galopago/misistemhil/README.md

# MISISTEMHIL

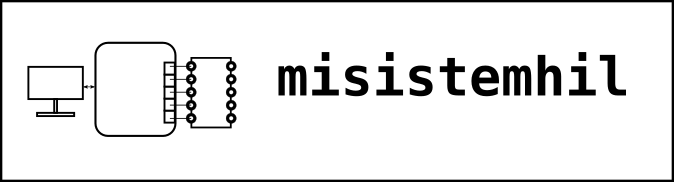
[picture p1: assets/img/misistemhil-logo.png]


## INTERFACE FOR AUTOMATED TESTS (HARDWARE-IN-THE-LOOP). SOLDERLESS, MODULAR AND OPEN SOURCE

Electronic hardware prototyping system. Solderless, robust and open source. Solves the typical problem of the circuit that works on a breadboard but stops working on a real-world setup. Easy to replicate and compatible with virtually every electronic module.

Misistemhil is an open source project by [Galopago](https://galopago.github.io/)
