galopago/misistemhil/b-hil-boards/b06_hil/firmware/docs/i2c_bus_architecture.md

# Generic Shared I2C Bus Architecture

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

Source handoff: `agent-workspaces/architect/handoff.md`, `I2C_BUS_ARCHITECTURE`.

Board electrical details for the current target remain in
`docs/esp32_c3_supermini_connections.md`.

## Normative Language

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

## Design Goals

1. **One bus owner.** Exactly one module initializes and owns the shared master
   bus.
2. **Device-agnostic bus.** The bus layer knows 7-bit addresses and opaque device
   handles, not OLED, INA219, or any other peripheral type.
3. **Deterministic implementer output.** File layout, API names, init order, and
   caching rules are fixed in this document.
4. **MCU portability.** Portable semantics are defined first; ESP-IDF is the current
   platform binding, not the architectural center.
5. **Optional peripherals.** Projects without INA219 omit that driver and its
   startup calls. The bus component stays unchanged.

## Three-Layer Model

```mermaid
flowchart TD
    subgraph portable [PortableLogicalLayer]
        I2cBusApi[i2c_bus public API]
        DeviceDrivers[device drivers]
    end
    subgraph boardLayer [BoardLayer per target]
        BoardPins[board pins and addresses]
        BoardHelper[board_i2c_bus_config]
    end
    subgraph platform [PlatformPort per MCU SDK]
        PlatformI2c[SDK I2C master driver]
    end
    AppCore[app_core startup] --> BoardHelper
    AppCore --> I2cBusApi
    AppCore --> DeviceDrivers
    BoardHelper --> I2cBusApi
    DeviceDrivers --> I2cBusApi
    I2cBusApi --> PlatformI2c
    BoardPins --> BoardHelper
```

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

## Fixed Component Layout

Implementations MUST use this layout:

```text
components/i2c_bus/
  CMakeLists.txt
  include/
    i2c_bus.h          # portable public contract
  i2c_bus.c            # portable logic + platform calls
```

Optional future split if a second MCU is added:

```text
components/i2c_bus/
  port/
    esp_idf/i2c_bus_port.c
    stub/i2c_bus_port.c
```

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

## Portable Public Contract

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

### Constants

```text
I2C_BUS_DEFAULT_FREQUENCY_HZ = 400000
I2C_BUS_MAX_DEVICES = 8
I2C_BUS_PROBE_TIMEOUT_MS = 50
I2C_BUS_ADDRESS_MIN = 0x08
I2C_BUS_ADDRESS_MAX = 0x77
```

7-bit addressing is mandatory. 10-bit addressing is out of scope.

### Types

```c
typedef struct {
    int scl_pin;              /* board-defined pin identifier */
    int sda_pin;              /* board-defined pin identifier */
    uint32_t bus_frequency_hz;
} i2c_bus_config_t;

typedef struct i2c_bus_device *i2c_bus_device_t;
```

Notes for implementers:

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

### Functions

```c
status_t i2c_bus_init(const i2c_bus_config_t *config);
status_t i2c_bus_add_device(uint8_t address, i2c_bus_device_t *out_device);
status_t i2c_bus_probe(uint8_t address, bool *present);
void i2c_bus_deinit(void);
```

`status_t` represents success or a platform-mapped error. In this tree the
implementer uses `esp_err_t`.

## Canonical Behavior

### State machine

```text
UNINITIALIZED
  -- i2c_bus_init(success) --> BUS_READY
BUS_READY
  -- i2c_bus_add_device(success) --> BUS_READY with cached device
  -- i2c_bus_probe(...) --> BUS_READY
  -- i2c_bus_deinit() --> UNINITIALIZED
```

Rules:

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

### `i2c_bus_init(config)`

Input validation:

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

Postconditions on success:

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

### `i2c_bus_add_device(address, out_device)`

Input validation:

- `out_device` MUST NOT be null.
- `address` MUST be within `0x08` to `0x77`.

Caching algorithm:

```text
add_device(address):
  if address already cached:
    return existing handle
  if device table full:
    return NO_MEM
  create platform device handle at address and effective bus frequency
  store in cache
  return handle
```

Rules:

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

### `i2c_bus_probe(address, present)`

Input validation:

- `present` MUST NOT be null.
- `address` MUST be within `0x08` to `0x77`.

Algorithm:

```text
probe(address):
  perform short master presence check with timeout I2C_BUS_PROBE_TIMEOUT_MS
  if device ACKs:
    present = true
    return success
  if no ACK / not found:
    present = false
    return success
  otherwise return transport error
```

Rules:

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

### Concurrency (baseline)

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

## Incremental Concurrency Architecture

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

Source handoff: `agent-workspaces/architect/handoff.md`, `I2C_BUS_CONCURRENCY`.

### Immutable rules (all phases)

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

### Problem classes

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

### Growth model

```mermaid
flowchart TD
    subgraph phase1 [Phase1_DirectSync]
        AppInit[app_core init] --> I2cBusDirect[i2c_bus init probe add_device]
    end
    subgraph phase2 [Phase2_TransactionExecutor]
        DisplayTask[display_task] --> Transceive[i2c_bus_transceive]
        SensorTask[sensor tasks] --> Transceive
        Transceive --> PortLayer[platform I2C + optional bus mutex]
    end
    subgraph phase3 [Phase3_Broker]
        DisplayTask2[display_task] --> Broker[i2c_broker]
        Ina219Task[ina219_task] --> Broker
        DiagHooks[diag hooks] --> Broker
        Broker --> Transceive2[i2c_bus_transceive executor]
        Transceive2 --> PortLayer2[platform I2C]
    end
```

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

`b06_hil` MUST be designed for phase 3, but implementers MUST deliver one phase
per authorized handoff.

### Phase 1 — Direct sync

Scope:

- `i2c_bus_init`, `i2c_bus_add_device`, `i2c_bus_probe`, `i2c_bus_deinit`
- Sequential startup in `app_core`

Rules:

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

Handoff ID: `I2C_BUS_PHASE1` (same scope as initial `I2C_BUS_ARCHITECTURE`
implementation).

### Phase 2 — Transaction executor

Add to the public contract:

```c
typedef struct {
    i2c_bus_device_t device;
    const uint8_t *tx;
    size_t tx_len;
    uint8_t *rx;
    size_t rx_len;
    uint32_t timeout_ms;
} i2c_transaction_t;

status_t i2c_bus_transceive(const i2c_transaction_t *txn);
```

Behavior:

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

Handoff ID: `I2C_BUS_PHASE2`.

### Phase 3 — Priority broker

Add component API:

```c
typedef enum {
    I2C_CLIENT_DISPLAY = 0,
    I2C_CLIENT_INA219,
    I2C_CLIENT_DIAG,
} i2c_client_id_t;

typedef struct {
    i2c_client_id_t client;
    uint8_t priority;
    i2c_transaction_t txn;
} i2c_broker_request_t;

status_t i2c_broker_start(void);
void i2c_broker_stop(void);
status_t i2c_broker_submit(const i2c_broker_request_t *req, uint32_t wait_ms);
```

Rules:

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

Recommended `b06_hil` priority table:

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

Policy rules:

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

Handoff ID: `I2C_BUS_PHASE3`.

### Phase 4 — Observability (optional)

Optional debug-only counters:

- requests submitted
- requests completed
- timeouts
- queue drops

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

Handoff ID: `I2C_BUS_PHASE4`.

### Growing component layout

Base layout:

```text
components/i2c_bus/
  include/i2c_bus.h
  i2c_bus.c
  CMakeLists.txt
```

Phase 2 adds transaction execution to `i2c_bus.c`.

Phase 3 adds:

```text
components/i2c_bus/
  include/i2c_broker.h
  i2c_broker.c
```

Optional future platform split:

```text
components/i2c_bus/
  port/esp_idf/i2c_bus_port.c
```

### Driver migration contract

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

The shape of `i2c_transaction_t` MUST remain stable across phases 2 and 3.

### Anti-patterns (forbidden)

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

## Board Integration Contract

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

Required helper:

```c
void board_i2c_bus_config(i2c_bus_config_t *out_config);
```

Behavior:

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

Example address macros for `b06_hil`:

```text
BOARD_OLED_ALLOWED = [0x3C, 0x3D]
BOARD_INA219_ADDRESSES = [0x40, 0x41, 0x42]
```

Other boards MAY omit INA219 macros entirely.

## Application Startup Contract

Startup MUST follow this order:

```text
1. board_i2c_bus_config()
2. i2c_bus_init()
3. for each enabled peripheral in this firmware:
     resolve address policy
     i2c_bus_add_device(address)
     pass handle to the device driver boundary
4. start higher-level services (display task, sensor tasks, etc.)
```

### Address resolution policy

Address discovery belongs to **application startup** or the **device driver
init path**, not to `i2c_bus` internals.

Canonical OLED policy for this repository:

```text
if display_config.has_address:
  use display_config.address
else:
  probe 0x3C
  if not present, probe 0x3D
  if found, set has_address = true
  if not found, continue without I2C device handle
```

Rules:

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

### `b06_hil` profile

| Step | Action |
| --- | --- |
| 1 | `board_i2c_bus_config()` using GPIO0/GPIO1 |
| 2 | `i2c_bus_init()` |
| 3 | Resolve OLED address with policy above |
| 4 | `i2c_bus_add_device(oled_address)` when found |
| 5 | Pass handle through `display_config_t` to `display_start()` |
| 6 | Future optional: register `0x40`, `0x41`, `0x42` for INA219 when component exists |

### Display-only profile

Steps 1 through 5 only. No INA219 component, no INA219 startup calls.

## Device Driver Boundary

Device drivers MUST receive an opaque `i2c_bus_device_t`. They MUST NOT call
`i2c_bus_init()` themselves.

### Display driver

Only `display_driver` in the display stack may consume the handle.

`display_config_t` MUST include:

```c
uint8_t address;
bool has_address;
i2c_bus_device_t i2c_device;
bool has_i2c_device;
```

Rules:

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

### Future INA219 driver (optional component)

Expected shape:

```c
status_t ina219_init(i2c_bus_device_t device, ...);
status_t ina219_read(i2c_bus_device_t device, ...);
```

After phase 2, read/write paths MUST use `i2c_bus_transceive`. After phase 3,
they MUST use `i2c_broker_submit`.

`b06_hil` expects three instances at `0x40`, `0x41`, and `0x42`. Other projects
omit the component.

## ESP-IDF 5.x Platform Profile (Current Target)

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

- Header: `driver/i2c_master.h`
- Bus create: `i2c_new_master_bus`
- Device add: `i2c_master_bus_add_device`
- Presence check: `i2c_master_probe`
- Bus delete: `i2c_del_master_bus`

Binding rules:

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

## Porting To Another Microcontroller

To port, keep these unchanged:

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

Replace only the platform port internals:

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

Porting checklist:

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

## Forbidden Dependencies

`i2c_bus` MUST NOT depend on:

- `display`, `display_driver`, renderer, canvas, controller
- future `ina219`
- application modules

`i2c_broker` MUST depend only on `i2c_bus` and RTOS primitives.

`display` renderer/controller/task MUST NOT depend on `i2c_bus` or `i2c_broker`.

`board` MAY depend on `i2c_bus` only for the config helper type, not for init.

## Non-Goals

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

## Acceptance Criteria

An implementation satisfies this architecture if:

- `components/i2c_bus/` matches the fixed layout and public contract for the
  active phase.
- Behavior matches the canonical algorithms, startup order, and active concurrency
  phase.
- `board` remains the source of pin and address constants for the PCB.
- `app_core` initializes the bus before display or sensor drivers.
- Display renderer/controller code contains no I2C or GPIO references.
- A display-only firmware reuses `i2c_bus` without source changes.
- `b06_hil` can attach OLED and INA219 clients to the same shared bus.
- Another LLM implementer can read only this document and produce substantially
  similar module boundaries, file paths, and runtime behavior.

### Phase acceptance criteria

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

## Suggested Validation

Implementer/build validation:

- Project builds on the current ESP-IDF target for the active phase only.

Tester/hardware validation:

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

Additional validation when peripherals exist:

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
