galopago/misistemhil/b-hil-boards/b03_hil/firmware/agent-workspaces/implementer/backlog.md

# Implementer backlog — `b03_hil`

- [x] Scaffold / pins / relay_ctrl / host v1+v2 / OE fix
- [x] Main relay OLED + view-mode `P`/`T`/`E` binding
- [x] **OLED column order** `1|4` / `2|5` / `3|6` (`B03_RELAY_OLED_COLUMN_ORDER`)
- [ ] Hand off to tester (visual column match vs hardware)
