galopago/misistemhil/b-hil-boards/b03_hil/firmware/agent-workspaces/architect/backlog.md

# Architect backlog — `b03_hil`

- [x] Import base docs + particular stubs
- [x] Fill hardware/functional from PCB
- [x] Freeze product / relay / host API architecture
- [x] OE level-before-direction RCA
- [x] Main relay OLED `N:[X]` layout
- [x] OLED view-mode binding for pulse/hold/train/encoder
- [ ] (After implementer+tester) close dynamic OLED token acceptance
- [ ] Absorb future `BASE-CHANGE-*` from `b00_basehil` when they appear
