galopago/misistemhil/b-hil-boards/b06_hil/firmware/agent-workspaces/architect/backlog.md

# Architect Backlog — `b06_hil`

- [x] Record `b06_hil` functional particularities
- [x] Record `b06_hil` hardware / pin map from `../pcb/`
- [x] Authorize `B06_MAIN_METERING_OLED` (INA219 + main OLED)
- [x] Freeze host API metering commands (`B06_HOST_API_METERING`)
- [x] Absorb `BASE-CHANGE-20261103-6` (4 MB flash docs; implementer owns csv/sdkconfig)
- [ ] Confirm BOM values (shunts, polyfuses, LED resistors) and OLED address
- [ ] Review implementer completion of `B06_MAIN_METERING_OLED` (tester evidence)
- [ ] Review implementer completion of `B06_HOST_API_METERING` when firmware lands
- [ ] Review implementer application of 4 MB `partitions.csv` / sdkconfig
