galopago/misistemhil/b-hil-boards/b00_basehil/firmware/agent-workspaces/architect/handoff.md

# Architect Handoff

All agentic development methodology documentation in this firmware tree is
maintained in English.

Before starting any task in this file, run the **Role Boundary Check**:

- Read `ROLE.md` in this folder, `../../AGENTS.md`, and `../../docs/methodology.md`.
- Confirm the request is **architecture and documentation**, not firmware
  implementation, builds, or formal validation.
- If the task includes code, tests, or flash steps, stop and tell the human that
  the implementer or tester must execute those parts unless explicitly
  redirected.

## Current Status

Active handoffs:

- `HOST_API_CAPABILITIES_ECHO_LOOPBACK` (**implementer package closed** 2026-11-03 — firmware pending)
- `EXTERNAL_HOST_API_V1_CONCEPT` (**docs complete** 2026-11-03 — firmware pending; extended by capabilities/demos)
- `OLED_CONNECTED_MDNS_HOSTNAME_LINE` (**implemented** 2026-11-03)
- `OLED_CONNECTED_IP_WIDTH_FIT` (**superseded by** `OLED_CONNECTED_MDNS_HOSTNAME_LINE`)
- `WIFI_FACTORY_RESET_MDNS_SAFE` (**implemented** 2026-11-03 — Run 025 fix)
- `OLED_TEXT_DISPLAY_INTERFACE`
- `I2C_BUS_ARCHITECTURE`
- `I2C_BUS_CONCURRENCY`
- `QR_ENCODER_INTERFACE`
- `DISPLAY_DELIVERY_CONTRACT`
- `WIFI_PROVISIONING_ARCHITECTURE`
- `WIFI_PROVISIONING_PORTAL_REACHABILITY`
- `WIFI_PROVISIONING_HTTP_STACK_SAFETY`
- `WIFI_PROVISIONING_HTTP_HEADER_BUDGET`
- `WIFI_PROVISIONING_POST_SUCCESS_COMMIT`
- `WIFI_PROVISIONING_SAVED_BOOT_RELIABILITY`
- `PRODUCT_BOOT_DISPLAY_AND_DYNAMIC_AP_SSID`
- `OLED_PROVISIONING_SETUP_UX`
- `OLED_WIFI_CONNECTED_STATUS`
- `ERROR_LED_WIFI_LINK_STATUS`
- `ERROR_LED_RUNTIME_LINK_STATUS`
- `WIFI_RUNTIME_RECONNECT`
- `WIFI_CONNECT_CYCLE_AND_ERROR_LED_V2`
- `WIFI_FACTORY_RESET_RUNTIME`
- `WIFI_PROVISIONING_FIRST_CONNECT_FAILURE_FLOW`
- `WIFI_PROVISIONING_FIRST_CONNECT_FAILURE_UX_V2` (**approved** 2026-06-28 — implementer authorized)
- `DEVICE_DISCOVERY_MDNS_V1`
- `HIL_BASE_REUSE_CONTRACT` (**docs complete** 2026-11-02; **pillars extension** 2026-11-02 — no implementer firmware work)

- `FLASH_4MB_LARGE_FACTORY` (**docs complete** 2026-11-03 — config already in tree;
  build/flash by implementer/tester)
- `HOST_API_AFTER_PORTAL_TEARDOWN` (**docs complete** 2026-11-03 — firmware pending;
  closes `TESTER_RETURN_HOST_API_AFTER_PROVISION` / Run 029)

Family reuse of this base (contracts-first, no submodule) is recorded in
`docs/hil_base_reuse_contract.md`. Base pillars (WiFi onboarding, network
detection, external host API) vs board particulars are delimited in
`docs/hil_base_platform_scope.md`; LLM propagation uses
`docs/hil_base_spec_changelog.md`. Summarized in `docs/architecture.md`.
I2C pins, OLED address candidates, `INA219` addresses, error LED polarity, and
factory reset switch polarity are recorded in
`docs/esp32_c3_supermini_connections.md`. Generic shared I2C bus structure and
incremental concurrency phases are recorded in
`docs/i2c_bus_architecture.md`. QR encoder rules and `http://IPv4` payload
profile are recorded in `docs/qr_encoder_interface.md`. Display delivery from
producers to the OLED stack is recorded in
`docs/display_delivery_contract.md`. WiFi provisioning AP, HTTP portal, NVS
credential storage, and factory-reset behavior are recorded in
`docs/wifi_provisioning_architecture.md`. The implementer must keep WiFi
provisioning display requests routed through `app_core` and must not couple
display internals to WiFi/network headers.

## HIL_BASE_REUSE_CONTRACT

```text
Role boundary check:
  Architect-owned documentation only. No components/, main/, sdkconfig, or
  idf.py. No implementer firmware tasks for this handoff.
ID: HIL_BASE_REUSE_CONTRACT
Date: 2026-11-02
Source:
  - Human request: document b00_basehil as shared family base for LLM reuse
    without git submodule or sub-repo packaging.
Objective:
  Record that this firmware tree is the shared HIL platform base: normative
  docs/contracts are the shared surface; local code is a reference
  implementation that sibling bNN_hil trees may read or adapt into their own
  firmware trees without build-time coupling.
Reason:
  The product line is a board family. Agents working on derivative boards must
  know what is shared, what is board-owned, how to consume base contracts, and
  that packaging via submodule/sub-repo/EXTRA_COMPONENT_DIRS is forbidden.
Authorized files:
  - docs/hil_base_reuse_contract.md (new)
  - docs/architecture.md
  - AGENTS.md
  - README.md
  - agent-workspaces/architect/handoff.md
  - agent-workspaces/architect/decisions.md
Expected changes:
  - Publish docs/hil_base_reuse_contract.md with mission, reuse model,
    shared vs board-owned surfaces, derivative agent brief, change ownership,
    and non-goals.
  - Add Shared Base Role section to docs/architecture.md with summary diagram
    and link to the contract.
  - Add short pointers in AGENTS.md and README.md.
  - Record this handoff and the architecture decision.
Module boundaries and contracts:
  - Shared platform behavior remains governed by existing normative docs under
    docs/ (provisioning, display, I2C, identity/mDNS, error LED, factory reset,
    methodology).
  - Board number, pins, PCB, and product-only features remain board-owned.
  - Derivative trees must not rewrite base contracts in place; family-wide
    contract changes are decided in b00_basehil.
Non-goals:
  - Creating firmware for b06_hil or other sibling boards.
  - Extracting a shared CMake/component package.
  - Changing role methodology or architect hard stop.
  - Marking any implementer code task as implemented.
Acceptance criteria:
  - docs/hil_base_reuse_contract.md exists and states contracts-first reuse
    with explicit rejection of submodule/sub-repo/build-path coupling.
  - docs/architecture.md summarizes the shared-base role and links the contract.
  - AGENTS.md and README.md point agents to the contract.
  - decisions.md records HIL_BASE_REUSE_CONTRACT.
  - No firmware source or build config files are modified by this handoff.
Open questions:
  - None.
```

## HIL_BASE_REUSE_CONTRACT — pillars and particular file separation

```text
Role boundary check:
  Architect-owned documentation only. No components/, main/, sdkconfig, or
  idf.py. Host API behavioral schemas remain pending in a reserved base doc.
ID: HIL_BASE_REUSE_CONTRACT (extension)
Date: 2026-11-02
Source:
  - Human request: document that this base repo keeps WiFi onboarding, network
    board detection, and external host communication methodology; particulars
    in each board repo; base vs particular in separate files; LLM-traceable
    base change propagation.
Objective:
  Delimit the three base pillars, require separate particular-spec files in
  board repos, reserve external_host_api_architecture.md as pillar 3 home, and
  add hil_base_spec_changelog.md so agents can find base deltas and sync them.
Authorized files:
  - docs/hil_base_platform_scope.md (new)
  - docs/hil_base_spec_changelog.md (new)
  - docs/hil_board_particular_spec_template.md (new)
  - docs/external_host_api_architecture.md (new; reserved / detail pending)
  - docs/hil_base_reuse_contract.md
  - docs/architecture.md
  - AGENTS.md
  - README.md
  - agent-workspaces/architect/handoff.md
  - agent-workspaces/architect/decisions.md
Expected changes:
  - Publish platform scope with pillars, particular surface, file separation,
    and LLM propagation workflow.
  - Publish append-only base changelog with BASE-CHANGE-20261102-1.
  - Publish particular-repo template including board_base_sync_log.md pattern.
  - Reserve external host API doc with open decisions listed.
  - Retarget reuse contract and architecture summary to the pillar model.
Non-goals:
  - Filling complete host API schemas in this extension.
  - Creating bNN_hil particular docs inside those board repos in this task.
  - Firmware or build work.
Acceptance criteria:
  - Three pillars are explicit in hil_base_platform_scope.md and reuse contract.
  - Base vs particular must use different files; template provided.
  - Changelog + sync-log workflow documented for LLM propagation.
  - external_host_api_architecture.md exists as sole family host API home.
Open questions:
  - Host API transport, schema, auth, and mandatory ops (listed in that doc).
```

## HIL_BASE_REUSE_CONTRACT — particular functional + hardware docs

```text
Role boundary check:
  Architect documentation only. No firmware edits.
ID: HIL_BASE_REUSE_CONTRACT (extension)
Date: 2026-11-02
Source:
  - Human request: each board needs a separate functional description (e.g.
    RS-485, relays, logic analyzer) and a separate hardware description
    (MCU may differ; pin map varies).
Objective:
  Require board_functional_description.md and board_hardware_description.md as
  mandatory, separate particular files; clarify they are not base pillars.
Expected changes:
  - Update particular template with required sections for both docs.
  - Update platform scope, reuse contract, architecture, AGENTS.md.
  - Append BASE-CHANGE-20261102-2.
Non-goals:
  - Authoring particular docs inside sibling board repos in this session.
  - Changing base MCU/pin docs for b00_basehil beyond referencing them as
    base-profile-only.
Acceptance criteria:
  - Template mandates separate functional and hardware particular docs.
  - Changelog entry instructs boards to create those files.
Open questions:
  - None for this extension.
```

## HIL_BASE_REUSE_CONTRACT — filled particular example for b00_basehil

```text
Role boundary check:
  Architect documentation only.
ID: HIL_BASE_REUSE_CONTRACT (extension)
Date: 2026-11-02
Source:
  - Human request: fill this repo's particular functional + hardware docs from
    existing pin/hardware records; mission = base reference with minimum
    human-supervised test hardware; preserve philosophy when copied elsewhere.
Objective:
  Create filled docs/board_functional_description.md and
  docs/board_hardware_description.md (plus scope, host extensions, sync log)
  specific to b00_basehil ESP32-C3 SuperMini bench.
Acceptance criteria:
  - Functional doc states base/reference + minimum human-supervised tests.
  - Hardware doc lists SuperMini, GPIO0/1/7/8, OLED addresses (no INA on base
    test profile) from docs/esp32_c3_supermini_connections.md and board_pins.h.
  - Template notes this tree as the copyable example.
  - BASE-CHANGE-20261102-3 recorded.
Open questions:
  - None.
```

## FLASH_4MB_LARGE_FACTORY

```text
Role boundary check: architect documentation only (no idf.py).
ID: FLASH_4MB_LARGE_FACTORY
Date: 2026-11-03
Source: Human — document flash/partition decision as lasting architecture base.
Objective: Normative record of 4MB flash + large single factory partition.
Authorized docs:
  - docs/flash_partition_architecture.md (new; authoritative)
  - docs/architecture.md, board_hardware_description.md
  - docs/hil_base_platform_scope.md, hil_base_reuse_contract.md
  - docs/hil_base_spec_changelog.md (BASE-CHANGE-20261103-6)
  - agent-workspaces/architect/handoff.md, decisions.md
  - docs/board_base_sync_log.md, board_particular_scope.md
Normative summary:
  - Flash 4MB; custom partitions.csv factory 0x3F0000 @ 0x10000; NVS 0x9000
  - No dual-OTA yet; siblings must not assume old 1MB factory
Config already present: partitions.csv, sdkconfig.defaults (and sdkconfig)
Build validation: implementer/tester only (architect does not compile).
Open questions: None.
```

## HOST_API_AFTER_PORTAL_TEARDOWN

```text
Role boundary check:
  Architect docs only. Firmware pending implementer.
ID: HOST_API_AFTER_PORTAL_TEARDOWN
Date: 2026-11-03
Source:
  - Tester Run 029 FAIL / TESTER_RETURN_HOST_API_AFTER_PROVISION
  - Human: improve architecture so implementer can fix post-reprovision host API
Objective:
  Host API must come up after SoftAP portal httpd releases port 80 without
  requiring a reboot; saved-boot path must keep working.
Diagnosis (normative):
  POST /provision success emits CONNECTED while SoftAP httpd still owns :80
  (2 s grace teardown). host_api_start() bind fails; error discarded; teardown
  frees port but nothing restarts host_api. Saved boot has no SoftAP httpd → PASS.
Wire contracts:
  - docs/external_host_api_architecture.md § Port 80 exclusivity
  - docs/wifi_provisioning_architecture.md § Deferred AP and HTTP teardown
  - BASE-CHANGE-20261103-5
Authorized files (implementer — pending):
  - components/wifi_provisioning/include/wifi_provisioning.h
      add WIFI_PROV_EVENT_PORTAL_TEARDOWN_COMPLETE
  - components/wifi_provisioning/wifi_provisioning.c
      emit that event at end of success_teardown_task after httpd_stop,
      STA-only mode, s_portal_active=false (do NOT call host_api from here)
  - components/app_core/app_core_wifi.c
      on PORTAL_TEARDOWN_COMPLETE + CONNECTED → host_api_start(); log ESP_LOGE
      on failure; CONNECTED-path host_api_start may WARN if bind fails while
      portal httpd still up; do not rely on that alone for POST path
  - agent-workspaces/implementer/handoff.md notes
Non-goals:
  - Merging SoftAP and STA into one httpd
  - Moving host API off port 80 in this fix
  - Requiring reboot after POST success
Acceptance (firmware + tester):
  1. Factory reset + POST provision, NO reboot: after teardown (~2 s + margin),
     TCP :80 accepts; curl ping on HIL-00-XXXX.local or STA IP succeeds.
  2. Saved-credential cold boot: host_api started still PASS (Run 028 regression).
  3. SoftAP portal path: no /v1 while portal httpd up.
  4. Serial shows host API started after portal teardown on POST path
     (not only on cold boot).
Open questions:
  - None.
```

## HOST_API_CAPABILITIES_ECHO_LOOPBACK

```text
Role boundary check:
  Architect documentation only for this update. Firmware is pending
  implementer (do not write components/ or main/ from architect role).
ID: HOST_API_CAPABILITIES_ECHO_LOOPBACK
Date: 2026-11-03
Source:
  - Human: agent must ask the board (not the repo); base FW demos echo +
    loopback; close handoff so implementer cannot diverge on structure.
Objective:
  Implementation-ready family host API + b00 demos (ask-the-board).
Wire contracts (normative behavior):
  - docs/external_host_api_architecture.md
  - docs/external_host_command_api.md
  - docs/external_host_stream_api.md
  - docs/board_host_api_extensions.md
Follow-on: HOST_API_AFTER_PORTAL_TEARDOWN required before POST-provision
  path is accepted (Run 029).
```

### Implementer package (firmware — PENDING)

Temporary shared-file owner for this handoff: **implementer**.

#### Expected new files

```text
components/host_api/CMakeLists.txt
components/host_api/include/host_api.h
components/host_api/host_api.c              # httpd lifecycle + route registration
components/host_api/host_api_command.c      # POST /v1/command dispatch + handlers
components/host_api/host_api_stream.c       # POST /v1/stream/* + loopback queue
components/host_api/host_api_capabilities.c # embedded b00 manifest (const data)
```

Do **not** put host API handlers inside `wifi_provisioning` or `display`.
Do **not** add routes to the SoftAP portal httpd instance.

#### Expected edited files

```text
components/app_core/CMakeLists.txt          # REQUIRES host_api
components/app_core/app_core_wifi.c         # start/stop host_api with discovery window
agent-workspaces/implementer/handoff.md     # record implementation notes
```

`main/` stays thin: no host_api calls from `app_main.c` (orchestration stays in
`app_core`).

#### Public C API (`host_api.h`)

```c
#pragma once
#include "esp_err.h"
#include <stdbool.h>

#ifdef __cplusplus
extern "C" {
#endif

/** Start STA host API HTTP server on port 80. Idempotent if already running. */
esp_err_t host_api_start(void);

/**
 * Stop host API, close any stream session, free RX queue.
 * reason: short log tag only ("link_lost", "portal", "shutdown", …).
 * Idempotent if already stopped.
 */
esp_err_t host_api_stop(const char *reason);

bool host_api_is_running(void);

#ifdef __cplusplus
}
#endif
```

No other public symbols required in v1.

#### HTTP stack (decided)

- Use **ESP-IDF `esp_http_server`** (`httpd_*`), same family as SoftAP portal but
  a **separate** `httpd_handle_t` owned by `host_api`.
- Listen on port **80** only while STA has IPv4 (portal SoftAP also uses 80; the
  two modes MUST never run concurrently — same rule as today for portal vs STA).
- Register URI handlers (method POST):
  - `/v1/command`
  - `/v1/stream/open`
  - `/v1/stream/close`
  - `/v1/stream/write`
  - `/v1/stream/read`
- Request body: JSON; response: JSON `Content-Type: application/json`.
- Application errors: HTTP **200** + `"ok": false` per architecture doc.
- Parse/build JSON with **cJSON** (IDF component). Base64 with
  **mbedtls_base64_encode** / **mbedtls_base64_decode**.
- One global mutex inside `host_api` serializes all `/v1` handlers (commands and
  stream). Concurrent second request MAY wait on the mutex or return `busy` if
  wait would exceed ~100 ms — prefer **return `busy`** if lock not acquired
  within 100 ms (deterministic for agents).

#### Lifecycle (decided — mirror mDNS window)

Hook in `sync_device_discovery()` in `app_core_wifi.c` (same function that
starts/stops `device_discovery`):

| Condition | Action |
| --- | --- |
| `link_status == WIFI_LINK_STATUS_CONNECTED` | `device_discovery_start()` then `host_api_start()` |
| Leaving CONNECTED (was connected) | `host_api_stop("link_lost")` then `device_discovery_stop("link_lost")` |
| `WIFI_PROV_EVENT_AP_STARTED` or `PORTAL_READY` | `host_api_stop("portal")` then existing `device_discovery_stop("portal")` |

Do **not** call `host_api_stop` from the factory-reset erase path before portal
transition in a way that blocks erase; stopping on `AP_STARTED`/`PORTAL_READY`
is sufficient (same lesson as Run 025 / mDNS).

Host API MUST be down whenever SoftAP portal httpd is up.

#### Constants (b00)

| Symbol / value | Value |
| --- | --- |
| `board_id` | `"b00_basehil"` |
| `board_number` | `"00"` |
| Command timeout | 5000 ms (handler wall time) |
| Echo `text` max | 128 bytes |
| Frame max decoded | 1024 bytes |
| Loopback RX queue depth | **16** frames |
| Stream session string | `"1"` while open (v1 single session) |
| `info.streams_supported` | `true` |

`identity` in `info`: from `device_identity_get()` (no `.local`).
`sta_ipv4` in `info`: current STA IPv4 string, or `""` if unavailable.

#### Command handlers (required)

| name | Behavior |
| --- | --- |
| `ping` | `{ "pong": true }` |
| `info` | Mandatory fields per command API |
| `capabilities` | Return embedded manifest below as `result` (object, not string) |
| `echo` | Require `args.text` string ≤128; echo in `result.text` |

Unknown `name` → `unknown_command`.

#### Stream `loopback` (required on b00)

1. `open` with `stream_id=="loopback"` and `params` object (may be `{}`); reject
   other ids with `unknown_stream`; if already open → `busy`.
2. `write`: decode Base64; if length 0..1024 enqueue copy on RX FIFO; return
   `bytes_written`.
3. `read`: per stream API (`max_frames` 1..16, `timeout_ms` 0..5000); FIFO out.
4. On RX overflow (17th frame): drop **oldest**, enqueue new.
5. `close`: clear queue; idempotent.

#### Normative `capabilities` result for b00 (exact catalog)

Implementer MUST return a `result` object semantically equal to this catalog
(field order in JSON MAY vary; names/types/summaries MUST match):

```json
{
  "api_version": 1,
  "board_id": "b00_basehil",
  "summary": "Family base HIL bench with host API demos (echo, loopback)",
  "commands": [
    {
      "name": "ping",
      "summary": "Liveness check",
      "args": [],
      "result": [{ "name": "pong", "type": "bool" }]
    },
    {
      "name": "info",
      "summary": "Identity and STA network snapshot",
      "args": [],
      "result": [
        { "name": "api_version", "type": "int" },
        { "name": "board_id", "type": "string" },
        { "name": "board_number", "type": "string" },
        { "name": "identity", "type": "string" },
        { "name": "sta_ipv4", "type": "string" },
        { "name": "streams_supported", "type": "bool" }
      ]
    },
    {
      "name": "capabilities",
      "summary": "Return this capability manifest",
      "args": [],
      "result": [
        { "name": "api_version", "type": "int" },
        { "name": "board_id", "type": "string" },
        { "name": "summary", "type": "string" },
        { "name": "commands", "type": "object" },
        { "name": "streams", "type": "object" }
      ]
    },
    {
      "name": "echo",
      "summary": "Round-trip a short text string",
      "args": [
        { "name": "text", "type": "string", "required": true, "notes": "max 128 bytes" }
      ],
      "result": [{ "name": "text", "type": "string" }]
    }
  ],
  "streams": [
    {
      "stream_id": "loopback",
      "summary": "Echo written frames back on read (no DUT UART)",
      "params": [],
      "payload": "opaque bytes; write enqueues identical payload for read; max 1024 per frame"
    }
  ]
}
```

Preferred implementation: build from static C descriptors in
`host_api_capabilities.c`, or a single `const char` JSON parsed once — either is
fine if the response matches.

#### Acceptance criteria (firmware)

1. SoftAP portal unchanged; no `/v1` on SoftAP.
2. After STA+IPv4: `ping`, `info`, `capabilities`, `echo` succeed via
   `http://HIL-00-<MAC4>.local/v1/command` (or STA IP).
3. `capabilities` lists `echo` and `loopback` as above; `info.streams_supported`
   is true.
4. `loopback` open → write Base64 `AQID` → read returns one frame with those
   bytes → close.
5. `host_api_stop` on link loss / portal; `host_api_start` only when connected.
6. No raw TCP :9000; no WebSocket.
7. Implementer notes recorded under this ID in
   `agent-workspaces/implementer/handoff.md`; status **implemented** only after
   the above work lands (tester validates on hardware separately).

#### Non-goals (implementer must not do)

- Auth, TLS, OpenAPI UI, TCP data port, UART DUT backend on b00
- Reading Markdown at runtime for capabilities
- Merging SoftAP and STA httpd into one process that serves both modes at once

```text
Open questions:
  - None — structure, API, lifecycle, and b00 manifest fixed above.
```

## EXTERNAL_HOST_API_V1_CONCEPT

```text
Role boundary check:
  Architect documentation only for this handoff slice. Firmware is pending
  implementer (do not mark host API as implemented in code from this session).
ID: EXTERNAL_HOST_API_V1_CONCEPT
Date: 2026-11-03
Source:
  - Human: conceive lightweight LLM-friendly mechanisms for (1) slow commands
    with response and (2) streaming binary digital frames (e.g. serial).
  - Human correction: primary client IS the LLM agent (not a blocking TCP tool).
Objective:
  Normative family host API: HTTP JSON only — commands + agent-bounded stream
  open/close/write/read (Base64 frames).
Authorized files (architect):
  - docs/external_host_api_architecture.md
  - docs/external_host_command_api.md (new)
  - docs/external_host_stream_api.md (new)
  - docs/hil_base_platform_scope.md
  - docs/hil_base_reuse_contract.md
  - docs/architecture.md
  - docs/hil_board_particular_spec_template.md
  - docs/board_host_api_extensions.md
  - docs/hil_base_spec_changelog.md (BASE-CHANGE-20261103-2, -3)
  - agent-workspaces/architect/handoff.md, decisions.md
  - agent-workspaces/implementer/handoff.md (pending firmware tasks only)
Normative summary:
  - Primary client: LLM agent; active only on STA+IPv4; no auth/TLS v1
  - POST /v1/command — sync 5 s; mandatory ping, info (later + capabilities)
  - POST /v1/stream/open|close|write|read — one session; Base64 payload max
    1024 decoded bytes; read with timeout_ms / max_frames
  - Raw TCP :9000 and WebSocket are non-goals for v1 (optional later for
    non-agent tools; must not replace HTTP write/read)
  - Particulars extend names/stream_ids; runtime catalog via capabilities
    (see HOST_API_CAPABILITIES_ECHO_LOOPBACK)
Pending implementer (firmware — not done by architect):
  - See HOST_API_CAPABILITIES_ECHO_LOOPBACK pending list (supersedes stubs-only)
Acceptance (docs):
  - Three host API docs exist and cross-link; agent-primary + no TCP data plane
  - Family pointers + changelog + particular template updated
  - Implementer tasks listed as pending, not implemented
Open questions:
  - None for v1 concept (auth/async jobs / optional WS-TCP high-throughput
    deferred).
```

## OLED_CONNECTED_MDNS_HOSTNAME_LINE

```text
Role boundary check:
  Architect normative docs. Firmware change belongs to implementer.
ID: OLED_CONNECTED_MDNS_HOSTNAME_LINE
Date: 2026-11-03
Source:
  - Human: add mDNS announce hostname on connected OLED between WIFI OK and IP.
  - Extends/supersedes OLED_CONNECTED_IP_WIDTH_FIT (IP truncation + font budget).
Objective:
  Connected WiFi OLED shows five lines: WIFI OK, mDNS/SoftAP identity hostname,
  full STA IPv4, STA MAC split across two lines — all readable (MEDIUM font).
Screen layout (normative):
  Line 0: WIFI OK
  Line 1: device_identity_get() string, e.g. HIL-00-24CE
          - Same string as SoftAP SSID / mDNS hostname
          - MUST NOT append .local on OLED
  Line 2: sta_ipv4 (full, up to 15 chars)
  Line 3: sta_mac[0..7]  (XX:XX:XX)
  Line 4: sta_mac[9..16] (XX:XX:XX)
Display template:
  - Add DISPLAY_TEMPLATE_FULL_FIVE_LINES
  - display_layout_template_full_five_lines(layout, lines, count)
  - font_policy DISPLAY_FONT_MEDIUM (not AUTO_FIT)
  - Bands: y=0/12/24/36 height 12; y=48 height 16
  - Wire show_template switch in display_controller.c
app_core_wifi:
  - show_wifi_connected_display(): build 5 lines as above
  - Call app_core_display_show_template(DISPLAY_TEMPLATE_FULL_FIVE_LINES, ...)
  - Obtain hostname via device_identity_get() into a local buffer
  - app_core CMake MUST REQUIRE device_identity if not already transitive
  - Fallback if identity or IP/MAC missing: keep existing FULL_TWO_LINES WIFI/OK
String budget (unchanged):
  - MEDIUM = 16 chars max on 128 px; IPv4 15 and HIL-00-XXXX 11 fit
Authorized files (implementer):
  - components/display/include/display_types.h
  - components/display/include/display_layout_templates.h
  - components/display/display_layout_templates.c
  - components/display/display_controller.c
  - components/app_core/app_core_wifi.c
  - components/app_core/CMakeLists.txt (device_identity if needed)
  - agent-workspaces/implementer/handoff.md
Normative docs (architect done):
  - docs/oled_text_display_interface.md
  - docs/device_discovery_mdns_architecture.md
  - docs/architecture.md / docs/test_strategy.md as needed
Acceptance criteria:
  1. Build succeeds.
  2. On STA connected: OLED shows five lines in the order above.
  3. Line 1 matches SoftAP SSID / serial mdns hostname (no .local).
  4. Line 2 shows complete STA IPv4 (no truncation of last octets).
  5. Lines 3–4 still show split STA MAC as today.
  6. Operator can visually confirm hostname matches what resolves as .local.
Non-goals:
  - Showing .local on OLED
  - QR on connected screen, scrolling, ellipsis, IPv6
  - Width-aware AUTO_FIT engine (backlog)
  - Changing provisioning QR setup layouts
Open questions:
  - None.
```

## OLED_CONNECTED_IP_WIDTH_FIT

```text
Role boundary check:
  Architect normative docs. Firmware change belongs to implementer.
ID: OLED_CONNECTED_IP_WIDTH_FIT
Date: 2026-11-03
Status: SUPERSEDED by OLED_CONNECTED_MDNS_HOSTNAME_LINE (same implementer
  delivery: MEDIUM font + connected screen layout).
Summary: Documented glyph budgets; four-line MEDIUM-only path replaced by
  five-line FULL_FIVE_LINES connected screen that also fixes IP truncation.
Open questions:
  - None.
```

## WIFI_FACTORY_RESET_MDNS_SAFE

```text
Role boundary check:
  Architect clarified normative docs. Firmware fix belongs to implementer.
ID: WIFI_FACTORY_RESET_MDNS_SAFE
Date: 2026-11-03
Source:
  - agent-workspaces/tester/handoff.md TESTER_RETURN_FACTORY_RESET_MDNS_HANG
  - Run 025 / feedback Entry 029
Objective:
  Make GPIO7 runtime factory reset succeed when STA is connected and mDNS is
  announcing: erase NVS and open SoftAP portal without hanging in
  device_discovery_stop / mdns_unregister_netif.
Reason:
  Normative factory-reset sequence was erase → portal, clear for portal/connect-
  cycle (Run 021). As-built later inserted blocking device_discovery_stop before
  erase; STA+mDNS hang left credentials intact. Architecture did not forbid that
  ordering until this clarification.
Authorized files (implementer):
  - components/app_core/app_core_wifi.c (factory_reset_runtime_sequence order)
  - components/device_discovery/device_discovery.c (bounded/non-hanging stop if needed)
  - docs/wifi_factory_reset_implementation_reference.md (update as-built after fix)
  - agent-workspaces/implementer/handoff.md
Normative docs (architect done):
  - docs/wifi_factory_reset_architecture.md
  - docs/device_discovery_mdns_architecture.md
  - docs/test_strategy.md
Expected implementer behavior:
  1. MUST NOT block erase/portal behind discovery_stop while STA+mDNS active.
  2. Prefer erase → factory_reset_to_portal; let AP_STARTED stop discovery with
     reason portal; or stop discovery only after STA down, non-blocking.
  3. discovery_stop MUST return in bounded time; erase proceeds even if stop skips.
Acceptance criteria:
  - STA + mDNS active → GPIO7 ≥ 10 s → serial shows erase + portal_active; no hang.
  - Reboot does not reconnect with old NVS credentials.
  - SoftAP portal + OLED setup UX.
  - Run 021 portal/connect-cycle reset still PASS (regression).
Non-goals:
  - Changing 10 s hold duration or GPIO polarity.
  - Web-based credential erase.
Open questions:
  - None.
```

## HIL_BASE_REUSE_CONTRACT — I2C extra devices on daughter boards

```text
Role boundary check:
  Architect documentation only. No driver or board_pins.h edits.
ID: HIL_BASE_REUSE_CONTRACT (extension)
Date: 2026-11-03
Source:
  - Human: clarify that INA/other I2C product devices belong on daughter boards;
    base test bench has none; do not damage shared I2C architecture.
Objective:
  Make ownership explicit: i2c_bus = base; extra slaves = particular optional
  components documented per board.
Acceptance criteria:
  - connections + i2c_bus docs no longer require INA on b00_basehil bench.
  - platform scope states I2C ownership split.
  - BASE-CHANGE-20261103-1 recorded.
  - No firmware/driver changes.
Open questions:
  - None.
```

## TESTER_RETURN_SAVED_BOOT_RELIABILITY

```text
Role boundary check:
  Tester evidence and recommendations only. Architect decides criteria and whether
  to authorize a new implementer handoff. Tester does not change architecture.
ID: TESTER_RETURN_SAVED_BOOT_RELIABILITY
Date: 2026-06-24
Source:
  - agent-workspaces/tester/test_runs.md Run 013
  - agent-workspaces/tester/feedback.md Entries 011, 012, 013
  - agent-workspaces/tester/handoff.md Architect review block
Firmware: b00_basehil_firmware.bin 0xdcb20 (WIFI_PROVISIONING_POST_SUCCESS_COMMIT)
Operator network: SSID vitriolina, WPA3-SAE, IP 192.168.80.184 when connected

What PASSES:
  - POST /provision: browser "WiFi connected. You can close this page."
  - AP b06_hil_setup stops after success; OLED WIFI OK on submit.
  - NVS credentials saved; ping to assigned IP works when boot connects.
  - Run 012 split-brain regression (blank page / early OLED OK) resolved.

What FAILS or is QUALIFIED:
  - Saved-credential cold boot reliability: 3/5 reboots fail, 2/5 pass (same NVS).
  - Failure: auth -> init, wifi_prov STA disconnected reason=202 (AUTH_FAIL) ~1 s.
  - OLED: WIFI CONNECTING → after ~30 s WIFI FAILED (locked path per architecture).
  - test_strategy criterion "reboot with saved valid credentials connects STA"
    is not met reliably on this bench.

Root cause analysis (code + serial, not bad credentials):
  1. POST uses WIFI_MODE_APSTA with WiFi already running; saved boot uses STA-only
     cold esp_wifi_start() — different connect context.
  2. wait_for_sta_connected() calls esp_wifi_connect() once, waits 30 s for
     IP_EVENT_STA_GOT_IP; no application retry loop before SAVED_FAILURE_LOCKED.
  3. apply_sta_config sets threshold.authmode = WIFI_AUTH_WPA2_PSK; successful
     connects negotiate WPA3-SAE with operator router — intermittent first-auth
     fail on cold boot is plausible.
  4. After timeout, s_pending_sta_source cleared; late GOT_IP ignored by handler.

Recommendations for architect:
  A. Acceptance criteria: require N consecutive cold-boot successes? Define N.
  B. Supported routers: WPA2-only vs WPA3-SAE / transition mode for v1.
  C. Saved-boot policy: retry N times with backoff before locked FAILED?
  D. Implementation (if authorized): authmode/PMF, post-start delay, explicit
     reconnect policy, document interaction with ESP-IDF auto-reconnect.
  E. Do not weaken POST success commit; address saved-boot path separately.

Open questions:
  - Is intermittent saved-boot failure acceptable in v1 if POST works?
  - Should architecture mandate retry before HOLD RESET locked state?

Evidence files:
  /tmp/b06_hil_reboot_sweep_run013.txt
  /tmp/b06_hil_boot_log_run013_post_human.txt
  /tmp/b06_hil_boot_log_run013_reboot.txt

Architect decision:
  - Intermittent saved-credential boot failure is not acceptable in v1.
  - v1 must support WPA2-Personal, WPA2/WPA3 transition, and WPA3-SAE Personal.
  - A new implementer handoff is authorized:
    WIFI_PROVISIONING_SAVED_BOOT_RELIABILITY.
```

## WIFI_PROVISIONING_SAVED_BOOT_RELIABILITY

```text
Role boundary check:
  This handoff is architect-owned corrective architecture. Firmware code, build,
  flash, and validation belong to implementer/tester.
ID: WIFI_PROVISIONING_SAVED_BOOT_RELIABILITY
Source evidence:
  - tester/feedback.md Entry 013
  - tester/test_runs.md Run 013
  - tester/handoff.md Architect review block
  - architect/handoff.md TESTER_RETURN_SAVED_BOOT_RELIABILITY
Objective:
  Make saved-credential cold boot reliable after successful provisioning. The same
  known-good NVS credentials must connect consistently across repeated STA-only
  boots, including on WPA2/WPA3/WPA3-SAE Personal routers.
Reason:
  Run 013 POST success path passed: browser success, AP teardown, OLED OK, and ping
  worked when connected. Saved-credential cold boot was intermittent: 2/5 boots got
  IP, 3/5 failed early with `WIFI_REASON_AUTH_FAIL` reason 202. Credentials and RF
  signal are not the root cause because the same saved credentials connect on
  successful boots and after POST provisioning.
Authorized files:
  - docs/wifi_provisioning_architecture.md
  - docs/test_strategy.md
  - agent-workspaces/architect/handoff.md
  - agent-workspaces/architect/decisions.md
  - components/wifi_provisioning/wifi_provisioning.c
  - components/wifi_provisioning/include/wifi_provisioning.h only if event details
    need extension
  - components/app_core/app_core_wifi.c only if saved-boot retry states need clearer
    neutral event display mapping
  - agent-workspaces/implementer/handoff.md for implementation notes
  - agent-workspaces/implementer/backlog.md for task status
Expected changes:
  - Use the same STA config helper for submitted and saved attempts.
  - Configure STA for WPA2/WPA3/WPA3-SAE Personal compatibility on ESP-IDF 5.3:
    PMF capable true, PMF required false for v1 transition compatibility, and SAE
    PWE compatibility mode where available.
  - Log STA auth compatibility once per config application.
  - Add cold-start settle delay of 1000 ms after `esp_wifi_start()` before saved
    boot attempt 1.
  - Replace single saved `esp_wifi_connect()` with application retry policy:
    max_attempts=5, per_attempt_timeout_ms=12000, backoff_ms=[0,1000,3000,5000,8000].
  - End an attempt promptly on early disconnect reason; do not wait full timeout
    after reason 202.
  - Emit `WIFI_PROV_EVENT_SAVED_FAILURE_LOCKED` only after all saved attempts fail.
  - Preserve POST success commit, AP teardown, stack safety, and header-budget fixes.
Module boundaries and contracts:
  - Follow docs/wifi_provisioning_architecture.md Saved Boot Reliability Contract.
  - Preserve neutral event and display boundaries.
Detailed behavior:
  - Required logs:
    - `STA config auth_profile=wpa2_wpa3_personal pmf_capable=true pmf_required=false`
    - `saved boot connect policy attempts=5 per_attempt_timeout_ms=12000`
    - `saved boot attempt <n>/5 start`
    - `STA disconnected reason=<reason> source=saved attempt=<n>/5`
    - `saved boot attempt <n>/5 failed reason=<reason> backoff_ms=<ms>`
    - `STA got IP ip=<ipv4> source=saved attempt=<n>/5`
    - `saved boot connected attempt=<n>/5 ip=<ipv4>`
    - `saved boot failed attempts=5 last_reason=<reason>`
  - If ESP-IDF auto-reconnect/failure_retry_cnt is used, it must stay bounded by
    the application policy and must not hide attempt boundaries.
Non-goals:
  - Automatic AP fallback after saved-credential failure.
  - Erasing credentials after saved-credential failure.
  - Enterprise WiFi, captive upstream portals, HTTPS, or AP password changes.
Acceptance criteria:
  - 10 consecutive saved-credential cold boots pass after successful provisioning.
  - 0/10 boots end in locked failure.
  - Reason 202 may appear only if a later attempt within the same boot recovers and
    logs saved GOT_IP before policy exhaustion.
  - At least one accepted sweep is against WPA2/WPA3 transition or WPA3-SAE
    Personal, matching the current bench router profile.
  - Static audits from WiFi Provisioning Criteria remain PASS.
Constraints:
  - Do not log passwords.
  - Do not weaken POST success commit or reopen AP automatically on saved failure.
Validation plan:
  - Implementer documents auth profile config, retry constants, build result, and
    any local retry evidence.
  - Tester provisions once, confirms POST success, then runs 10 cold reboots with
    serial capture summary per boot.
Open questions:
  - None.
```

## PRODUCT_BOOT_DISPLAY_AND_DYNAMIC_AP_SSID

```text
Role boundary check:
  This handoff is architect-owned product architecture. Firmware code, build,
  flash, and validation belong to implementer/tester.
ID: PRODUCT_BOOT_DISPLAY_AND_DYNAMIC_AP_SSID
Source:
  - Human request 2026-06-23: remove display demo calls and generate AP SSID as
    HIL-00-<last4mac>, with `00` dynamic from the project folder.
Objective:
  Remove historical display demo/test screens from normal product boot and replace
  the fixed provisioning AP SSID with a deterministic board/MAC-derived name.
Reason:
  Display demo content (`QR_SETUP`, `TEXT ONLY`, `DEMO_STEP`, smoke screens) was
  useful to validate the OLED stack but is not product UX. The provisioning AP name
  must identify the HIL board family, board number, and physical device instance
  without being hard-coded to `b06_hil_setup`.
Authorized files:
  - docs/display_visual_demo_protocol.md
  - docs/wifi_provisioning_architecture.md
  - docs/architecture.md
  - docs/test_strategy.md
  - agent-workspaces/architect/handoff.md
  - agent-workspaces/architect/decisions.md
  - components/app_core/CMakeLists.txt
  - components/app_core/Kconfig
  - components/app_core/app_core.c
  - components/app_core/app_core_display_demo.c
  - components/app_core/include/app_core_display_demo.h
  - firmware/sdkconfig.defaults
  - components/board/include/board_pins.h or equivalent board-owned config header
  - components/wifi_provisioning/CMakeLists.txt
  - components/wifi_provisioning/wifi_provisioning.c
  - agent-workspaces/implementer/handoff.md for implementation notes
  - agent-workspaces/implementer/backlog.md for task status
Expected changes:
  Display demo retirement:
    - Remove boot/runtime calls to `app_core_run_visual_demo()` and
      `app_core_run_display_smoke()`.
    - Remove `CONFIG_B00_BASEHIL_DISPLAY_VISUAL_DEMO` from `sdkconfig.defaults`.
    - Remove demo source/header/Kconfig/CMake references if no longer used.
    - Preserve real product display APIs:
      `app_core_display_show_template()` and `app_core_display_show_qr_setup()`.
    - Product boot must not emit `DEMO_STEP` logs or show demo-only `SCAN/ME` or
      `TEXT/ONLY` content.
  Dynamic AP SSID:
    - Replace fixed `b06_hil_setup` with runtime-generated
      `HIL-<board_number_2_digits>-<last_4_softap_mac_hex>`.
    - For this tree, the board number is `00`, derived from project identifier
      `b00_basehil`.
    - The board component owns the board number constant/helper; `wifi_provisioning`
      must not hard-code `00` or parse filesystem paths at runtime.
    - Use the ESP32 WiFi SoftAP MAC address; suffix is the last two MAC bytes as
      uppercase hex with no separators, e.g. `HIL-00-ABCD`.
    - Log the generated SSID at SoftAP startup.
Module boundaries and contracts:
  - Board identity belongs to `components/board`.
  - WiFi provisioning may consume board identity but must continue to avoid display
    and app_core dependencies.
  - Display demo removal must not remove WiFi provisioning QR/status display paths.
Non-goals:
  - Changing portal URL (`http://192.168.4.1/` remains).
  - Adding AP password, captive DNS, HTTPS, or web UI redesign.
  - Removing QR generation used by the real WiFi provisioning setup screen.
Acceptance criteria:
  - Clean build succeeds.
  - No `DEMO_STEP` logs during normal product boot.
  - No product boot call path invokes `app_core_run_visual_demo` or
    `app_core_run_display_smoke`.
  - `sdkconfig.defaults` does not contain `CONFIG_B00_BASEHIL_DISPLAY_VISUAL_DEMO`.
  - Fresh provisioning AP SSID matches `HIL-00-[0-9A-F]{4}`.
  - Serial log shows generated SoftAP SSID and no `b06_hil_setup` product string.
  - WiFi provisioning QR/status/success/failure display behavior still works from
    real provisioning events.
Validation plan:
  - Implementer documents removed files/references and generated SSID example.
  - Tester boots fresh-NVS firmware, confirms no demo logs/screens, confirms AP
    name pattern, and confirms portal remains reachable at `http://192.168.4.1/`.
Open questions:
  - None.
```

## OLED_PROVISIONING_SETUP_UX

```text
Role boundary check:
  This handoff is architect-owned product UX architecture. Firmware code, build,
  flash, and validation belong to implementer/tester.
ID: OLED_PROVISIONING_SETUP_UX
Source:
  - Human request 2026-06-23: when no WiFi credentials are saved, keep the
    setup QR (http://192.168.4.1) on the OLED left and show the provisioning AP
    SSID plus short numbered instructions on the right.
  - Extends PRODUCT_BOOT_DISPLAY_AND_DYNAMIC_AP_SSID (dynamic SSID already
    generated; not yet shown on OLED).
Objective:
  Replace the generic WIFI/SETUP right-panel text with a four-line provisioning
  guide that shows the full SoftAP SSID (split across two lines) and tells the
  user to join that network then scan the QR.
Reason:
  Users could not identify which AP to join because the OLED did not show the
  HIL-00-XXXX SSID. Generic WIFI/SETUP does not communicate the required
  two-step flow (join AP, then scan portal QR).
Authorized files (implementer only):
  - components/wifi_provisioning/wifi_provisioning.c
  - components/app_core/app_core_wifi.c
Normative specs (already updated by architect):
  - docs/wifi_provisioning_architecture.md — Display Integration
  - docs/display_delivery_contract.md — Product provisioning QR setup
  - docs/oled_text_display_interface.md — Golden 6
Expected changes (implementer):
  wifi_provisioning.c:
    - In wifi_provisioning_start_ap_portal(), change emit_event for
      WIFI_PROV_EVENT_AP_STARTED and WIFI_PROV_EVENT_PORTAL_READY to pass
      s_ap_ssid as the third argument instead of NULL.
    - No new public APIs. No display includes.
  app_core_wifi.c:
    - Add static helper (name implementer choice, e.g.
      show_provisioning_setup_display) that:
        1. Reads setup_url from event (fallback "http://192.168.4.1").
        2. If info->ssid is NULL or strlen < 8: show_qr_setup(url, WIFI/SETUP, 2).
        3. Else build 4 lines per docs/display_delivery_contract.md table.
        4. Use #define PROV_SETUP_LINE_JOIN "1 JOIN",
           PROV_SETUP_LINE_SCAN_QR "2 SCAN QR", PROV_SETUP_SSID_PREFIX_LEN 7.
        5. Copy prefix with strncpy(ssid, 7); suffix with strncpy(ssid+7, ...).
    - Call helper from on_wifi_prov_event for AP_STARTED and PORTAL_READY.
    - Do not change other event display mappings.
Module boundaries:
  - wifi_provisioning emits neutral events only; app_core owns all display calls.
  - No changes to display stack, setup_url, or public app_core.h APIs.
Non-goals:
  - Spanish OLED strings (v1 English only).
  - WiFi join QR on the right panel.
  - OPEN / no-password indicator line.
  - New layout template or font changes.
  - Portal HTML or captive DNS changes.
Acceptance criteria:
  1. Fresh NVS boot (no credentials): OLED shows QR http://192.168.4.1 left;
     right shows 1 JOIN / HIL-00- / XXXX / 2 SCAN QR where XXXX is the 4-char
     MAC suffix of the real SoftAP SSID.
  2. Lines 1+2 concatenated match the SSID in the phone WiFi list exactly.
  3. No pixel truncation on lines for SSID format HIL-NN-MAC4 (11 chars total).
  4. Saved-credentials boot path unchanged (no provisioning setup screen).
  5. Fallback WIFI/SETUP only when ssid missing (error path).
  6. Clean build; wifi_provisioning still has no app_core or display includes.
Validation plan:
  - Implementer: build log + note example SSID from serial.
  - Tester: erase NVS, boot, photograph OLED, join displayed AP, scan QR, confirm
    portal loads at http://192.168.4.1/.
Open questions:
  - None.
```

## OLED_WIFI_CONNECTED_STATUS

```text
Role boundary check:
  Architect-owned product UX. Firmware code, build, flash, and validation belong
  to implementer/tester.
ID: OLED_WIFI_CONNECTED_STATUS
Source:
  - Human request 2026-06-23: when WiFi connection is OK, show current STA IPv4
    and STA MAC on the OLED, distributed for human readability within 128×64.
  - Replaces legacy SUBMITTED_SUCCESS screen (WIFI / OK two lines) and adds
    display for SAVED_SUCCESS (currently no-op in app_core_wifi.c).
Objective:
  On successful STA connection, show a four-line FULL_FOUR_LINES screen: status,
  IP address, and MAC split into two XX:XX:XX groups.
Reason:
  WIFI / OK gives no network identity. Operators need the assigned IP to reach the
  device and the MAC for bench identification. A single 17-char MAC line risks
  truncation; IP (up to 15 chars) fits alone on one full-width line.
Authorized files (implementer only):
  - components/wifi_provisioning/include/wifi_provisioning.h
  - components/wifi_provisioning/wifi_provisioning.c
  - components/app_core/app_core_wifi.c
Normative specs (architect-updated):
  - docs/wifi_provisioning_architecture.md — WiFi connected OLED screen
  - docs/display_delivery_contract.md — Product WiFi connected screen
  - docs/oled_text_display_interface.md — Golden 7
Expected changes (implementer):
  wifi_provisioning.h:
    - Add sta_ipv4 and sta_mac to wifi_prov_event_info_t (const char * each).
  wifi_provisioning.c:
    - Add static s_sta_ipv4[16], s_event_sta_ipv4[16], s_event_sta_mac[18].
    - On IP_EVENT_STA_GOT_IP for active pending STA source, copy IP to s_sta_ipv4.
    - Before SUBMITTED_SUCCESS and SAVED_SUCCESS emit: format STA MAC with
      esp_wifi_get_mac(WIFI_IF_STA) as "%02X:%02X:%02X:%02X:%02X:%02X".
    - Copy s_sta_ipv4 → s_event_sta_ipv4 and MAC → s_event_sta_mac; pass pointers
      in wifi_prov_event_info_t. Other events: sta_ipv4/sta_mac MUST be NULL.
    - Extend emit_event (or emit_event_ex) to populate new fields.
  app_core_wifi.c:
    - Add show_wifi_connected_display() per architecture doc algorithm.
    - SUBMITTED_SUCCESS → show_wifi_connected_display (not WIFI/OK template).
    - SAVED_SUCCESS → show_wifi_connected_display (not empty break).
    - Fallback FULL_TWO_LINES WIFI/OK if sta_ipv4 or sta_mac missing/invalid.
Exact OLED content (success path):
  Line 0: WIFI OK
  Line 1: <sta_ipv4> e.g. 192.168.1.42
  Line 2: <sta_mac[0..7]> e.g. AA:BB:CC
  Line 3: <sta_mac[9..16]> e.g. DD:EE:FF
Constants (app_core_wifi.c):
  WIFI_OK_LINE_STATUS "WIFI OK"
  WIFI_OK_MAC_PREFIX_LEN 8
  WIFI_OK_MAC_SUFFIX_OFFSET 9
Module boundaries:
  - app_core MUST NOT call esp_netif_* or esp_wifi_* for this screen.
  - wifi_provisioning MUST NOT include display or app_core headers.
Non-goals:
  - QR on connected screen, scrolling, timeout/auto-clear, IPv6, AP MAC display.
Acceptance criteria:
  1. POST provision success: OLED shows WIFI OK + real STA IP + split STA MAC.
  2. Saved-credentials boot success: same screen (SAVED_SUCCESS path).
  3. MAC lines reassemble to uppercase AA:BB:CC:DD:EE:FF matching esp_wifi STA MAC.
  4. IP matches serial log STA got IP / saved boot connected ip= line.
  5. Fallback WIFI/OK only when success event lacks sta_ipv4 or sta_mac.
  6. CONNECTING / FAILED / provisioning QR screens unchanged.
  7. Clean build; no display coupling violations in wifi_provisioning.
Validation plan:
  - Implementer: build + serial log with example IP/MAC.
  - Tester: fresh provision + saved reboot; photograph OLED; compare IP/MAC to router.
Open questions:
  - None.
```

## ERROR_LED_WIFI_LINK_STATUS

```text
Role boundary check:
  Architect-owned product UX. Firmware code, build, flash, and validation belong
  to implementer/tester.
ID: ERROR_LED_WIFI_LINK_STATUS
Source:
  - Human request 2026-06-23: error LED reflects WiFi link state with slow blink
    (no creds), solid ON (saved creds connecting), OFF (connected), fast blink
    (saved creds but cannot connect).
  - Operator clarification: solid ON only on saved-credentials connect path, not
    portal SUBMITTED_CONNECTING.
Objective:
  Decouple WiFi state from GPIO via wifi_link_status_t on every provisioning
  event, error_led component, and app_core_wifi adapter (mirror OLED pattern).
Reason:
  OLED is not always visible; operators need at-a-glance WiFi status on GPIO8.
Authorized files (implementer only):
  - components/error_led/ (new; header stub may exist — implementer completes)
  - components/wifi_provisioning/include/wifi_provisioning.h
  - components/wifi_provisioning/wifi_provisioning.c
  - components/app_core/app_core.c
  - components/app_core/include/app_core.h
  - components/app_core/app_core_wifi.c
  - components/app_core/CMakeLists.txt
Normative specs:
  - docs/error_led_wifi_link_architecture.md (primary)
  - docs/wifi_provisioning_architecture.md — Error LED integration
  - docs/architecture.md — error_led component reference
Expected changes (implementer):
  error_led:
    - Complete component: init, set_pattern, esp_timer blink, GPIO8 active-low.
    - SLOW 500/500 ms, FAST 125/125 ms, ON/OFF per spec.
  wifi_provisioning.h:
    - Add wifi_link_status_t enum and link_status to wifi_prov_event_info_t.
  wifi_provisioning.c:
    - static s_link_status; set on each transition per transition table in docs.
    - emit_event always sets info.link_status = s_link_status.
  app_core:
    - error_led_init in app_core_start before WiFi.
    - app_core_error_led_set_pattern facade.
  app_core_wifi.c:
    - apply_wifi_link_status_led(info->link_status) end of each event branch.
    - Boot gap: UNPROVISIONED if !has_credentials else CONNECTING before prov start.
LED mapping:
  UNPROVISIONED -> SLOW_BLINK
  CONNECTING    -> ON
  CONNECTED     -> OFF
  DISCONNECTED  -> FAST_BLINK
Module boundaries:
  - wifi_provisioning MUST NOT include error_led or app_core.
  - error_led MUST NOT include WiFi headers.
Non-goals:
  - STA_LOST_IP runtime LED update, INA219/I2C LED patterns, portal connect solid ON.
Acceptance criteria:
  1. No creds: slow blink (portal + SUBMITTED_CONNECTING).
  2. Saved boot: solid ON until success or SAVED_FAILURE_LOCKED.
  3. WiFi OK: LED off.
  4. Locked disconnect: fast blink.
  5. Module boundary rules pass (no forbidden includes).
Validation plan:
  - Implementer: build log per phase.
  - Tester: NVS erase, provision, reboot, forced AP outage for fast blink.
Open questions:
  - None.
```

## ERROR_LED_RUNTIME_LINK_STATUS

```text
Role boundary check:
  Architect-owned LED contract extension. Firmware code, build, flash, and
  validation belong to implementer/tester.
ID: ERROR_LED_RUNTIME_LINK_STATUS
Source:
  - Human request 2026-06-23: LED must reflect prevailing link_status rules when
    WiFi connection is lost at runtime (after CONNECTED). LED-only; no OLED or
    WiFi retry policy changes.
  - Operator clarification: LED follows what WiFi is doing, same as power-on with
    saved credentials — without specifying reconnect philosophy in this handoff.
Objective:
  Keep s_link_status truthful after initial connect and notify app_core_wifi via
  WIFI_PROV_EVENT_LINK_STATUS_CHANGED so apply_wifi_link_status_led runs without
  changing OLED or the existing wifi_link_status_t → pattern table.
Reason:
  After SAVED_SUCCESS/SUBMITTED_SUCCESS, STA_DISCONNECTED and STA_LOST_IP do not
  update s_link_status; LED stays OFF while link is down.
Authorized files (implementer only):
  - components/wifi_provisioning/include/wifi_provisioning.h
  - components/wifi_provisioning/wifi_provisioning.c
  - components/app_core/app_core_wifi.c
Normative specs:
  - docs/error_led_runtime_link_architecture.md (primary)
  - docs/error_led_wifi_link_architecture.md — runtime transition rows
  - docs/wifi_provisioning_architecture.md — Runtime link_status for LED
Expected changes (implementer):
  wifi_provisioning.h:
    - WIFI_PROV_EVENT_LINK_STATUS_CHANGED after WIFI_PROV_EVENT_ERROR.
  wifi_provisioning.c:
    - publish_link_status() emits LINK_STATUS_CHANGED with current link_status.
    - update_runtime_link_status() idempotent enum change + publish.
    - handle_runtime_link_loss() when CONNECTED and portal inactive.
    - runtime_link_status_after_loss(): CONNECTING if pending STA attempt,
      DISCONNECTED if locked or no attempt (reuses existing semantics).
    - Hooks: STA_DISCONNECTED, STA_LOST_IP, STA_GOT_IP when
      s_pending_sta_source == NONE (not stale GOT_IP).
  app_core_wifi.c:
    - case WIFI_PROV_EVENT_LINK_STATUS_CHANGED: break (no OLED).
    - apply_wifi_link_status_led unchanged at end of on_wifi_prov_event.
LED mapping: unchanged (UNPROVISIONED=SLOW, CONNECTING=ON, CONNECTED=OFF,
  DISCONNECTED=FAST).
Module boundaries:
  - wifi_provisioning MUST NOT include error_led or app_core.
  - error_led MUST NOT change.
Non-goals:
  - WiFi reconnect policy, retry counts, backoff, portal reopen.
  - OLED update on runtime link loss.
  - Changes to error_led timing or adapter mapping table.
Acceptance criteria:
  1. Connected (LED off) → AP offline → LED not stuck off (FAST or ON per link_status).
  2. AP restored → LED off.
  3. Portal / no-creds slow blink unchanged.
  4. SAVED_FAILURE_LOCKED fast blink unchanged.
  5. LINK_STATUS_CHANGED does not alter OLED.
  6. Build passes; no forbidden includes.
Validation plan:
  - Implementer: idf.py build; log link_status on LINK_STATUS_CHANGED.
  - Tester: connect → kill AP → observe LED → restore AP → LED off; OLED unchanged.
Open questions:
  - None.
```

## WIFI_RUNTIME_RECONNECT

```text
Role boundary check:
  Architect-owned reconnect policy and event contract. Firmware code, build,
  flash, and validation belong to implementer/tester.
ID: WIFI_RUNTIME_RECONNECT
Source:
  - Human request 2026-06-23: architecture for runtime WiFi loss with valid NVS
    credentials after sustained CONNECTED operation.
  - Operator decision: unbounded reconnect with capped backoff; never boot-lock
    from runtime loss alone (boot lock remains 5-attempt saved boot only).
  - Builds on ERROR_LED_RUNTIME_LINK_STATUS (layer 1: detect loss + LED).
Objective:
  After link loss at runtime, reconnect STA indefinitely until GOT_IP or factory
  reset; emit RUNTIME_RECONNECTING/RUNTIME_RESTORED; OLED + link_status CONNECTING
  during full reconnect episode (attempt + backoff).
Reason:
  Layer 1 sets DISCONNECTED/fast blink but does not call esp_wifi_connect; device
  may not recover when AP returns. CONNECTING LED semantics unreachable in runtime.
Normative specs:
  - docs/wifi_runtime_reconnect_architecture.md (primary)
  - docs/wifi_provisioning_architecture.md — Runtime Reconnect Contract
  - docs/error_led_wifi_link_architecture.md — CONNECTING during reconnect episode
Authorized files (implementer only):
  - components/wifi_provisioning/include/wifi_provisioning.h
  - components/wifi_provisioning/wifi_provisioning.c
  - components/app_core/app_core_wifi.c
Expected changes (implementer):
  wifi_provisioning.h:
    - WIFI_PROV_EVENT_RUNTIME_RECONNECTING, WIFI_PROV_EVENT_RUNTIME_RESTORED
  wifi_provisioning.c:
    - WIFI_PROV_STA_SOURCE_RUNTIME internal; run_sta_connect_attempt() shared helper
    - runtime_reconnect_task: unbounded loop, backoff [1k..30k cap]
    - start_runtime_reconnect_if_needed() from handle_runtime_link_loss()
    - Dedupe task; guards: !portal, !locked, pending!=SAVED
    - Never set s_locked_disconnected or s_saved_policy_exhausted from runtime path
  app_core_wifi.c:
    - RUNTIME_RECONNECTING → WIFI/CONNECTING two lines
    - RUNTIME_RESTORED → show_wifi_connected_display()
    - apply_wifi_link_status_led unchanged
Reconnect policy:
  per_attempt_timeout_ms=12000
  backoff_ms=[1000,3000,5000,8000,12000,15000,20000,30000] then hold 30000
  max_attempts=unbounded
link_status during episode: CONNECTING (LED solid ON entire episode)
Lock rule: runtime loss MUST NOT trigger SAVED_FAILURE_LOCKED
Module boundaries:
  - wifi_provisioning MUST NOT include error_led or display headers
Non-goals:
  - Change boot 5-attempt lock
  - Open portal on runtime loss
  - Erase credentials on runtime reconnect failure
  - esp_wifi_set_auto_connect as sole mechanism
Acceptance criteria:
  1. Connected → AP off → LED ON; OLED CONNECTING.
  2. AP on → IP restored; LED off; OLED WIFI OK + IP/MAC.
  3. AP off long → LED ON; no HOLD RESET / boot lock.
  4. Bad creds cold boot → SAVED_FAILURE_LOCKED unchanged.
  5. Serial source=runtime attempt=N; no saved boot failed attempts=5 from runtime.
Validation plan:
  - Implementer: idf.py build; log runtime attempts/backoff.
  - Tester: AP power cycle; long outage; boot-lock regression; LED/OLED photos.
Open questions:
  - 500 ms debounce before starting task if only LOST_IP (add if tester needs).
```

## WIFI_CONNECT_CYCLE_AND_ERROR_LED_V2

```text
Role boundary check:
  Architect-owned product replan. Firmware code, build, flash, and validation
  belong to implementer/tester.
ID: WIFI_CONNECT_CYCLE_AND_ERROR_LED_V2
Source:
  - Operator request 2026-06-23: replan error LED sequence and eliminate terminal
    failure / HOLD RESET when credentials exist but network is unavailable.
  - Parameters: 5 failed attempts per round → 15 s fast LED → repeat indefinitely.
Objective:
  Unified connect cycle for boot and runtime; v2 LED mapping; no SAVED_FAILURE_LOCKED
  emission; no OLED HOLD RESET.
Supersedes:
  - ERROR_LED_WIFI_LINK_STATUS (v1 LED table)
  - ERROR_LED_RUNTIME_LINK_STATUS (layer 1 DISCONNECTED fast)
  - WIFI_RUNTIME_RECONNECT (split boot/runtime policy)
Normative specs:
  - docs/wifi_connect_cycle_architecture.md (primary)
  - docs/wifi_connect_cycle_implementation_reference.md (as-built, operator validated 2026-06-23)
  - docs/error_led_connect_cycle_architecture.md (LED v2)
  - docs/wifi_provisioning_architecture.md — Connect Cycle + Error LED v2
Status:
  - **Validated by operator** (2026-06-23): connect cycle + LED v2 behave as specified in test.
LED mapping v2:
  UNPROVISIONED (no NVS creds)     -> ON (solid)
  CONNECTING (round active)        -> SLOW_BLINK
  CONNECTING_ALERT (post-5-fail)   -> FAST_BLINK for 15 s
  CONNECTED                          -> OFF
Connect cycle:
  CONNECT_ROUND_MAX_ATTEMPTS=5
  CONNECT_PER_ATTEMPT_TIMEOUT_MS=12000
  CONNECT_ALERT_PHASE_MS=15000
  CONNECT_BACKOFF_WITHIN_ROUND_MS=[0,1000,3000,5000,8000]
  Repeat unbounded until GOT_IP or factory reset
Events v2:
  WIFI_PROV_EVENT_CONNECT_CYCLE_ACTIVE   link_status CONNECTING
  WIFI_PROV_EVENT_CONNECT_ALERT_PHASE    link_status CONNECTING_ALERT
  WIFI_PROV_EVENT_CONNECT_RESTORED       link_status CONNECTED + IP/MAC
Deprecated (do not emit v2):
  WIFI_PROV_EVENT_SAVED_FAILURE_LOCKED
  Permanent WIFI_LINK_STATUS_DISCONNECTED on creds path
OLED v2:
  CONNECT_CYCLE_ACTIVE / CONNECT_ALERT_PHASE -> WIFI/CONNECTING
  CONNECT_RESTORED -> WIFI OK + IP/MAC
  Remove SAVED_FAILURE_LOCKED -> HOLD RESET branch
wifi_link_status_t v2:
  Add WIFI_LINK_STATUS_CONNECTING_ALERT
  Deprecate DISCONNECTED for creds connect paths
Authorized files (implementer only):
  - components/wifi_provisioning/include/wifi_provisioning.h
  - components/wifi_provisioning/wifi_provisioning.c
  - components/app_core/app_core_wifi.c
Expected changes (implementer):
  wifi_provisioning.c:
    - Unified connect_cycle_run(source boot|runtime) with round/alert loop
    - Remove s_locked_disconnected / SAVED_FAILURE_LOCKED emission
    - connect_saved and runtime_reconnect_task use same cycle engine
  app_core_wifi.c:
    - apply_wifi_link_status_led v2 table
    - OLED handlers for CONNECT_CYCLE_* ; remove HOLD RESET case
  wifi_provisioning.h:
    - CONNECTING_ALERT enum; CONNECT_CYCLE_* events
Non-goals:
  - Open portal on connect failure
  - Erase credentials on network failure
  - Change error_led timing constants
Acceptance criteria:
  1. No creds: LED solid ON (not slow).
  2. Creds connecting: slow blink (not solid ON).
  3. After 5 fails in round: fast ~15 s then slow again; cycle repeats.
  4. Never OLED HOLD RESET with creds in NVS.
  5. Connected: LED off.
  6. Boot and runtime use same cycle; serial connect cycle logs; no saved boot failed attempts=5.
Validation plan:
  - Implementer: idf.py build; log one full round + alert + second round.
  - Tester: NVS erase; provision; AP down/up boot and runtime; no HOLD RESET photos.
  - **Done:** operator confirmed v2 works; see implementation reference for as-built replay.
Open questions:
  - None.
```

## WIFI_FACTORY_RESET_RUNTIME

```text
Role boundary check:
  Architect-owned. Firmware implementation and validation belong to implementer/tester.
ID: WIFI_FACTORY_RESET_RUNTIME
Source:
  - Operator request: erase WiFi credentials when pressing the factory reset switch
    (GPIO7), including while the device is running (not only at cold boot).
  - Operator refinement: hold duration 10000 ms (10 s) to prevent accidental erase.
  - Gap: boot-only hold in app_core_wifi_start(); connect cycle v2 blocks without
    runtime recovery path.
Objective:
  Unified factory reset contract: hold GPIO7 active-low 10000 ms (10 s) erases wifi_prov
  NVS and returns to provisioning portal at boot and runtime.
Normative spec:
  - docs/wifi_factory_reset_architecture.md (primary)
  - docs/wifi_factory_reset_implementation_reference.md (as-built, Run 021 validated)
Related:
  - docs/wifi_provisioning_architecture.md (NVS, portal)
  - docs/wifi_connect_cycle_architecture.md (abort cycle on erase)
  - docs/esp32_c3_supermini_connections.md (GPIO7)
Product rules:
  - Hold >= 10000 ms (10 s) continuous: erase + portal; LED UNPROVISIONED (solid ON)
  - Release before 10000 ms: no erase
  - Soft transition (no esp_restart on success path)
  - Abort connect cycle within 500 ms of hold confirmed
Boot (retain + refactor):
  - Existing blocking check in app_core_wifi_start before wifi_provisioning_init
  - Share hold timing helpers with runtime monitor
Runtime (new):
  - FreeRTOS task wifi_fr_mon (stack 3072, priority 6) polls GPIO7
  - On valid hold: wifi_credentials_erase() then
    wifi_provisioning_factory_reset_to_portal()
wifi_provisioning_factory_reset_to_portal() (new API):
  - Set abort flag; cancel wifi_rt_rc; disconnect/stop WiFi; start_ap_portal path
  - run_sta_connect_attempt must poll abort/credentials every <= 100 ms
Status:
  - **Validated by operator** (Run 021, Entry 024): runtime reset from connect cycle,
    portal idempotent 2x, reprovision vitriolina.
  - Deferred (recommended follow-up): boot hold 10s, boot short-press, reset from
    stable WIFI OK only, isolated wifi_rt_rc + reset.
Authorized files (implementer):
  - components/app_core/app_core_wifi.c
  - components/wifi_provisioning/include/wifi_provisioning.h
  - components/wifi_provisioning/wifi_provisioning.c
Non-goals:
  - Tap-without-hold erase; web reset; esp_restart as primary path
Acceptance criteria:
  1. Boot hold 10 s: erase + portal (regression; updates legacy 2 s boot code).
  2. Runtime from CONNECTED: hold 10 s -> portal within 500 ms abort budget.
  3. Runtime from connect cycle (AP down): hold 10 s -> portal; cycle stops.
  4. Short press never erases.
  5. Serial: factory reset requested (runtime) + portal ready.
Validation plan:
  - Tester: provision, connect, runtime reset without power cycle; reprovision new SSID.
  - **Done:** Run 021 PASS operator-critical path; see implementation reference matrix.
Open questions:
  - None.
```

## WIFI_PROVISIONING_PORTAL_REACHABILITY

```text
Role boundary check:
  This handoff is architect-owned corrective architecture. Firmware code, build,
  flash, and hardware validation belong to implementer/tester.
ID: WIFI_PROVISIONING_PORTAL_REACHABILITY
Source evidence:
  - tester/handoff.md Run 007, Run 008, Run 009
  - tester/test_runs.md Run 007, Run 008, Run 009
  - tester/feedback.md Entry 003, Entry 004, Entry 005
Objective:
  Correct the WiFi provisioning portal startup architecture so a phone associated
  to `b06_hil_setup` can reach HTTP handlers deterministically, and so startup
  failures do not cause reboot loops.
Reason:
  Run 007 associated a phone but `GET /` never reached the handler. Run 008
  introduced an AP start event race and reboot loop. Run 009 fixed the race but
  still showed 0x `GET / from client` despite SoftAP, HTTP server, and portal ready
  logs. The architecture must now prescribe ESP-IDF AP netif, DHCP, event-bit,
  HTTP, and diagnostics order tightly enough that implementation cannot guess.
Authorized files:
  - docs/wifi_provisioning_architecture.md
  - docs/test_strategy.md
  - agent-workspaces/architect/handoff.md
  - agent-workspaces/architect/decisions.md
  - components/wifi_provisioning/wifi_provisioning.c
  - components/wifi_provisioning/include/wifi_provisioning.h only if diagnostics
    or neutral event types need extension
  - components/app_core/app_core_wifi.c only to remove abort-on-provisioning-error
    behavior or map new neutral events
  - agent-workspaces/implementer/handoff.md for implementation notes
Expected changes:
  - Configure AP netif IP/DHCP before `esp_wifi_start()`.
  - Do not stop or restart DHCP after `WIFI_EVENT_AP_START`.
  - Clear `WIFI_AP_STARTED_BIT` before `esp_wifi_start()`, never after.
  - Keep startup in `WIFI_MODE_AP`; switch to APSTA only during submitted-credential
    connection attempts.
  - Start HTTP server only after AP start succeeds.
  - Register `GET /`, `GET /health`, `POST /provision`, and 404 handlers.
  - Add stable diagnostics for AP IP, SoftAP start, station join, HTTP start,
    handler registration, portal ready, `GET /health`, `GET /`, and `POST /provision`.
  - Remove any `ESP_ERROR_CHECK` path that turns provisioning startup errors into
    reboot loops.
Module boundaries and contracts:
  - Follow docs/wifi_provisioning_architecture.md sections Corrective Architecture
    From Runs 007-009 and ESP-IDF SoftAP Portal Startup Contract.
  - Preserve neutral event boundary: wifi_provisioning still must not include
    app_core.h or display headers.
Detailed behavior:
  - `GET /health` returns `OK` as `text/plain; charset=utf-8` with
    `Cache-Control: no-store`.
  - Portal ready is logged only after AP IP/DHCP setup, AP start, HTTP start, and
    handler registration have all succeeded.
  - A phone joined to AP must produce `station joined`, then `/health` and `/`
    handler logs when those URLs are opened.
  - If `/health` does not log, the bug is AP/DHCP/routing/httpd reachability, not
    HTML rendering.
Non-goals:
  - Captive DNS, HTTPS, WPA2 AP password, mobile-app-specific behavior, web reset,
    or automatic AP fallback for saved credential failure.
Acceptance criteria:
  - Run 008 reboot loop cannot recur: no AP start timeout after `SoftAP started`
    due to event-bit clearing after start.
  - Run 009 blank page cannot recur: tester can load `http://192.168.4.1/health`
    and `http://192.168.4.1/`, and serial logs show handler entry for both.
  - Reboot loop cannot occur from AP/HTTP provisioning errors.
  - Static audits from WiFi Provisioning Criteria remain PASS.
Constraints:
  - Do not widen dependencies between WiFi provisioning and display/app_core.
  - Do not log passwords.
Validation plan:
  - Implementer documents exact AP/DHCP/HTTP startup log sequence and build result.
  - Tester repeats fresh-NVS phone test with cellular disabled if possible, records
    phone IP, `/health` result, `/` form result, and handler logs.
Open questions:
  - None.
```

## WIFI_PROVISIONING_HTTP_STACK_SAFETY

```text
Role boundary check:
  This handoff is architect-owned corrective architecture. Firmware code, build,
  flash, and validation belong to implementer/tester.
ID: WIFI_PROVISIONING_HTTP_STACK_SAFETY
Source evidence:
  - tester/handoff.md Run 010
  - tester/test_runs.md Run 010
  - tester/feedback.md Entry 006
Objective:
  Ensure the WiFi provisioning HTTP handlers can serve `/health`, `/`, and
  `/provision` responses without stack protection faults, Guru Meditation, abort,
  or reboot.
Reason:
  Run 010 fixed AP/DHCP/httpd reachability: phone received 192.168.4.2 and
  `GET / from client` reached the handler. The device then crashed in the httpd
  worker with stack protection fault before HTML reached the browser. Code review
  shows setup/failure page helpers allocate large `char html[2048]` buffers on the
  HTTP worker stack, matching the tester's hypothesis.
Authorized files:
  - docs/wifi_provisioning_architecture.md
  - docs/test_strategy.md
  - agent-workspaces/architect/handoff.md
  - agent-workspaces/architect/decisions.md
  - components/wifi_provisioning/wifi_provisioning_pages.c
  - components/wifi_provisioning/wifi_provisioning_pages.h only if private helper
    signatures change
  - components/wifi_provisioning/wifi_provisioning_form.c
  - components/wifi_provisioning/wifi_provisioning.c only for httpd stack config
    and response-completion diagnostics
  - agent-workspaces/implementer/handoff.md for implementation notes
Expected changes:
  - Remove large HTML response buffers from HTTP handler stack.
  - Remove full-body duplicate `pair` buffers from parser stack, or otherwise keep
    every local array in handler call chains <= 128 bytes.
  - Send setup/failure pages by constant chunks, bounded static/heap buffers, or
    another non-stack bounded strategy.
  - Set `httpd_config_t.stack_size` explicitly to at least 8192 bytes unless code
    review proves smaller is safe.
  - Add response-completion logs for `/health`, `/`, and `/provision` success/fail
    pages.
Module boundaries and contracts:
  - Follow docs/wifi_provisioning_architecture.md HTTP Handler Stack Safety.
  - Preserve neutral event and display boundaries.
Detailed behavior:
  - `GET /health` logs `GET /health from client` and `GET /health response sent`.
  - `GET /` logs `GET / from client` and `GET / response sent`.
  - If a response send fails, log the route and esp_err_t.
  - Passwords are never logged or echoed.
Non-goals:
  - Captive DNS, JavaScript frontend, filesystem assets, HTTPS, AP password, or
    changing the portal UI semantics.
Acceptance criteria:
  - Run 010 stack fault cannot recur: `/` and failure page rendering use no large
    stack buffers.
  - Phone loads `/health` and `/` without reboot; serial logs response-completion
    markers for both.
  - Wrong submitted credentials return the failure page without stack fault.
  - Static audits from WiFi Provisioning Criteria remain PASS.
Constraints:
  - Do not widen dependencies between WiFi provisioning and app_core/display.
  - Do not log passwords.
Validation plan:
  - Implementer documents page rendering memory strategy, httpd stack size, and
    build result.
  - Tester repeats fresh-NVS phone test: `/health`, `/`, bad POST, and serial
    response-completion logs.
Open questions:
  - None.
```

## WIFI_PROVISIONING_HTTP_HEADER_BUDGET

```text
Role boundary check:
  This handoff is architect-owned corrective architecture. Firmware code, build,
  flash, and validation belong to implementer/tester.
ID: WIFI_PROVISIONING_HTTP_HEADER_BUDGET
Source evidence:
  - tester/handoff.md Run 011
  - tester/test_runs.md Run 011
  - tester/feedback.md Entry 007
Objective:
  Ensure a normal phone browser can submit the WiFi credential form and reach
  `POST /provision` application code instead of being rejected by ESP-IDF httpd
  with HTTP 431 before handler entry.
Reason:
  Run 011 verified the stack fix: `GET /` response completed, no panic occurred,
  and the human operator saw the setup form. Submitting SSID/password then failed
  with "Header fields are too long"; serial logs showed `httpd_parse` rejected the
  request and no `POST /provision from client` application log occurred.
Authorized files:
  - docs/wifi_provisioning_architecture.md
  - docs/test_strategy.md
  - agent-workspaces/architect/handoff.md
  - agent-workspaces/architect/decisions.md
  - sdkconfig.defaults
  - components/wifi_provisioning/wifi_provisioning.c only for POST milestone logs
  - agent-workspaces/implementer/handoff.md for implementation notes
  - agent-workspaces/implementer/backlog.md for task status
Expected changes:
  - Add `CONFIG_HTTPD_MAX_REQ_HDR_LEN=2048` to source-controlled
    `sdkconfig.defaults`.
  - Keep the credential form as `method="post" action="/provision"`; do not move
    credentials into URL/query parameters.
  - Add POST milestone logs:
    - `POST /provision from client`
    - `POST /provision parsed form`
    - `POST /provision attempting STA ssid=<redacted-or-ssid>`
    - `POST /provision failure response sent`
    - `POST /provision success response sent`
  - Preserve all HTTP stack safety and portal reachability fixes.
Module boundaries and contracts:
  - Follow docs/wifi_provisioning_architecture.md HTTP Request Header Budget.
  - Preserve neutral event and display boundaries.
Detailed behavior:
  - HTTP 431 before `POST /provision from client` is a header-budget/configuration
    failure, not a form parser or WiFi credential failure.
  - Wrong credentials must reach handler, parse form, attempt STA, return failure
    page, keep AP/HTTP active, and not save credentials.
  - Valid credentials must reach handler, parse form, attempt STA, return success,
    save credentials, then stop AP/HTTP after the success response is sent.
Non-goals:
  - Captive DNS, JavaScript, changing the form method, external assets, HTTPS,
    AP password, or UI redesign.
Acceptance criteria:
  - Clean build generated config has `CONFIG_HTTPD_MAX_REQ_HDR_LEN 2048`.
  - Phone browser POST no longer produces HTTP 431 / `request URI/header too long`.
  - Serial logs include `POST /provision from client` after form submission.
  - Wrong credential test returns failure page with no reboot and logs failure
    response sent.
  - Static audits from WiFi Provisioning Criteria remain PASS.
Constraints:
  - Do not log passwords.
  - Do not widen dependencies between WiFi provisioning and app_core/display.
Validation plan:
  - Implementer documents sdkconfig.defaults value, generated config value, build
    result, and POST milestone logs from local/manual validation if available.
  - Tester repeats Run 011 flow: GET / visible, submit bad credentials from phone,
    verify no HTTP 431, verify handler milestones and failure page.
Open questions:
  - None.
```

## WIFI_PROVISIONING_POST_SUCCESS_COMMIT

```text
Role boundary check:
  This handoff is architect-owned corrective architecture. Firmware code, build,
  flash, and validation belong to implementer/tester.
ID: WIFI_PROVISIONING_POST_SUCCESS_COMMIT
Source evidence:
  - tester/feedback.md Entry 009
  - tester/handoff.md Run 012 status
  - implementer/handoff.md TESTER_RETURN_POST_SUCCESS_UX_MISMATCH
Objective:
  Make submitted-credential success an atomic product transaction across browser
  feedback, OLED feedback, NVS persistence, AP teardown, and saved-credential
  reboot behavior.
Reason:
  Run 012 removed HTTP 431 and allowed the operator to submit the form. The browser
  then showed no success or failure page, OLED showed `WIFI OK`, the AP still
  appeared visible, and a later boot used saved credentials but failed STA auth.
  The architecture must prevent success from being reported on OLED or persisted
  as provisioned unless web feedback and saved STA behavior are consistent.
Authorized files:
  - docs/wifi_provisioning_architecture.md
  - docs/test_strategy.md
  - agent-workspaces/architect/handoff.md
  - agent-workspaces/architect/decisions.md
  - components/wifi_provisioning/wifi_provisioning.c
  - components/wifi_credentials/ only if rollback/clear-provisioned helper is needed
  - components/app_core/app_core_wifi.c only to delay OLED success until neutral
    success event is emitted after web success
  - agent-workspaces/implementer/handoff.md for implementation notes
  - agent-workspaces/implementer/backlog.md for task status
Expected changes:
  - Clear submitted STA event bits before every POST connection attempt.
  - Log fresh submitted `STA got IP ip=<ipv4> source=submitted`.
  - Log saved boot `STA got IP ip=<ipv4> source=saved`.
  - Save credentials only in the submitted success path and log
    `credentials saved source=submitted`.
  - Emit `WIFI_PROV_EVENT_SUBMITTED_SUCCESS` only after
    `POST /provision success response sent`.
  - If success response send fails after credentials are saved, clear/rollback
    saved provisioned state, keep AP/HTTP active, and do not show OLED `WIFI OK`.
  - Defer HTTP/AP teardown by `2000 ms` after success response and log teardown.
Module boundaries and contracts:
  - Follow docs/wifi_provisioning_architecture.md Submitted Success Commit Contract.
  - Preserve neutral event and display boundaries.
Detailed behavior:
  - Required valid-credential success sequence:
    `POST /provision from client` →
    `POST /provision parsed form` →
    `POST /provision attempting STA ssid=<redacted-or-ssid>` →
    `STA got IP ip=<ipv4> source=submitted` →
    `credentials saved source=submitted` →
    `POST /provision success response sent` →
    `WIFI_PROV_EVENT_SUBMITTED_SUCCESS` →
    `success teardown scheduled delay_ms=2000` →
    `HTTP server stopped after provisioning success` →
    `SoftAP stopped after provisioning success` →
    `STA-only mode active after provisioning success`.
  - OLED `WIFI OK` must occur after web success response, never before.
  - AP visibility immediately after submit is acceptable only during the 2000 ms
    grace window; after teardown it must stop beaconing or accepting associations.
Non-goals:
  - Captive DNS, JavaScript, changing form method, AP password, HTTPS, or automatic
    AP fallback after saved-credential boot failure.
Acceptance criteria:
  - Valid credential POST shows browser success page, not blank page.
  - Serial logs prove the full success sequence above.
  - OLED success is ordered after `POST /provision success response sent`.
  - Saved credentials connect on next STA-only boot and log
    `STA got IP ip=<ipv4> source=saved`.
  - If saved-credential reboot auth fails, full WiFi provisioning remains FAIL.
Constraints:
  - Do not log passwords.
  - Do not widen dependencies between WiFi provisioning and app_core/display.
Validation plan:
  - Implementer records build result and, if possible, local serial sequence for a
    valid POST.
  - Tester runs with live serial during POST, verifies browser success/failure,
    OLED ordering, AP teardown logs, and reboot saved-credential behavior.
Open questions:
  - None.
```

## WIFI_PROVISIONING_ARCHITECTURE

```text
Role boundary check:
  This handoff is architect-owned work for docs and contracts. Firmware code,
  builds, flash, and validation belong to implementer/tester.
ID: WIFI_PROVISIONING_ARCHITECTURE
Objective:
  Define and implement the v1 WiFi provisioning flow: open device AP, local HTTP
  credential form, STA connection attempt, NVS persistence, success/failure user
  feedback, and factory-reset recovery.
Reason:
  b00_basehil needs a deterministic way for a user to enter target WiFi credentials
  without serial tooling. The flow must preserve existing display boundaries:
  provisioning may request a setup QR through app_core, but display components
  must remain independent from WiFi and network APIs.
Authorized files:
  - docs/wifi_provisioning_architecture.md
  - docs/architecture.md
  - docs/test_strategy.md
  - docs/qr_encoder_interface.md cross-reference only
  - components/wifi_credentials/
  - components/wifi_provisioning/
  - components/app_core/ for boot orchestration, provisioning callbacks, and
    display facade calls only
  - components/board/ for factory reset GPIO helper use only; do not redefine
    pin values outside docs/esp32_c3_supermini_connections.md
  - agent-workspaces/implementer/ for implementation notes
Expected changes:
  - Add wifi_credentials component that owns NVS namespace `wifi_prov` with keys
    `ssid`, `password`, and `provisioned`.
  - Add wifi_provisioning component that owns SoftAP `b06_hil_setup`, HTTP server,
    `/` and `/provision` routes, bounded form parsing, and STA connection attempts.
  - Expose only neutral provisioning lifecycle APIs and `wifi_prov_event_t`
    callbacks from wifi_provisioning; app_core registers the callback and maps
    events to display behavior.
  - Build the provisioning portal as bounded server-rendered HTML inside
    wifi_provisioning, with no JavaScript, no external assets, no filesystem
    dependency, and no public frontend API.
  - Update app_core startup to check GPIO7 factory reset, initialize credential
    storage, load credentials, enter provisioning mode when missing, connect STA
    when present, and remain disconnected after saved credential failure.
  - Route provisioning display states by neutral events into app_core; app_core
    alone calls app_core_display_show_template and app_core_display_show_qr_setup.
  - Keep display component tree free of WiFi, HTTP, esp_netif, NVS credential,
    and provisioning headers.
Module boundaries and contracts:
  - Follow docs/wifi_provisioning_architecture.md as the normative source.
  - app_core owns product orchestration and display calls.
  - wifi_credentials owns NVS read/write/erase/validate only.
  - wifi_provisioning owns SoftAP, HTTP portal, STA connection attempts, and
    reports state/results through `wifi_prov_event_cb_t`.
  - wifi_provisioning must not include app_core.h, display_controller.h, display
    headers, or know display template identifiers.
  - board owns GPIO7 active-low interpretation.
  - display remains downstream of app_core and must not observe WiFi state.
Detailed behavior:
  - Missing credentials start open AP `b06_hil_setup` at `192.168.4.1`.
  - `GET /` returns ASCII setup form with `ssid` and optional `password`.
  - `POST /provision` accepts application/x-www-form-urlencoded only, with max
    request body 256 bytes, SSID 1..32 bytes, password 0..63 bytes.
  - `GET /` page contains one POST form to `/provision` with fields `ssid` and
    `password`, maxlength values 32 and 63, and submit label `Connect`.
  - HTML responses set `Content-Type: text/html; charset=utf-8` and
    `Cache-Control: no-store`.
  - Success page contains `WiFi connected. You can close this page.`
  - Failure page contains `WiFi connection failed. Check SSID and password.` and
    includes a retry form with an empty password field.
  - Any echoed SSID is HTML-escaped; passwords are never echoed in HTML, logs, or
    implementation notes.
  - Submitted credentials are tested with STA connection timeout 30000 ms before
    saving to NVS.
  - Success: save credentials, return success page, stop HTTP/AP, stay connected
    as STA.
  - Submitted failure: do not save, return failure page with retry form, keep AP
    and HTTP active.
  - Saved credential failure at boot: do not erase, do not reopen AP, remain
    disconnected until factory reset.
  - Factory reset: GPIO7 active-low continuously for at least 10000 ms (10 s) during boot
    erases NVS namespace `wifi_prov` and enters provisioning AP mode.
  - Provisioning AP QR payload is exactly `http://192.168.4.1`, routed through
    a neutral provisioning event that app_core maps to app_core_display_show_qr_setup.
Non-goals:
  - Captive DNS, HTTPS, WPA2 AP password, per-device setup password, web reset UI,
    encrypted NVS, flash encryption requirement, WiFi enterprise, automatic AP
    fallback after saved credential boot failure, automatic credential erase after
    boot failure, display-owned WiFi state, direct WiFi provisioning calls to
    app_core_display_show_*, app_core.h inclusion from wifi_provisioning, or
    direct WiFi provisioning calls to display_controller_*.
Acceptance criteria:
  - Implementation follows docs/wifi_provisioning_architecture.md exactly for
    component layout, NVS keys, AP parameters, page rendering, routes, state
    machine, timeouts, reset behavior, and display boundaries.
  - Fresh or erased credentials expose open AP `b06_hil_setup` and serve
    `http://192.168.4.1/`.
  - Valid credentials are saved only after successful STA connection.
  - Invalid submitted credentials are not saved and leave AP active.
  - Saved credentials are used on reboot without AP.
  - Saved credential failure at boot leaves the device disconnected until factory
    reset.
  - GPIO7 active-low for 10000 ms (10 s) erases credentials and restarts provisioning.
  - Static audits show display code excludes WiFi/network/provisioning headers
    and wifi_provisioning excludes app_core.h, display_controller.h, and display
    headers.
Constraints:
  - Store credentials in normal NVS for v1; do not claim encryption.
  - All portal and display product copy must be ASCII-only.
  - Do not modify QR product profile beyond root-only http://IPv4.
  - Do not use workstation-specific ESP-IDF absolute paths in committed files.
Validation plan:
  - Implementer runs build and component/host tests for credential validation,
    NVS save/load/erase, and form parser bounds.
  - Tester validates AP, HTTP portal, submitted success/failure, reboot with saved
    success, reboot with saved failure, factory reset erase, and OLED QR scan per
    docs/test_strategy.md.
Open questions:
  - None for v1.
```

## OLED_TEXT_DISPLAY_INTERFACE

```text
ID: OLED_TEXT_DISPLAY_INTERFACE
Objective:
  Implement the initial 0.96 inch I2C OLED text display interface as a
  deterministic visual contract for a monochrome 128x64 display.
Reason:
  The firmware needs an implementation-ready display boundary before any agent
  adds display code. The base behavior must be portable, region-based, and
  testable without depending on one physical driver.
Authorized files:
  - components/display/ or an equivalent ESP-IDF component dedicated to display
    state, rendering, task, and driver boundaries.
  - components/app_core/ only for connecting DisplayController ownership if
    required by the implementation.
  - components/board/ only for isolated board configuration placeholders; do not
    bypass `docs/esp32_c3_supermini_connections.md` values.
  - docs/esp32_c3_supermini_connections.md for the board electrical connection
    map.
  - tests/ for host or component tests.
  - agent-workspaces/implementer/ for implementation notes.
Expected changes:
  - Add data structures that map directly to the canonical `DisplayState`,
    `DisplayLayout`, `DisplayRegion`, `TextRegion`, `TextLine`, `QrRegion`,
    `Rect`, and configuration schema in `docs/oled_text_display_interface.md`.
  - Add a canvas or framebuffer abstraction with clipped primitive drawing.
  - Add a view renderer that implements canonical text, QR, clipping, font
    selection, alignment, truncation, inverted emphasis, and draw-order rules.
  - Add a display task or tick-driven equivalent that owns the latest visual
    state, rate limits refresh, and sends rendered buffers to an isolated driver
    boundary.
  - Add a DisplayController-facing API that accepts states or layouts and does
    not expose pixel drawing to application callers.
Module boundaries and contracts:
  - `DisplayDriver` initializes and writes to hardware only; it must not decide
    content.
  - `Canvas` or `FrameBuffer` owns pixel memory and drawing primitives only.
  - `ViewRenderer` converts immutable or atomically replaced visual state into
    pixels.
  - `DisplayController` owns visual priority and is the only content producer
    for the display task.
  - `DisplayTask` receives update messages, keeps latest state, renders, and
    refreshes only when needed or forced.
Detailed behavior:
  - Follow `docs/oled_text_display_interface.md` as the normative source.
  - Follow `docs/esp32_c3_supermini_connections.md` for board-level electrical
    pins, I2C addresses, and active-low signal polarities.
  - The base display size is exactly 128x64.
  - Layouts are runtime data composed of explicit rectangular regions.
  - The screen is fully dynamic: text-only layouts are normal; QR appears only when
    the active layout includes a QR region (no permanently reserved QR area).
  - v1 display is read-only informational: push status/readings/alerts to screen;
    no menus, navigation, selection UI, or on-display data entry.
  - Occasional-use product: no OLED sleep, dimming, or display power management in v1.
  - Text supports printable ASCII only, controlled truncation without ellipsis,
    LEFT/CENTER/RIGHT horizontal alignment, TOP/CENTER/BOTTOM vertical group
    alignment, and NORMAL/INVERTED emphasis.
  - v1 product copy must not use tildes, accented letters, or non-English scripts;
    sanitize unsupported characters to ? per oled_text_display_interface.md.
  - QR regions generate regular QR Code matrices from sanitized payload text
    using LOW error correction and scale 2 with scale 1 fallback.
  - Null, malformed, out-of-bounds, overlapping, or oversized inputs must follow
    deterministic best-effort behavior.
Non-goals:
  - Do not implement icons, gauges, cursors, arbitrary bitmaps, widgets, Micro
    QR, Data Matrix, Aztec, scrolling text, animations, power management, or a
    platform-specific public visual contract.
  - Do not implement menus, navigation, highlighted selection, or any interactive
    on-display UI for v1; the OLED is informational output only.
  - Do not implement display power saving (sleep, dim, panel off) for v1; occasional
    use does not require 24/7 OLED power policies.
  - Do not treat QR_LEFT_TEXT_RIGHT as a fixed split-screen with permanent QR slot.
  - Do not add UTF-8, Unicode fonts, locale shaping, or multilingual display in v1.
  - Do not let GPIO numbers or I2C addresses leak into renderer, canvas, visual
    state, or DisplayController logic.
Acceptance criteria:
  - The implementation follows the canonical data schema and rendering
    algorithms.
  - It renders the four reference layouts: `FULL_FOUR_LINES`,
    `FULL_TWO_LINES`, `TOP_TWO_BOTTOM_ONE`, and `QR_LEFT_TEXT_RIGHT`.
  - It supports runtime layout/content replacement.
  - It supports inverted text at region and line level.
  - It generates regular QR Code output from short ASCII payloads and skips
    payloads that cannot fit.
  - It separates driver, framebuffer/canvas, renderer, display task, and display
    controller responsibilities.
  - It avoids continuous redraws when state has not changed and respects a
    configurable refresh limit defaulting to 10 Hz.
Constraints:
  - All unresolved hardware values must be marked `TODO(b00-basehil):`.
  - The physical display must be treated as 128x64 only in the base version.
  - The public display API must accept visual states or layouts, not arbitrary
    pixel drawing from application modules.
  - Board configuration must use `GPIO0` for SCL, `GPIO1` for SDA, `GPIO8` as an
    active-low error LED, and `GPIO7` as an active-low factory reset switch.
  - The shared I2C bus must reserve `INA219` addresses `0x40`, `0x41`, and
    `0x42`, and allow OLED address `0x3C` or `0x3D`.
  - ESP-IDF is installed on the development computer, but global ESP-IDF
    environment variables are not created and must not be required by committed
    code, scripts, or documentation.
  - Local absolute ESP-IDF tool paths may be discovered and used only while
    running commands on the workstation; those paths must not be written to any
    file intended for the repository.
Validation plan:
  - Add host or component tests for geometry, clipping, layout switching,
    truncation, sanitization, inverted rendering, draw order, refresh policy, and
    QR fit behavior as described in `docs/test_strategy.md`.
  - Run the build using the locally installed ESP-IDF tools without committing
    workstation-specific absolute paths or generated environment files.
  - Add hardware tests after physical OLED validation on the bench.
Open questions:
  - None (SSD1306 confirmed for v1; see agent-workspaces/implementer/handoff.md).
```

## I2C_BUS_ARCHITECTURE

```text
ID: I2C_BUS_ARCHITECTURE
Objective:
  Define and implement a portable shared I2C bus layer so multiple device
  drivers can share one master bus with deterministic structure and behavior.
Reason:
  b00_basehil shares one I2C bus between OLED and three INA219 devices, but the
  same bus layer must port to other MCUs and to display-only projects.
Authorized files:
  - components/i2c_bus/
  - components/board/ for board_i2c_bus_config()
  - components/app_core/ for startup orchestration
  - components/display/display_driver.* and display_types.h for hardware handle
    injection at the driver boundary only
  - docs/i2c_bus_architecture.md
  - docs/architecture.md
  - agent-workspaces/implementer/ for implementation notes
Expected changes:
  - Implement the portable public contract in docs/i2c_bus_architecture.md.
  - Keep SDK-specific code inside i2c_bus platform port only.
  - Add board helper that maps board pins to i2c_bus_config_t.
  - Initialize the bus in app_core before display startup.
  - Resolve OLED address using board constants and probe policy 0x3C then 0x3D.
  - Pass i2c_bus_device_t through display_config_t to display_driver only.
Module boundaries and contracts:
  - Follow the three-layer model: board config, portable i2c_bus, platform port.
  - i2c_bus owns one master bus and cached device handles by address.
  - board owns GPIO numbers and expected addresses for the target PCB.
  - display_driver is the only display layer that consumes the I2C device handle.
  - ina219 remains an optional future component; do not require it in app_core.
Detailed behavior:
  - Follow docs/i2c_bus_architecture.md as the normative source.
  - Use fixed component layout, constants, state machine, and caching rules from
    that document without reinterpretation.
  - Bind to ESP-IDF 5.x driver/i2c_master.h in the current target profile.
  - i2c_bus_add_device() returns the same handle for repeated address requests.
  - app_core follows the canonical startup order and OLED address policy.
  - Missing OLED at boot must not crash firmware; stub display may continue.
Non-goals:
  - SSD1306/SH1106 frame transmission.
  - Functional INA219 driver implementation.
  - 10-bit I2C, multiple buses, broker, or observability beyond the active
    authorized phase handoff.
Acceptance criteria:
  - components/i2c_bus matches fixed layout and portable contract.
  - Behavior matches canonical algorithms in docs/i2c_bus_architecture.md.
  - board remains the source of GPIO and expected addresses.
  - app_core initializes the bus before display_start().
  - display_config_t carries i2c_bus_device_t without exposing I2C to renderer or
    controller code.
  - A display-only project reuses i2c_bus unchanged.
  - Another LLM implementer can produce substantially similar code from the doc.
Constraints:
  - Do not write workstation-specific ESP-IDF absolute paths into committed
    files.
  - INA219 addresses 0x40, 0x41, and 0x42 remain board constants for b00_basehil.
  - Public headers must not spread SDK driver types beyond opaque i2c_bus_device_t
    except project-wide status aliases such as esp_err_t.
Validation plan:
  - Run idf.py build after implementation using locally discovered ESP-IDF
    tools without committing workstation paths.
  - Add hardware bus tests only after physical OLED driver selection is
    confirmed.
Open questions:
  - None for bus structure. Physical OLED controller/driver remains open under
    OLED_TEXT_DISPLAY_INTERFACE.
```

## I2C_BUS_CONCURRENCY

```text
ID: I2C_BUS_CONCURRENCY
Objective:
  Define an incremental concurrency architecture for shared I2C access so
  multiple application tasks can grow onto the same bus without redesigning
  device drivers.
Reason:
  b00_basehil will share one I2C bus between OLED refresh traffic and three INA219
  sensors. Physical driver serialization alone is not enough once multiple tasks
  perform concurrent I2C work.
Authorized files:
  - docs/i2c_bus_architecture.md
  - docs/test_strategy.md
  - docs/architecture.md
  - agent-workspaces/architect/handoff.md
  - agent-workspaces/architect/decisions.md
  - components/i2c_bus/ only when a phase-specific implementer handoff is active
Expected changes:
  - Document phases 1 through 4 in docs/i2c_bus_architecture.md.
  - Add i2c_bus_transceive in phase 2 and i2c_broker in phase 3 as normative
    contracts before implementation.
  - Add I2C validation criteria by phase to docs/test_strategy.md.
  - Keep b00_basehil priority policy in architecture docs, not in generic bus code.
Module boundaries and contracts:
  - Follow Incremental Concurrency Architecture in docs/i2c_bus_architecture.md.
  - Phase 1: direct sync init/probe/add_device only.
  - Phase 2: i2c_bus_transceive is the only device-driver entry point.
  - Phase 3: i2c_broker is the only application-task entry point.
  - Phase 4: debug counters only unless a future telemetry handoff says otherwise.
  - Priority tables are product configuration in board or app_core.
Detailed behavior:
  - Immutable rules: one bus owner, no SDK direct access, atomic transactions,
    mandatory timeouts, recoverable errors, no long-held bus during app logic.
  - b00_basehil priority table: boot/probe 255, diag 200, INA219 150, OLED 100.
  - Driver migration: phase 2 uses transceive; phase 3 uses broker_submit.
  - i2c_transaction_t shape must remain stable between phases 2 and 3.
Non-goals:
  - Implementing all phases in one change set.
  - Per-driver mutex ownership.
  - Product-specific priorities inside generic i2c_bus code.
Acceptance criteria:
  - Concurrency phases and APIs are documented normatively.
  - Each phase has explicit implementer handoff IDs: I2C_BUS_PHASE1..PHASE4.
  - Test strategy defines validation per phase.
  - Another LLM implementer can implement one phase without guessing later phases.
Constraints:
  - Implementer must execute only the active phase handoff.
  - Do not add broker code during phase 1 or 2 handoffs.
Validation plan:
  - Phase 1: build, boot, probe, missing OLED no panic.
  - Phase 2: two-task transaction test without corruption.
  - Phase 3: 60 s concurrent display and INA219 traffic without deadlock.
  - Phase 4: debug counters match observed traffic.
Open questions:
  - None.
```

## QR_ENCODER_INTERFACE

```text
ID: QR_ENCODER_INTERFACE
Objective:
  Define and implement QR matrix generation for local setup screens using the
  http://IPv4 product payload profile and a permissive MIT-licensed encoder.
Reason:
  The display renderer already draws QR regions but the encoder is a stub.
  QR payload strings arrive via display instructions; setup_url validates shape only.
Authorized files:
  - docs/qr_encoder_interface.md
  - docs/oled_text_display_interface.md cross-references only
  - docs/test_strategy.md
  - components/qr_encoder/ and vendor Nayuki qrcodegen sources plus LICENSE
  - components/setup_url/
  - components/display/display_qr.c and include/display_qr.h
  - tests/ for encoder and setup_url validation
  - agent-workspaces/implementer/ for implementation notes
Expected changes:
  - Integrate Nayuki qrcodegen (MIT) under components/qr_encoder/vendor/.
  - Implement display_qr_generate using byte mode and LOW error correction.
  - Add setup_url_format_ipv4 and setup_url_validate for http://IPv4 only.
  - Keep DisplayController payload input via display_controller_show_qr_setup.
  - Do not couple display or encoder code to WiFi/network APIs.
Module boundaries and contracts:
  - Follow docs/qr_encoder_interface.md as normative source.
  - Instruction sources supply QR payload in display instructions; setup_url validates.
  - display_qr owns matrix encoding only; renderer owns drawing.
Detailed behavior:
  - Product payloads: http:// plus IPv4 only, implicit root /, length 14 to 22 chars,
    QR version 1 or 2.
  - No path in QR string; redirects to /something are another entity's job.
  - https excluded for v1 (unlikely TLS on small MCU local setup).
  - Version ceiling 2; payloads over 32 bytes after sanitize must fail.
  - Static matrix buffer 25x25 in display_qr; no heap in v1.
  - Only display_task may call display_qr_generate in v1.
  - QR is sporadic: shown only when the active DisplayLayout includes a QR region.
  - The screen is dynamic (text-only layouts are normal; QR layouts are occasional).
  - No permanently reserved QR screen area; layout switches replace the full view.
  - QR is instruction-driven: same delivery path as text; no display-side wait or poll.
  - QR refresh uses the same display update path as any other layout or content change.
Non-goals:
  - https, hostname, port, path in QR payload, IPv6 in v1.
  - Firmware-owned HTTP redirects or subpath routing after QR scan.
  - Hand-rolled QR encoding.
  - Display-owned payload construction from WiFi/network APIs.
  - Architectural coupling between display and connectivity subsystems.
  - A fixed always-on QR panel or split-screen reserved for QR.
  - Display-side waiting screens or polling for pending instructions.
  - QR-specific refresh, debounce, or partial-update policies separate from the
    general display refresh contract.
Acceptance criteria:
  - MIT LICENSE recorded in vendor tree.
  - Canonical payloads encode to width 21 or 25 as documented.
  - Invalid payloads return false and render blank QR regions.
  - setup_url helpers pass tests in docs/test_strategy.md.
  - Renderer remains free of Nayuki includes.
Constraints:
  - Encoder library must be MIT-licensed (Nayuki qrcodegen selected).
  - Payload profile must not expand without a new architect handoff.
Validation plan:
  - Host or component tests for setup_url and display_qr_generate sizes.
  - Hardware scan test of QR_LEFT_TEXT_RIGHT when OLED driver is active.
  - Record measured flash/RAM after first integration.
Open questions:
  - Instruction source identity (may be internal to app_core if centralized).
Closed by implementation review:
  - setup_url component path: components/setup_url/
  - Nayuki vendor path: components/qr_encoder/vendor/qrcodegen/
  - qrcodegen.c blob pin recorded by implementer:
    34f1002501fa2bcb0a054f4311795b8cbb977f5b
```

## DISPLAY_DELIVERY_CONTRACT

```text
ID: DISPLAY_DELIVERY_CONTRACT
Objective:
  Implement and enforce the v1 path for all display instructions (text and QR):
  instruction source calls app_core callbacks; only app_core calls display_controller_* directly.
Reason:
  One orchestration path avoids polling, multi-caller races, special QR channels,
  and any coupling between display and WiFi/network subsystems.
Authorized files:
  - docs/display_delivery_contract.md
  - docs/architecture.md cross-references
  - docs/oled_text_display_interface.md cross-references only
  - docs/qr_encoder_interface.md cross-references only
  - docs/test_strategy.md
  - components/app_core/ for callback entry points and sole display_controller calls
  - agent-workspaces/implementer/ for implementation notes
Expected changes:
  - Add app_core_display_show_template and app_core_display_show_qr_setup callbacks.
  - Route text and QR instructions to matching display_controller_* APIs inside app_core.
  - Validate QR payload shape with setup_url at app_core before display call.
  - Ensure no module outside app_core and display internals directly includes
    display_controller.h in v1.
  - Ensure display tree excludes WiFi/network headers.
Module boundaries and contracts:
  - Follow docs/display_delivery_contract.md as normative source.
  - v1 transport: callback or internal app_core function call only (not esp_event).
  - Instruction source: call app_core entry points; no display API calls.
  - app_core: sole display_controller_* caller; task context only; no polling.
  - Text and QR instructions MUST use identical delivery semantics.
  - WiFi/network stacks MUST remain decoupled from display architecture.
Detailed behavior:
  - Centralized orchestration expected in app_core for v1.
  - No application queue between instruction source and app_core.
  - display_task internal queue remains the only display pipeline queue.
  - Invalid QR payload rejected at app_core without display calls.
  - display_controller_show_template rejects DISPLAY_TEMPLATE_QR_LEFT_TEXT_RIGHT;
    QR layouts use display_controller_show_qr_setup with an explicit payload.
Non-goals:
  - esp_event transport for display instructions in v1.
  - Instruction source direct calls to display_controller_* or display_set_*.
  - Polling for pending instructions.
  - Separate QR delivery channel or display/network coupling.
  - ISR-to-display calls.
Acceptance criteria:
  - Grep audit: only app_core and display component internals directly include
    display_controller.h in v1 firmware.
  - Text and QR instructions both flow callback → app_core → direct API.
  - No display/app_core references to WiFi/network for screen selection.
  - docs/display_delivery_contract.md acceptance criteria satisfied.
Constraints:
  - Do not widen display_controller callers without new architect handoff.
  - Do not add esp_event display path without new architect handoff.
Validation plan:
  - Implementer documents grep results and app_core callback API names.
  - Tester verifies text and QR via app_core callbacks without display bypass.
Open questions:
  - Instruction source identity if not fully internal to app_core.
```

## DISPLAY_VISUAL_DEMO_PROTOCOL

```text
ID: DISPLAY_VISUAL_DEMO_PROTOCOL
Objective:
  Require a short boot-time OLED demo-test (Kconfig-gated) and handoff Demo
  Manifest so the tester and a human operator can validate what appears on the
  physical panel after display-related work.
Reason:
  Run 005 passed encoder and delivery on host/serial but did not exercise QR on
  hardware at boot. Human visual validation was implicit or reused from prior runs.
Authorized files:
  - docs/display_visual_demo_protocol.md
  - docs/test_strategy.md (Display Visual Demo Criteria)
  - docs/methodology.md (Definition Of Ready)
  - AGENTS.md (handoff protocol reference)
  - components/app_core/ (app_core_display_demo.c, Kconfig, app_core.c)
  - sdkconfig.defaults
  - agent-workspaces/implementer/ and agent-workspaces/tester/ templates
Expected changes:
  - CONFIG_B00_BASEHIL_DISPLAY_VISUAL_DEMO (default y in sdkconfig.defaults).
  - app_core_run_visual_demo() with baseline v1 three-step sequence.
  - Serial markers DEMO_STEP i/N name= hold_ms= and DEMO_STEP i/N done.
  - Implementer handoff Demo Manifest block; tester per-step feedback template.
Module boundaries and contracts:
  - Follow docs/display_visual_demo_protocol.md as normative source.
  - Demo steps call app_core_display_show_* only (same delivery path as production).
  - Max 4 steps, max 30 s total hold.
Detailed behavior:
  - Kconfig y: steps FULL_FOUR_LINES (5s), QR_SETUP (8s), FULL_TWO_LINES (5s).
  - Kconfig n: smoke only — single FULL_FOUR_LINES screen, no step cycling.
Non-goals:
  - Serial CLI to trigger demos; menus; automated OCR.
Acceptance criteria:
  - Protocol doc and test_strategy criteria present.
  - Firmware builds with demo wired; serial grep shows DEMO_STEP 1/3 through 3/3.
  - Implementer handoff includes filled Demo Manifest for DISPLAY_VISUAL_DEMO_PROTOCOL.
Constraints:
  - Do not add display_controller callers outside app_core.
Validation plan:
  - Tester Run 006: flash with Kconfig y, human observes each step, feedback.md entry.
Open questions:
  - None.
```

## DISPLAY_V1_IMPLEMENTATION_SNAPSHOT

```text
ID: DISPLAY_V1_IMPLEMENTATION_SNAPSHOT
Objective:
  Align architecture documentation with the current display implementation so
  future LLM implementers reproduce the same component paths, APIs, and QR
  boundaries unless a new handoff changes them.
Reason:
  The implementer concretized app_core display facade, setup_url, Nayuki vendor
  layout, display_qr static-buffer adapter, QR-only helper path, and boot visual demo.
Authorized files:
  - docs/architecture.md
  - docs/display_delivery_contract.md
  - docs/qr_encoder_interface.md
  - docs/oled_text_display_interface.md
  - docs/display_visual_demo_protocol.md
  - docs/test_strategy.md
  - agent-workspaces/architect/handoff.md
  - agent-workspaces/architect/decisions.md
Expected changes:
  - Document exact app_core public display API names.
  - Document QR_LEFT_TEXT_RIGHT rejection from text-template path.
  - Document setup_url and qr_encoder component paths.
  - Document qrcodegen call shape and static memory model.
  - Document boot visual demo behavior as implemented.
Explicitly excluded:
  - components/**, main/**, sdkconfig*, build, flash, debug, tester sign-off
Module boundaries and contracts:
  - Future implementers must preserve app_core as display facade.
  - Future implementers must keep qrcodegen isolated behind display_qr.c.
  - Future implementers must not add a second QR/display delivery path.
Acceptance criteria:
  - Normative docs specify exact current paths and APIs.
  - Closed implementation details are moved out of open questions.
  - Remaining open questions are product-level only (instruction source identity,
    future URL extensions).
Validation plan:
  - Architect review only: no build or hardware validation in this role.
Open questions:
  - Product instruction source identity if not fully internal to app_core.
```

## ARCHITECT_ROLE_HARD_STOP

```text
ID: ARCHITECT_ROLE_HARD_STOP
Objective:
  Enforce stricter architect role separation: no firmware edits, no builds, clear
  override hierarchy over plans and generic instructions.
Reason:
  Architect session crossed into components/ and idf.py despite existing role guides.
Authorized files:
  - docs/architect_role_hard_stop.md
  - docs/methodology.md (hard stop references)
  - AGENTS.md (Architect hard stop section)
  - agent-workspaces/architect/ROLE.md
  - agent-workspaces/architect/decisions.md
  - agent-workspaces/architect/handoff.md
  - agent-workspaces/implementer/ROLE.md (one-line cross-reference only)
Expected changes:
  - Canonical hard stop doc with forbidden paths, commands, override table, checklist.
  - ROLE.md hard stop summary at top.
  - AGENTS.md ownership aligned to docs/**; role switch requires named role.
Explicitly excluded (implementer / tester):
  - components/**, main/**, sdkconfig*, idf.py, flash, formal test runs
Module boundaries and contracts:
  - docs/architect_role_hard_stop.md is normative for architect sessions.
  - Mixed plans: architect slice = docs + handoff only.
Acceptance criteria:
  - Hard stop doc exists and is linked from ROLE.md, AGENTS.md, methodology.md.
  - Decision recorded in decisions.md.
  - No firmware or build changes in this handoff execution.
Validation plan:
  - Reviewer confirms architect agent can cite hard stop when asked to implement code.
Open questions:
  - None.
```

## ARCHITECT_MISSION_PILLAR

```text
ID: ARCHITECT_MISSION_PILLAR
Objective:
  Record immutable mission: architect task ends with architecture/documentation
  files; finishing the task means closing docs/handoff, not firmware or toolchain.
Reason:
  Generic "complete the task" and mixed plans were misread as permission to code.
Authorized files:
  - docs/architect_role_hard_stop.md (§ Immutable mission pillar)
  - agent-workspaces/architect/ROLE.md
  - AGENTS.md (Architect mission pillar section)
  - docs/methodology.md
  - agent-workspaces/architect/decisions.md
  - agent-workspaces/architect/handoff.md
Expected changes:
  - Mission, definition of done, immutable scope, debug toolchain forbidden list.
  - Instruction priority row 0; checklist step 0 (do not code to finish).
Explicitly excluded:
  - components/**, main/**, sdkconfig*, idf.py, gdb, openocd, flash, builds
Acceptance criteria:
  - Pillar section at top of hard stop doc; cross-refs in ROLE, AGENTS, methodology.
  - Decision recorded; no firmware changes in this execution.
Validation plan:
  - Architect can state task is DONE when handoff/docs are complete without build.
Open questions:
  - None.
```

## WIFI_PROVISIONING_FIRST_CONNECT_FAILURE_FLOW

```text
Role boundary check:
  Documentation-only. No firmware changes required; as-built behavior matches spec.
ID: WIFI_PROVISIONING_FIRST_CONNECT_FAILURE_FLOW
Date: 2026-06-28
Objective:
  Record normative end-to-end flow when first portal WiFi connection fails: events,
  OLED/browser/LED surfaces, persistence rules, and contrast with saved-boot cycle.
Reason:
  Operator and tester questions on post-failure display behavior; scattered rules
  needed a single implementation-ready reference.
Authorized files:
  - docs/wifi_provisioning_first_connect_failure_flow.md (new)
  - docs/wifi_provisioning_architecture.md (cross-links, SUBMITTED_FAILURE persistence)
  - docs/test_strategy.md (First-connect failure OLED and LED criteria)
  - agent-workspaces/architect/handoff.md
  - agent-workspaces/architect/decisions.md
Expected changes:
  - Standalone flow doc with sequence diagram, surface tables, failure variants.
  - Parent doc link + SUBMITTED_FAILURE OLED persistence MUST.
  - Tester criteria for CONNECTING/FAILED OLED, no auto QR, LED solid ON.
Explicitly excluded (implementer):
  - components/**, main/** — no code changes in this handoff
  - LED/OLED alignment during SUBMITTED_CONNECTING (documented asymmetry; future opt-in)
Module boundaries and contracts:
  - wifi_provisioning emits neutral events; app_core owns display and LED.
  - Submitted path: single 30 s STA wait; no connect cycle; no NVS on failure.
Detailed behavior:
  - See docs/wifi_provisioning_first_connect_failure_flow.md
Non-goals:
  - Change submitted-path link_status to CONNECTING for LED slow blink
  - Auto-restore QR screen after SUBMITTED_FAILURE
Acceptance criteria:
  - Flow doc exists and is linked from wifi_provisioning_architecture.md
  - test_strategy lists OLED/LED checks for first-connect failure
  - Decision recorded in decisions.md
  - No pending implementer tasks (behavior already as-built)
Validation plan:
  - Tester runs wrong-credential POST per test_strategy First-connect failure section
Open questions:
  - None.
```

## WIFI_PROVISIONING_FIRST_CONNECT_FAILURE_UX_V2

```text
Role boundary check:
  Approved — implementer executes firmware + doc alignment.
ID: WIFI_PROVISIONING_FIRST_CONNECT_FAILURE_UX_V2
Date: 2026-06-28
Status: APPROVED (human 2026-06-28)
Objective:
  After first portal STA failure: brief WIFI / FAILED flash, then auto-restore
  unchanged standard QR setup screen.
Reason:
  Persistent FAILED hides QR guide; operator wants failure feedback without
  modifying QR setup copy.
Normative spec:
  docs/wifi_provisioning_first_connect_failure_ux_proposal.md
Approved scope:
  - SUBMITTED_FAILURE → FULL_TWO_LINES WIFI / FAILED for PROV_FAILURE_FLASH_MS (3000)
  - Timer in app_core_wifi; on expiry restore show_provisioning_setup_display()
    from cached AP_STARTED/PORTAL_READY context
  - Cancel timer on SUBMITTED_CONNECTING
  - No new wifi_prov events; no QR line copy changes
  - Option B (WIFI FAIL on QR panel) WITHDRAWN
Optional:
  - CONNECTING link_status during submitted attempt (LED slow blink)
Authorized files (implementer):
  - components/app_core/app_core_wifi.c
  - docs/wifi_provisioning_architecture.md, docs/test_strategy.md,
    docs/wifi_provisioning_first_connect_failure_flow.md
Acceptance criteria:
  - See proposal doc § Acceptance criteria
Open questions:
  - None.
```

## DEVICE_DISCOVERY_MDNS_V1

```text
Role boundary check:
  Architecture and documentation. Implementer owns components/ and sdkconfig.
ID: DEVICE_DISCOVERY_MDNS_V1
Date: 2026-06-28
Status: APPROVED — implementer authorized
Objective:
  LAN hostname discovery via mDNS: HIL-<board>-<MAC4>.local when STA has IPv4;
  same identity string as SoftAP SSID / OLED / QR.
Reason:
  DHCP IP varies; operators need Bonjour-style name resolution on the user LAN.
Human decisions (2026-06-28):
  - Announce STA with IP only (not during provisioning SoftAP)
  - Hostname → IPv4 only (no DNS-SD service records in v1)
  - Name matches product display; MAC4 from SoftAP MAC bytes 4-5
Normative spec:
  docs/device_discovery_mdns_architecture.md
Authorized files (implementer):
  - components/device_identity/ (new)
  - components/device_discovery/ (new, REQUIRES mdns)
  - components/wifi_provisioning/wifi_provisioning.c (SSID → device_identity)
  - components/app_core/app_core_wifi.c (start/stop lifecycle)
  - components/app_core/CMakeLists.txt
  - sdkconfig.defaults (mdns component)
Module boundaries:
  - device_identity: HIL-NN-XXXX string only
  - device_discovery: mdns init/start/stop; no WiFi connect
  - app_core_wifi: orchestration from wifi_prov events + link_status
  - wifi_provisioning: no mdns.h
Detailed behavior:
  - See docs/device_discovery_mdns_architecture.md
Non-goals:
  - _http._tcp, _hil._tcp, TXT, OLED .local display, mDNS on SoftAP
Acceptance criteria:
  - See spec § Acceptance criteria and docs/test_strategy.md § LAN mDNS discovery
Validation plan:
  - Tester: resolve HIL-00-XXXX.local on LAN after provision/connect
Open questions:
  - None.
```

## Template

```text
Role boundary check:
  Confirm this handoff is architect-owned work (docs + contracts). Redirect code,
  builds, and validation to implementer/tester if the human request mixes roles.
ID:
Objective:
Reason:
Authorized files:
Expected changes:
Module boundaries and contracts:
Detailed behavior:
Non-goals:
Acceptance criteria:
Constraints:
Validation plan:
Open questions:
```
