galopago/misistemhil/a-backplates/a00_hilbackplate/assets/img/201809180854265426.jpg

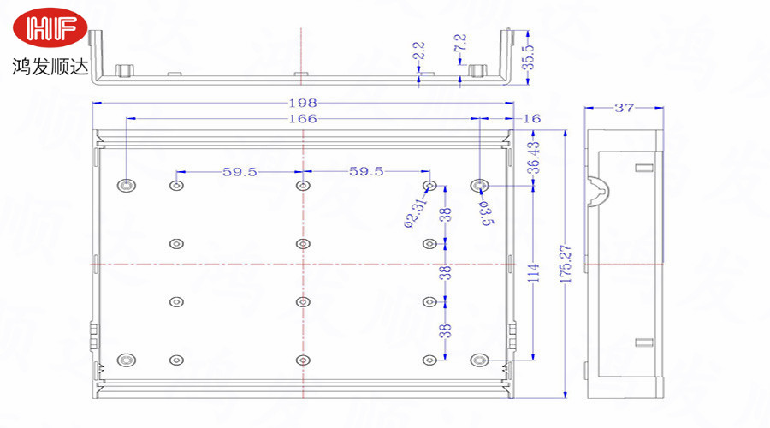
a-backplates/a00_hilbackplate/assets/img/201809180854265426.jpg
