galopago/misistemhil/a-backplates/a00_hilbackplate/assets/img/201809180854275427.jpg

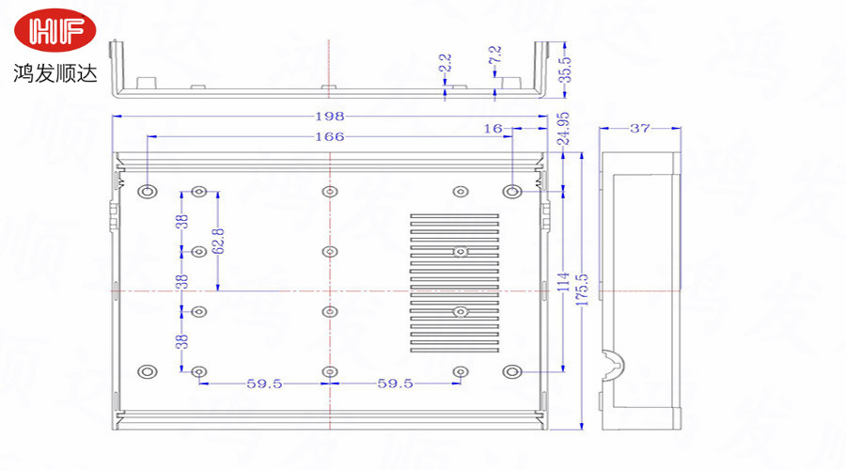
a-backplates/a00_hilbackplate/assets/img/201809180854275427.jpg
