galopago/misistemhil/b-hil-boards/b06_hil/pcb/assets/img/esp32 c3 mini.webp

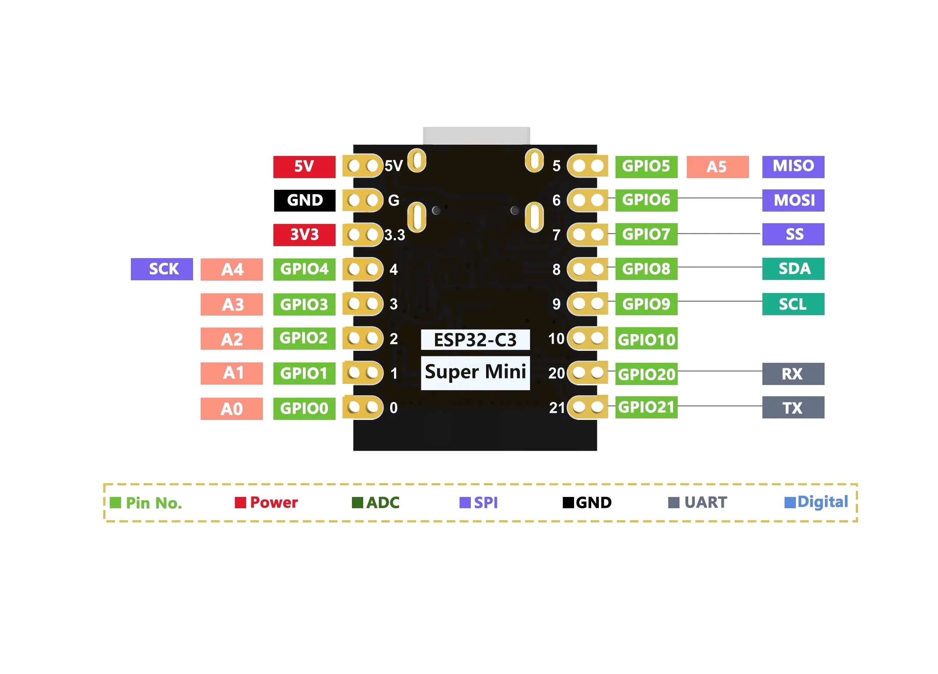
b-hil-boards/b06_hil/pcb/assets/img/esp32 c3 mini.webp
