galopago/misistemhil/d-faceplates/d05_hil_faceplate/assets/pdf/15EDGWC-3mm81-Pluggable-Terminal-Block-Connector.png

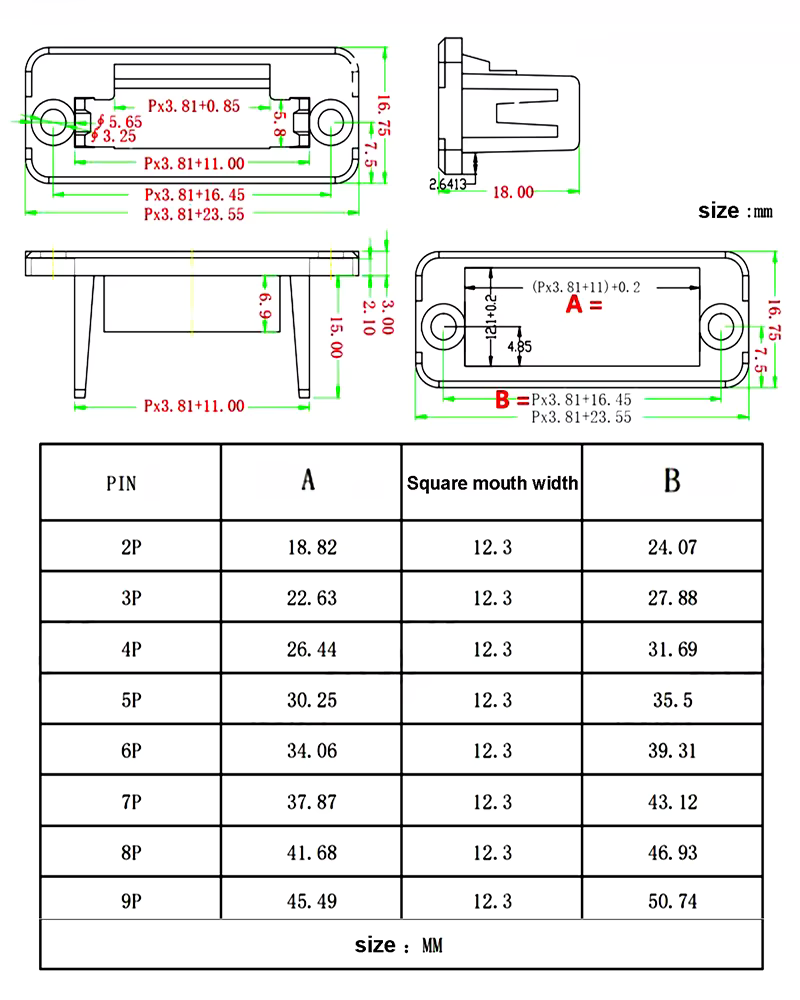
d-faceplates/d05_hil_faceplate/assets/pdf/15EDGWC-3mm81-Pluggable-Terminal-Block-Connector.png
