galopago/misistemhil/d-faceplates/d05_hil_faceplate/assets/pdf/Metal-D-Type-Module-USB-type-C-Jack-Panel-Mounting-Electronic-Connector.png

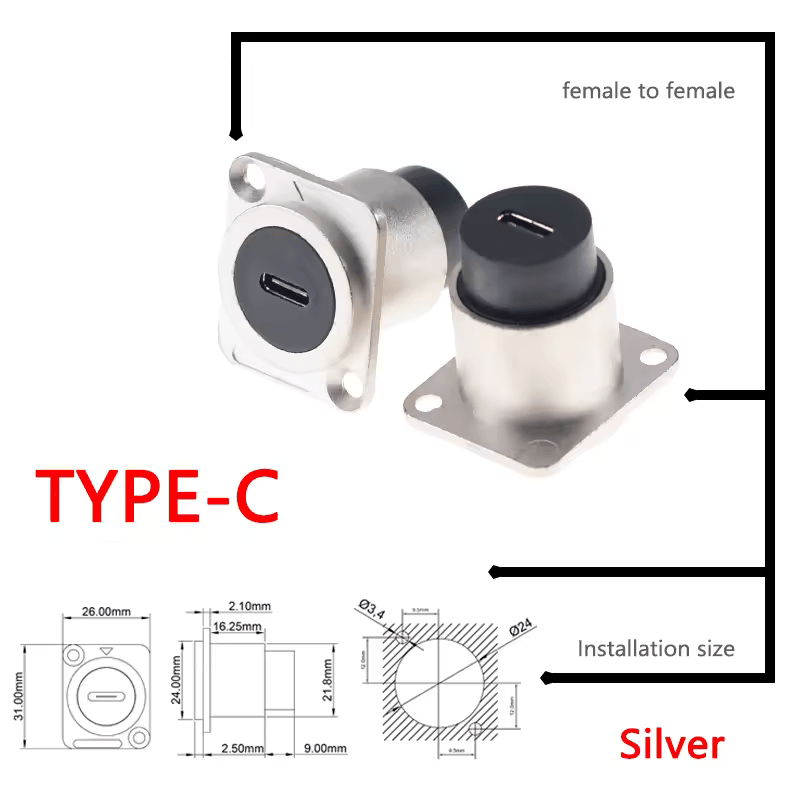
d-faceplates/d05_hil_faceplate/assets/pdf/Metal-D-Type-Module-USB-type-C-Jack-Panel-Mounting-Electronic-Connector.png
