galopago/misistemhil/b-hil-boards/b03_hil/firmware/agent-workspaces/tester/handoff.md

# Tester handoff — `b03_hil`

Status: **PASS** (2026-11-04) — OLED relay pair order `1/4 2/5 3/6`
validated (API + human). Panel LEDs still aligned. No open defects.
