galopago/misistemhil/b-hil-boards/b03_hil/firmware/tests/README.md

# Tests — `b03_hil`

No firmware tests yet. Docs-first bootstrap from b00_basehil.
