galopago/misistemhil/b-hil-boards/b03_hil/firmware/agent-workspaces/tester/procedures.md

# Tester procedures — `b03_hil`

Follow docs/test_strategy.md when validation starts.
