galopago/misistemhil/b-hil-boards/b06_hil/firmware/agent-workspaces/tester/procedures.md

# Tester Procedures — `b06_hil`

Follow `../../docs/test_strategy.md` when firmware exists. Adapt procedures to
`b06_hil` hardware once `board_hardware_description.md` is filled.
