galopago/misistemhil/b-hil-boards/b06_hil/firmware/agent-workspaces/tester/handoff.md

# Tester Handoff — `b06_hil`

## Active validation package

`B06_HOST_API_METERING` — partial hardware validation (remote commands on STA).

### Evidence

`test_runs.md` — 2026-11-03 build / flash / `POST /v1/command` suite.

### Result

PASS for mandatory `ping` / `info` / `capabilities` and particular
`meter_read` / `meter_read_all` (including bad channel and unknown command).
mDNS `HIL-06-24CE.local` resolved to `192.168.1.10`.

### Gaps (not blocking observed command function)

- No forced I2C failure case for per-channel `ok: false` in `meter_read_all`
- SoftAP / host-API-down path not exercised
- No static review of `ina219` ↔ `host_api` include boundaries this run
- No dedicated OLED/host concurrency stress beyond concurrent normal operation

### Next

Human: confirm whether gaps above are required before architect closeout.
