galopago/misistemhil/b-hil-boards/b00_basehil/firmware/agent-workspaces/tester/handoff.md

# Tester Handoff

All agentic development methodology documentation in this firmware tree is
maintained in English.

Before starting any task in this file, run the **Role Boundary Check**:

- Read `ROLE.md` in this folder, `../../AGENTS.md`, and `../../docs/methodology.md`.
- Confirm the task is **validation and evidence**, not firmware implementation
  or architecture redefinition.
- If the task requires code fixes or changes to architect handoff criteria, stop
  and tell the human to redirect to implementer or architect unless explicitly
  confirmed.

## Current Status

**Host procedures:** see `procedures.md` (NVS erase, factory reset, **WiFi POST troubleshooting**).

Run 031: **PASS** — saved-boot / power-cycle regression (`HOST_API_AFTER_PORTAL_TEARDOWN`).

Run 030: **PASS** — `HOST_API_AFTER_PORTAL_TEARDOWN` (post-reprovision :80 + /v1 without reboot).

Run 029: **FAIL (partial)** — superseded by Run 030; was post-reprovision :80 refused.

Run 028: **PASS** — `HOST_API_CAPABILITIES_ECHO_LOOPBACK` (ping/info/capabilities/echo + loopback stream) on **saved-boot** path.

Run 027: **PASS** — `OLED_CONNECTED_IP_WIDTH_FIT` (operator: full IPv4 visible on OLED; no truncation).

Run 026: **PASS** — `WIFI_FACTORY_RESET_MDNS_SAFE` (STA+mDNS hold → erase + portal; reboot SoftAP).

Run 025: **FAIL** — `WIFI_FACTORY_RESET_RUNTIME` while STA+mDNS connected (hold detects, then hang; NVS not erased). Superseded by Run 026.

Run 024: **PASS** — `BASE_REMOVE_INA219_MACROS` smoke (build/flash/boot after INA macros removed).

Run 023: **PASS (accepted)** — `DEVICE_DISCOVERY_MDNS_V1` (Entry 028; operator confirmed ping to .local).

Run 022: **PASS** — `WIFI_PROVISIONING_FIRST_CONNECT_FAILURE_UX_V2` (Entry 027; operator-confirmed OLED sequence).

**Field note (2026-06-28):** POST fail `reason=211` = AP security below firmware threshold
(`WIFI_AUTH_WPA2_WPA3_PSK`); not password. See `procedures.md` § WiFi POST troubleshooting;
`feedback.md` Entries 025–026 (openwrt-iot).

Run 021: **PASS** — `WIFI_FACTORY_RESET_RUNTIME` (Entry 024; boot/short-press deferred).

Run 020: **PASS** — `WIFI_CONNECT_CYCLE_AND_ERROR_LED_V2` (Entries 021–023); AP restore deferred.

Run 019: **PARTIAL PASS** — `ERROR_LED_RUNTIME_LINK_STATUS` + `WIFI_RUNTIME_RECONNECT`; boot-lock regression PASS; AP outage blocked.

Run 018: **PASS** — `ERROR_LED_WIFI_LINK_STATUS` (Entries 017–020).

Run 017: **PASS** — `OLED_WIFI_CONNECTED_STATUS` (Entry 016).

Run 016: **PASS** — `OLED_PROVISIONING_SETUP_UX` (Entry 015).

Run 014: **PASS** — saved boot 10/10 (`WIFI_PROVISIONING_SAVED_BOOT_RELIABILITY`).

Run 013: **PASS (POST)** — superseded por Run 014/015 donde aplica.

Run 012: **PARTIAL PASS** — superseded by Run 013 for POST UX.

Run 011: **PARTIAL PASS** — GET / formulario OK; POST falló con 431 (512 bytes). Corregido en Run 012 config.

Run 006: **PASS** completo para `DISPLAY_VISUAL_DEMO_PROTOCOL` (demo retired).

## Architect review — host API missing after fresh POST provision

```text
ID: TESTER_RETURN_HOST_API_AFTER_PROVISION
Date: 2026-11-03
Source: Run 029 operator reprovision; Run 028 contrast (saved boot PASS)
Firmware: 10e21ad-dirty 0xf3590 HOST_API_CAPABILITIES_ECHO_LOOPBACK
Device: HIL-00-24CE / 192.168.1.10 (avahi-resolve; no host RTS reset)

Observed (no board reset during probe):
  OLED: WIFI OK + IP (operator).
  avahi-resolve -n HIL-00-24CE.local → 192.168.1.10; ping OK.
  TCP port 80 (and 8080/8000/443/81/8888): Connection refused.
  curl POST /v1/command → fail connect.
  Passive SoftAP portal httpd gone; STA+mDNS up; host_api not listening.

Contrast:
  Run 028 (cold boot with saved NVS): serial "host API started port=80";
  ping/info/capabilities/echo + loopback PASS.
  Failure is specific to path after factory-reset + new POST provision
  without a subsequent reboot (or equivalent host_api restart).

Tester analysis (code):
  sync_device_discovery on LINK CONNECTED calls device_discovery_start()
  then host_api_start() (app_core_wifi.c).
  POST success emits SUBMITTED_SUCCESS (CONNECTED) while wifi_provisioning
  SoftAP httpd still owns port 80; only later schedule_success_teardown()
  stops that httpd. host_api_start() likely fails bind; error discarded
  via (void)host_api_start(); no retry after teardown.
  Saved-boot has no portal httpd → host_api_start succeeds.

Architect decisions requested:
  1. Confirm intended order: start host API only after portal httpd stopped,
     or stop portal before CONNECTED host_api_start, or retry start after
     teardown.
  2. Acceptance: after POST success (no reboot), /v1/command must work on
     STA IPv4 / .local within bounded time.
  3. Authorize implementer fix + re-test (POST path + saved-boot regression).

Evidence:
  agent-workspaces/tester/test_runs.md Run 029
  agent-workspaces/tester/feedback.md Entry 033
  Terminal: avahi-resolve + port probe 2026-11-03 (no RTS reset)

Architect disposition (2026-11-03): CLOSED → handoff
  HOST_API_AFTER_PORTAL_TEARDOWN (docs). Firmware pending implementer.
  Decision: WIFI_PROV_EVENT_PORTAL_TEARDOWN_COMPLETE after SoftAP httpd stop;
  app_core host_api_start(); port 80 SoftAP XOR host_api; no reboot required.
  Re-test: POST path without reboot + saved-boot regression.

Tester validation (2026-11-03): Run 030 PASS after implementer flash 0xf3730 —
  erase + reprovision without RTS reset; :80 open; /v1 ping/info/echo + loopback OK.
  Return CLOSED.
```

## HOST_API_AFTER_PORTAL_TEARDOWN — Run 031 (power cycle)

```text
ID: HOST_API_AFTER_PORTAL_TEARDOWN saved-boot regression (Run 031)
Source: operator power cycle after Run 030
Commands (no RTS reset): avahi-resolve; :80; ping/info/echo; loopback
  -> /tmp/b00_host_api_run031_power_cycle.txt
Result: mDNS 192.168.1.10, :80 OPEN, all /v1 + loopback PASS
Recommendation: Accept saved-boot regression for HOST_API_AFTER_PORTAL_TEARDOWN.
```

## HOST_API_AFTER_PORTAL_TEARDOWN — Run 030

```text
ID: HOST_API_AFTER_PORTAL_TEARDOWN (Run 030)
Source: implementer fix; closes TESTER_RETURN_HOST_API_AFTER_PROVISION
Commands executed (no RTS reset):
  avahi-resolve / ping HIL-00-24CE.local
  TCP :80; curl ping/info/echo; loopback AQID
  -> /tmp/b00_host_api_run030_post_provision.txt
Hardware: HIL-00-24CE @ 192.168.1.10 after operator erase + reprovision
Result:
  mDNS + ICMP: PASS
  TCP :80 OPEN: PASS (Run 029 was refused)
  ping/info/echo + loopback: PASS
Evidence: test_runs.md Run 030; feedback Entry 034
Recommendation: Accept HOST_API_AFTER_PORTAL_TEARDOWN.
```

## HOST_API_CAPABILITIES_ECHO_LOOPBACK — Run 028

```text
ID: HOST_API_CAPABILITIES_ECHO_LOOPBACK (Run 028)
Source: implementer handoff HOST_API_CAPABILITIES_ECHO_LOOPBACK
Commands executed:
  idf.py build && flash (prior); serial boot -> /tmp/b00_host_api_run028_boot.txt
  curl POST http://HIL-00-24CE.local/v1/command (ping, info, capabilities, echo)
  curl POST /v1/stream/open|write|read|close loopback AQID
  Results -> /tmp/b00_host_api_run028_{results,loopback}.txt
Hardware used:
  ESP32-C3 SuperMini /dev/ttyACM0, OLED 0x3D, STA 192.168.1.10, HIL-00-24CE
Result:
  host_api started port=80 after mdns: PASS (serial)
  mDNS resolve + ping: PASS
  ping / info / capabilities / echo: PASS (HTTP 200, ok:true)
  loopback open→write AQID→read AQID→close: PASS
  SoftAP without /v1: NOT EXERCISED (device remained STA)
Evidence:
  agent-workspaces/tester/test_runs.md Run 028
  agent-workspaces/tester/feedback.md Entry 032
Recommendation:
  Accept HOST_API_CAPABILITIES_ECHO_LOOPBACK for STA command + loopback demos.
  Optional follow-up: SoftAP negative test for /v1 absent.
```

## OLED_CONNECTED_IP_WIDTH_FIT — Run 027

```text
ID: OLED_CONNECTED_IP_WIDTH_FIT (Run 027)
Source: implementer handoff OLED_CONNECTED_IP_WIDTH_FIT
Commands executed:
  idf.py build && idf.py -p /dev/ttyACM0 flash
  Boot portal capture -> /tmp/b00_basehil_boot_log_run027_ip_fit_boot.txt
  Provision listen (partial) -> /tmp/b00_basehil_boot_log_run027_ip_fit_provision.txt
  Operator POST + OLED visual confirmation
Hardware used:
  ESP32-C3 SuperMini on /dev/ttyACM0, OLED @ 0x3C, SoftAP HIL-00-F06F
Result:
  Build/flash 0xe8df0: PASS
  FULL_FOUR_LINES DISPLAY_FONT_MEDIUM (code audit): PASS
  Width budget MEDIUM ≤15 chars fits IPv4 ≤15: PASS (static)
  Operator OLED: full IPv4 on connected screen, no truncation: PASS
Evidence:
  agent-workspaces/tester/test_runs.md Run 027
  agent-workspaces/tester/feedback.md Entry 031
Recommendation:
  Accept OLED_CONNECTED_IP_WIDTH_FIT.
```

## WIFI_FACTORY_RESET_MDNS_SAFE — Run 026

```text
ID: WIFI_FACTORY_RESET_MDNS_SAFE (Run 026)
Source: implementer handoff WIFI_FACTORY_RESET_MDNS_SAFE; re-test of Run 025
Commands executed:
  idf.py build && idf.py -p /dev/ttyACM0 flash (prior turn)
  Serial 60s GPIO7 hold -> /tmp/b00_basehil_boot_log_run026_factory_reset_mdns_safe.txt
  Host RTS reboot 15s -> /tmp/b00_basehil_boot_log_run026_after_reset_reboot.txt
Hardware used:
  ESP32-C3 SuperMini on /dev/ttyACM0; saved STA openwrt-iot 192.168.1.11 + mDNS
Result:
  Build/flash 0xe8df0: PASS
  STA+mDNS then GPIO7 ≥10 s: PASS
  factory reset requested → abort → stopping wifi → SoftAP portal: PASS (~120 ms)
  factory reset complete portal_active=true: PASS
  mdns stop reason=portal (after WiFi stop; no hang): PASS
  Post-reboot SoftAP portal (no STA reconnect): PASS — NVS erased
Evidence:
  agent-workspaces/tester/test_runs.md Run 026
  agent-workspaces/tester/feedback.md Entry 030
Recommendation:
  Accept WIFI_FACTORY_RESET_MDNS_SAFE. Closes TESTER_RETURN_FACTORY_RESET_MDNS_HANG.
```

## WIFI_FACTORY_RESET_RUNTIME — Run 025 (STA+mDNS hang)

```text
ID: WIFI_FACTORY_RESET_RUNTIME (Run 025 regression)
Source: operator report — factory reset button not working as expected
Commands executed:
  Serial 45s during GPIO7 hold -> /tmp/b00_basehil_boot_log_run025_factory_reset_hold.txt
  Post-hang reboot 18s -> /tmp/b00_basehil_boot_log_run025_after_failed_reset.txt
Hardware used:
  ESP32-C3 SuperMini on /dev/ttyACM0, OLED @ 0x3C
  Saved STA openwrt-iot, IP 192.168.1.11, mDNS HIL-00-F06F
Result:
  GPIO7 10 s hold detected: PASS — W app_core_wifi: factory reset requested (runtime) @ 23462 ms
  mdns stop / erase / portal transition logs: FAIL (absent; serial silent after W line)
  Device idle after hang: FAIL (0 serial bytes until host RTS reset)
  NVS credentials cleared: FAIL — reboot reconnects STA openwrt-iot + mdns start
Root cause (tester analysis):
  factory_reset_runtime_sequence logs, then calls device_discovery_stop("factory_reset").
  Next expected log is device_discovery: mdns stop reason=factory_reset — never appears.
  Hang is inside device_discovery_stop() before that log, i.e. mdns_unregister_netif()
  while STA/mDNS active. Erase + wifi_provisioning_factory_reset_to_portal never run.
  Note: Run 021 PASS was from portal/connect-cycle path; STA+mDNS path not covered then.
Evidence:
  agent-workspaces/tester/test_runs.md Run 025
  agent-workspaces/tester/feedback.md Entry 029
  /tmp/b00_basehil_boot_log_run025_factory_reset_hold.txt
  /tmp/b00_basehil_boot_log_run025_after_failed_reset.txt
Recommendation:
  Return to implementer/architect — see TESTER_RETURN_FACTORY_RESET_MDNS_HANG below.
```

## Architect / implementer review — Run 025 factory reset hang

```text
ID: TESTER_RETURN_FACTORY_RESET_MDNS_HANG
Date: 2026-11-03
Source: Run 025, feedback Entry 029, operator discussion request
Firmware: 10e21ad-dirty 0xe8e80
Prior accepted path: Run 021 WIFI_FACTORY_RESET_RUNTIME (portal / connect-cycle)

Summary for human → implementer conversation:
  GPIO7 factory reset IS detected after ≥10 s hold while STA is connected with
  mDNS active, but the runtime sequence hangs and never erases NVS or opens the
  provisioning portal. After a forced reset, saved credentials remain and the
  device rejoins the home AP.

Code path (app_core_wifi.c factory_reset_runtime_sequence):
  1. ESP_LOGW factory reset requested (runtime)     ← OBSERVED
  2. device_discovery_stop("factory_reset")
       → mdns_unregister_netif(sta)                 ← HANG (no "mdns stop" log)
  3. wifi_credentials_erase()                       ← NOT REACHED
  4. wifi_provisioning_factory_reset_to_portal()    ← NOT REACHED

Why Run 021 did not catch this:
  Run 021 exercised reset from portal / connect-cycle (mDNS not announcing).
  DEVICE_DISCOVERY_MDNS_V1 deferred factory_reset mdns stop; STA-connected
  factory reset was not an acceptance case after mDNS landed.

Tester recommendations (for architect decision / implementer fix):
  1. Make factory reset safe when mDNS is active (ordering: stop WiFi / clear
     abort path before or without blocking mdns_unregister_netif; or stop mDNS
     from a context that cannot deadlock; or skip unregister and mdns_free).
  2. Guarantee erase + portal still run even if discovery stop fails.
  3. Add acceptance: STA connected + mDNS active → GPIO7 ≥10 s → NVS cleared,
     SoftAP portal, serial shows erase + portal_active without hang.
  4. Re-test portal-mode reset (Run 021) as regression after the fix.

Tester does NOT change firmware or architecture docs. Operator will discuss
with implementer; architect should authorize the fix handoff if criteria change.

Evidence:
  agent-workspaces/tester/test_runs.md Run 025
  agent-workspaces/tester/feedback.md Entry 029
  /tmp/b00_basehil_boot_log_run025_{factory_reset_hold,after_failed_reset}.txt
```

## BASE_REMOVE_INA219_MACROS — Run 024

```text
ID: BASE_REMOVE_INA219_MACROS (Run 024)
Source: agent-workspaces/implementer/handoff.md § BASE_REMOVE_INA219_MACROS
Commands executed:
  source ~/esp/esp-idf/export.sh
  idf.py build && idf.py -p /dev/ttyACM0 flash
  Serial 20s -> /tmp/b00_basehil_boot_log_run024_ina_removed.txt
  Source/binary audit for BOARD_INA219 / ina219
Hardware used:
  ESP32-C3 SuperMini on /dev/ttyACM0, OLED @ 0x3C
  SoftAP HIL-00-F06F (MAC 8c:d0:b2:a7:f0:6f)
Result:
  Build/flash 0xe8e80: PASS
  No INA macros/refs in main/components or binary: PASS
  Boot I2C + OLED 0x3C + SoftAP portal: PASS
  No INA probe logs: PASS
Evidence:
  agent-workspaces/tester/test_runs.md Run 024
  /tmp/b00_basehil_boot_log_run024_ina_removed.txt
Recommendation:
  Accept BASE_REMOVE_INA219_MACROS smoke. Base still boots and runs OLED/I2C
  provisioning path without INA219 macros.
```

## DEVICE_DISCOVERY_MDNS_V1 — Run 023

```text
ID: DEVICE_DISCOVERY_MDNS_V1 (Run 023)
Source: agent-workspaces/implementer/handoff.md § DEVICE_DISCOVERY_MDNS_V1
  docs/device_discovery_mdns_architecture.md
  docs/test_strategy.md § LAN mDNS discovery
NVS at test start: erased via host (procedures.md)
Network: openwrt-iot (WPA2/WPA3 mixed 2.4 GHz)
Commands executed:
  idf.py build && idf.py -p /dev/ttyACM0 flash
  esptool.py erase_region 0x9000 0x6000
  Serial portal 20s -> /tmp/b06_hil_boot_log_run023_portal.txt
  Serial provision 150s -> /tmp/b06_hil_boot_log_run023_mdns.txt
  Operator POST openwrt-iot from phone on HIL-00-24CE
  avahi-resolve -n HIL-00-24CE.local; ping HIL-00-24CE.local
Hardware used:
  ESP32-C3 SuperMini on /dev/ttyACM0, OLED @ 0x3C
  SoftAP HIL-00-24CE (MAC 8c:d0:b2:a9:24:ce)
Result:
  Build/flash 0xe8e60: PASS (matches implementer handoff)
  Portal boot without mdns start: PASS
  identity HIL-00-24CE (SoftAP MAC4): PASS
  POST + STA got IP 192.168.1.9: PASS (serial)
  mdns start hostname=HIL-00-24CE: PASS (serial)
  HIL-00-24CE.local resolves to 192.168.1.9: PASS (avahi-resolve < 2 s; ping OK)
  Operator acceptance: PASS — ping HIL-00-24CE.local returns device IPv4 (2026-06-29)
  Deferred: link_lost outage, factory_reset mdns stop
Evidence:
  agent-workspaces/tester/test_runs.md Run 023
  agent-workspaces/tester/feedback.md Entry 028
  /tmp/b06_hil_boot_log_run023_{portal,mdns}.txt
Recommendation:
  **Accepted** DEVICE_DISCOVERY_MDNS_V1 for core v1 LAN discovery on openwrt-iot.
  Operator confirmed ping to HIL-00-24CE.local resolves to STA IP.
```

## WIFI_PROVISIONING_FIRST_CONNECT_FAILURE_UX_V2 — Run 022

```text
ID: WIFI_PROVISIONING_FIRST_CONNECT_FAILURE_UX_V2 (Run 022)
Source: agent-workspaces/implementer/handoff.md § WIFI_PROVISIONING_FIRST_CONNECT_FAILURE_UX_V2
  docs/wifi_provisioning_first_connect_failure_ux_proposal.md
  docs/test_strategy.md § First-connect failure OLED and LED
NVS at test start: erased via host (procedures.md)
Commands executed:
  idf.py build && idf.py -p /dev/ttyACM0 flash
  esptool.py erase_region 0x9000 0x6000
  Serial capture 120s -> /tmp/b06_hil_boot_log_run022_failure_flash.txt
  Operator POST openwrt-iot + wrong password from phone on HIL-00-24CE
Hardware used:
  ESP32-C3 SuperMini on /dev/ttyACM0, OLED @ 0x3C
  SoftAP HIL-00-24CE (MAC 8c:d0:b2:a9:24:ce)
Result:
  Build/flash 0xde470: PASS (matches implementer handoff)
  Boot QR setup OLED: PASS (operator Entry 027)
  POST failure serial (reason=202, no NVS save, no teardown): PASS
  OLED CONNECTING → FAILED (~3s) → QR restore: PASS (operator-confirmed visual, Entry 027)
  Browser failure page + AP active after failure: PASS (operator-confirmed, Entry 027)
  Operator post-run confirmation: tests successful; OLED order matches UX v2 spec
  Deferred (non-core): invalid form, re-POST during flash, reboot without creds
Evidence:
  agent-workspaces/tester/test_runs.md Run 022
  agent-workspaces/tester/feedback.md Entry 027
  /tmp/b06_hil_boot_log_run022_failure_flash.txt
Recommendation:
  Accept WIFI_PROVISIONING_FIRST_CONNECT_FAILURE_UX_V2 for core v1 operator path.
  Operator confirmed display sequence on hardware (2026-06-29).
```

## WIFI_FACTORY_RESET_RUNTIME — Run 021

```text
ID: WIFI_FACTORY_RESET_RUNTIME (Run 021)
Source: docs/wifi_factory_reset_architecture.md, architect handoff
Commands: build/flash; 70s serial during operator GPIO7 hold (portal mode)
Result:
  Build 0xde220, static, runtime reset serial: PASS
  Connect-cycle abort + portal + QR: PASS (serial + human Entry 024)
  Reprovision vitriolina after reset: PASS (human Entry 024)
Evidence: test_runs.md Run 021, feedback Entry 024, /tmp/b06_hil_factory_reset_user_test.txt
Recommendation: Accept WIFI_FACTORY_RESET_RUNTIME for v1 operator path.
```

## ERROR_LED_RUNTIME_LINK_STATUS + WIFI_RUNTIME_RECONNECT — Run 019

```text
ID: ERROR_LED_RUNTIME_LINK_STATUS, WIFI_RUNTIME_RECONNECT (Run 019)
Source: agent-workspaces/implementer/handoff.md
  docs/error_led_runtime_link_architecture.md
  docs/wifi_runtime_reconnect_architecture.md
NVS at test start: invalid injected creds (NONEXISTENT_AP_XYZ) from Run 018 Phase C
Commands executed:
  idf.py build && idf.py -p /dev/ttyACM0 flash
  Static audits (module boundaries, new events, runtime log strings)
  Boot lock regression serial 38s -> /tmp/b06_hil_boot_log_run019_lock_regression.txt
  Initial boot capture -> /tmp/b06_hil_boot_log_run019_initial.txt
Hardware used:
  ESP32-C3 SuperMini on /dev/ttyACM0, GPIO8 error LED, OLED @ 0x3C
Result:
  Build/flash 0xde060: PASS (matches implementer handoff)
  wifi_provisioning no error_led/display includes: PASS
  LINK_STATUS_CHANGED + RUNTIME_* events in header: PASS
  app_core_wifi LINK_STATUS_CHANGED no OLED; RUNTIME OLED handlers: PASS (code review)
  Runtime log strings in binary: PASS
  Boot lock regression (bad saved creds, 5 attempts): PASS
  No runtime reconnect logs during boot lock: PASS
  AP power-cycle while connected: NOT EXERCISED (host on 192.168.1.x; device AP vitriolina 192.168.80.x)
  Long outage / LED ON without HOLD RESET: NOT EXERCISED
  RUNTIME_RESTORED serial path: NOT EXERCISED
  ERROR_LED runtime loss/restore visual: NOT EXERCISED
Evidence:
  agent-workspaces/tester/test_runs.md Run 019
  /tmp/b06_hil_boot_log_run019_{initial,lock_regression}.txt
Blocked follow-up (operator):
  1. esptool erase_region 0x9000 0x6000 + re-provision vitriolina
  2. Wait STA got IP source=saved
  3. Power-cycle home AP 30s -> expect LED ON, OLED WIFI/CONNECTING, source=runtime logs
  4. Restore AP -> expect RUNTIME_RESTORED, LED off, OLED WIFI OK
Recommendation:
  Accept build/static/boot-lock criteria. Defer runtime reconnect + runtime LED until
  operator completes AP outage procedure or provides serial capture during outage.
```

## ERROR_LED_WIFI_LINK_STATUS — Run 018

```text
ID: ERROR_LED_WIFI_LINK_STATUS (Run 018)
Source: agent-workspaces/implementer/handoff.md, docs/error_led_wifi_link_architecture.md
Commands executed:
  idf.py build && idf.py -p /dev/ttyACM0 flash
  Static audits (module boundaries, timing, init order)
  Phase B: saved-credentials boot -> /tmp/b06_hil_boot_log_run018_phaseB_saved.txt
  Phase A: NVS erase + portal boot -> /tmp/b06_hil_boot_log_run018_phaseA_fresh.txt
  Phase C: injected bad NVS + lock capture -> /tmp/b06_hil_boot_log_run018_phaseC_locked.txt
Hardware used:
  ESP32-C3 SuperMini on /dev/ttyACM0, GPIO8 error LED (active-low)
Result:
  Build/flash 0xdd7d0: PASS
  Module boundary audit: PASS
  GPIO8 output init at boot: PASS
  Fresh NVS portal (UNPROVISIONED / slow blink): PASS (serial + human Entry 017)
  Saved boot solid ON while connecting (CONNECTING): PASS (serial + human Entry 018)
  Saved boot off after connect (CONNECTED): PASS (serial + human Entry 019)
  Locked failure fast blink (DISCONNECTED): PASS (serial + human Entry 020)
  POST SUBMITTED_SUCCESS path: NOT EXERCISED (same CONNECTED → OFF mapping as SAVED_SUCCESS)
Evidence:
  agent-workspaces/tester/test_runs.md Run 018
  agent-workspaces/tester/feedback.md Entries 017–020
  /tmp/b06_hil_boot_log_run018_phase{C,_retest}.txt
Recommendation:
  Accept ERROR_LED_WIFI_LINK_STATUS. All acceptance criteria 1–6 satisfied for v1 scope.
```

## OLED_WIFI_CONNECTED_STATUS — Run 017

```text
ID: OLED_WIFI_CONNECTED_STATUS (Run 017)
Source: agent-workspaces/implementer/handoff.md
NVS: saved credentials (vitriolina) from prior operator session
Commands executed:
  idf.py build && idf.py -p /dev/ttyACM0 flash
  Reboot serial capture -> /tmp/b06_hil_boot_log_run017.txt
Hardware used:
  ESP32-C3 SuperMini on /dev/ttyACM0, OLED @ 0x3C
  STA MAC: 8c:d0:b2:a9:24:cd
Result:
  Build/flash 0xdd250: PASS
  wifi_prov_event_info sta_ipv4/sta_mac fields: PASS (header review)
  emit_sta_success_event on SAVED_SUCCESS: PASS (code + serial connect)
  Saved boot STA got IP: PASS — 192.168.80.184 attempt 3/5
  Binary string WIFI OK: PASS
  Expected OLED 4-line connected screen:
    WIFI OK / 192.168.80.184 / 8C:D0:B2 / A9:24:CD
  OLED physical + match router IP/MAC: PASS — Entry 016
  POST SUBMITTED_SUCCESS connected screen: NOT EXERCISED (saved boot path; same handler)
Evidence:
  agent-workspaces/tester/test_runs.md Run 017
  agent-workspaces/tester/feedback.md Entry 016
  /tmp/b06_hil_boot_log_run017.txt
Recommendation:
  Accept OLED_WIFI_CONNECTED_STATUS.
```

## OLED_PROVISIONING_SETUP_UX — Run 016

```text
ID: OLED_PROVISIONING_SETUP_UX (Run 016)
Source: agent-workspaces/implementer/handoff.md
NVS: erased via host (procedures.md)
Commands executed:
  idf.py build && idf.py -p /dev/ttyACM0 flash
  esptool.py erase_region 0x9000 0x6000
  Serial capture -> /tmp/b06_hil_boot_log_run016.txt
  strings grep on firmware binary
Hardware used:
  ESP32-C3 SuperMini on /dev/ttyACM0, OLED @ 0x3C
Result:
  Build/flash 0xdd060: PASS
  wifi_provisioning no display includes: PASS
  AP SSID HIL-00-24CE + portal 192.168.4.1: PASS
  Binary contains 1 JOIN / 2 SCAN QR strings: PASS
  No DEMO_STEP on boot: PASS
  show_provisioning_setup_display code audit (4-line split): PASS
  OLED visual (QR left, 1 JOIN / HIL-00- / 24CE / 2 SCAN QR right): PASS — Entry 015
  Phone join AP + scan QR + portal: PASS (operator, prior sessions)
Evidence:
  agent-workspaces/tester/test_runs.md Run 016
  agent-workspaces/tester/feedback.md Entry 015
  /tmp/b06_hil_boot_log_run016.txt
Recommendation:
  Accept OLED_PROVISIONING_SETUP_UX.
```

## PRODUCT_BOOT_DISPLAY_AND_DYNAMIC_AP_SSID — Run 015

```text
ID: PRODUCT_BOOT_DISPLAY_AND_DYNAMIC_AP_SSID (Run 015)
Source: agent-workspaces/implementer/handoff.md
NVS: erased via host (procedures.md) — fresh provisioning boot
Commands executed:
  idf.py build && idf.py -p /dev/ttyACM0 flash
  esptool.py erase_region 0x9000 0x6000
  Serial capture 15s -> /tmp/b06_hil_boot_log_run015.txt
  strings grep on b00_basehil_firmware.bin
Hardware used:
  ESP32-C3 SuperMini on /dev/ttyACM0, OLED @ 0x3C
  SoftAP MAC: 8c:d0:b2:a9:24:ce
Result:
  Build/flash 0xdcfb0: PASS (matches implementer handoff)
  Binary grep b06_hil_setup / DEMO_STEP / demo symbols: PASS (absent)
  Dynamic SSID generated: PASS — HIL-00-24CE (MAC bytes 24:ce)
  starting SoftAP uses same SSID: PASS
  Portal http://192.168.4.1: PASS
  Dynamic SSID + portal: PASS
  POST human (form, home WiFi): PASS — Entry 014
  Reboot after POST: PASS — STA got IP source=saved
Evidence:
  agent-workspaces/tester/test_runs.md Run 015
  agent-workspaces/tester/feedback.md Entry 014
  /tmp/b06_hil_boot_log_run015_reboot.txt
Recommendation:
  Accept PRODUCT_BOOT_DISPLAY_AND_DYNAMIC_AP_SSID (full run including human POST).
```

## WIFI_PROVISIONING_SAVED_BOOT_RELIABILITY — Run 014

```text
ID: WIFI_PROVISIONING_SAVED_BOOT_RELIABILITY (Run 014)
Source: agent-workspaces/implementer/handoff.md
NVS: saved credentials from Run 013 (vitriolina)
Commands executed:
  idf.py build && idf.py -p /dev/ttyACM0 flash
  10-boot cold reboot sweep -> /tmp/b06_hil_run014_sweep_summary.json
Hardware used:
  ESP32-C3 SuperMini on /dev/ttyACM0, OLED @ 0x3C
Result:
  Build/flash 0xdd160: PASS
  10/10 saved boot STA got IP source=saved: PASS
  0/10 locked failures: PASS
  reason 202 recovered on attempt 3/5 (all boots): PASS
  GPIO7 factory reset: NOT EXERCISED
Evidence:
  agent-workspaces/tester/test_runs.md Run 014
  /tmp/b06_hil_run014_sweep_summary.json
  /tmp/b06_hil_boot_log_run014_boot01.txt (sample)
Recommendation:
  Accept WIFI_PROVISIONING_SAVED_BOOT_RELIABILITY. Close Run 013 saved-boot gap.
  Remaining: GPIO7 factory reset (not implemented).
```

## WIFI_PROVISIONING_POST_SUCCESS_COMMIT — Run 013

```text
ID: WIFI_PROVISIONING_POST_SUCCESS_COMMIT (Run 013)
Source: agent-workspaces/implementer/handoff.md
NVS at boot: erased via host (procedures.md)
Commands executed:
  idf.py build && idf.py -p /dev/ttyACM0 flash
  esptool.py erase_region 0x9000 0x6000
  Serial capture -> /tmp/b06_hil_boot_log_run013_full.txt
Hardware used:
  ESP32-C3 SuperMini on /dev/ttyACM0, OLED @ 0x3C
  Test host: ethernet only (no WiFi client for AP join)
Result:
  Build/flash 0xdcb20: PASS
  POST human UX (browser, AP teardown, OLED): PASS — Entry 011
  STA ping when connected: PASS — Entry 012
  Reboot STA got IP source=saved: INTERMITTENT — 2/5 pass, 3/5 auth fail 202 — Entry 013
  POST serial during submit: NOT CAPTURED
  GPIO7 factory reset: NOT EXERCISED
Evidence:
  agent-workspaces/tester/test_runs.md Run 013
  agent-workspaces/tester/feedback.md Entries 011–013
  /tmp/b06_hil_boot_log_run013_reboot.txt
  /tmp/b06_hil_reboot_sweep_run013.txt
Recommendation:
  Accept WIFI_PROVISIONING_POST_SUCCESS_COMMIT for POST/submitted path.
  Do NOT close full WIFI_PROVISIONING_ARCHITECTURE saved-boot reliability until
  architect decides criteria and implementer addresses intermittent auth.
  Forward to architect: TESTER_RETURN_SAVED_BOOT_RELIABILITY.
```

## Architect review — Run 013 saved-boot intermittency

```text
ID: TESTER_RETURN_SAVED_BOOT_RELIABILITY
Date: 2026-06-24
Source: Run 013 validation, feedback Entry 013, test_runs.md Run 013
Firmware: 0xdcb20, WIFI_PROVISIONING_POST_SUCCESS_COMMIT
Handoff under review: WIFI_PROVISIONING_ARCHITECTURE (reboot / saved credentials)

Summary:
  POST provisioning path PASSES (browser success, AP teardown, OLED WIFI OK, NVS save).
  Saved-credential cold boot is INTERMITTENT: 3/5 reboots fail with
  WIFI_REASON_AUTH_FAIL (202) at ~1 s; 2/5 obtain STA got IP source=saved.
  Operator saw WIFI CONNECTING then WIFI FAILED on failed boots (expected locked path).
  Same credentials work when boot succeeds; ping OK when connected.

Why credentials are not the problem:
  - NVS unchanged between pass/fail boots.
  - Successful boots: wifi:connected with vitriolina, WPA3-SAE, IP 192.168.80.184.
  - Failed boots: auth -> init before association; reason=202, not timeout alone.

Code factors (wifi_provisioning.c):
  - wifi_provisioning_connect_saved: STA-only, esp_wifi_start(), one wait_for_sta_connected.
  - POST path: APSTA with warm stack — more reliable in testing.
  - wait_for_sta_connected: single esp_wifi_connect(), 30 s wait for GOT_IP only.
  - apply_sta_config: threshold.authmode = WIFI_AUTH_WPA2_PSK; operator AP uses WPA3-SAE.
  - No app retry before SAVED_FAILURE_LOCKED / OLED WIFI FAILED HOLD RESET.

Tester recommendations for architect decision:
  1. Define v1 acceptance: single successful reboot vs N consecutive cold boots.
  2. Define supported home-router security (WPA2 only vs WPA3-SAE explicit).
  3. Decide if saved-boot should retry before locked FAILED state.
  4. If criteria tighten, authorize implementer handoff for retry/authmode/timing.

Tester does NOT change architecture or firmware. Await architect handoff.

Evidence:
  agent-workspaces/tester/feedback.md Entry 013 (full analysis)
  /tmp/b06_hil_reboot_sweep_run013.txt
  /tmp/b06_hil_boot_log_run013_post_human.txt
```

## WIFI_PROVISIONING_ARCHITECTURE

```text
ID: WIFI_PROVISIONING_ARCHITECTURE
Source: agent-workspaces/implementer/handoff.md, docs/wifi_provisioning_architecture.md,
        docs/test_strategy.md WiFi Provisioning Criteria
NVS at boot: fresh (no saved credentials)
CONFIG_B00_BASEHIL_DISPLAY_VISUAL_DEMO: y (demo gated off while portal active)
Commands executed:
  idf.py build
  idf.py -p /dev/ttyACM0 flash
  Static audits + HTML/page code review
  Serial capture 22s -> /tmp/b06_hil_boot_log_run007.txt
Hardware used:
  ESP32-C3 SuperMini on /dev/ttyACM0, OLED @ 0x3C
Result:
  Build/flash: PASS (0xdacc0)
  Static/component criteria: PASS
  Boot AP + DHCP 192.168.4.1: PASS (serial)
  Phone sees and joins b06_hil_setup: PASS (human)
  OLED QR → http://192.168.4.1 in browser: PASS (human)
  GET / setup form loads in browser: FAIL (blank page)
  POST /provision, reboot, GPIO7 reset: BLOCKED (portal failure)
Reproducible failures:
  1. Join b06_hil_setup from phone → open http://192.168.4.1 → blank page, no HTML.
Reproducible failure steps:
  1. Flash Run 007 firmware with fresh/erased wifi_prov credentials.
  2. Connect phone to open AP b06_hil_setup.
  3. Open http://192.168.4.1 (QR or manual).
  4. Observe: page does not load (blank).
Evidence:
  agent-workspaces/tester/test_runs.md Run 007
  agent-workspaces/tester/feedback.md Entry 003
  /tmp/b06_hil_boot_log_run007.txt
  /tmp/b06_hil_boot_log_run007b.txt
Recommendation:
  Return to implementer. Fix portal HTTP before re-test. Suggested: log httpd lifecycle,
  defer httpd_start until AP ready (WIFI_EVENT_AP_START), verify DHCP lease on phone.
```

## WIFI_PROVISIONING_ARCHITECTURE — Run 008 re-test (fix regression)

```text
ID: WIFI_PROVISIONING_ARCHITECTURE (Run 008 re-test)
Source: implementer handoff Run 007 fix, feedback Entry 003
Commands executed:
  idf.py build && idf.py -p /dev/ttyACM0 flash
  Serial capture 25s -> /tmp/b06_hil_boot_log_run008.txt
Hardware used:
  ESP32-C3 SuperMini on /dev/ttyACM0, OLED @ 0x3C
Result:
  Build: PASS (0xdb2a0)
  Flash: PASS
  Boot stable: FAIL — reboot loop (ESP_ERROR_CHECK abort on wifi start timeout)
  SoftAP event logged: PASS (wifi_prov: SoftAP started at ~634 ms)
  wait_for_ap_started: FAIL — E (10645) SoftAP start timeout
  HTTP server started / portal ready: FAIL (never reached)
  GET / from phone: NOT EXERCISED (device aborts before portal ready)
Reproducible failures:
  1. Flash Run 008 firmware → boot → abort after 10 s → reboot loop.
Root cause (tester analysis):
  Race in wait_for_ap_started(): WIFI_EVENT_AP_START fires and sets bit during
  esp_wifi_start(), then wait_for_ap_started() clears the bit and waits for a
  second AP_START that never comes → ESP_ERR_TIMEOUT → ESP_ERROR_CHECK in app_core.
Evidence:
  agent-workspaces/tester/test_runs.md Run 008
  agent-workspaces/tester/feedback.md Entry 004
  /tmp/b06_hil_boot_log_run008.txt
Recommendation:
  Return to implementer. Fix: clear WIFI_AP_STARTED_BIT before esp_wifi_start(), or
  do not clear if event already received; avoid ESP_ERROR_CHECK abort on recoverable
  provisioning errors.
```

## WIFI_PROVISIONING_ARCHITECTURE — Run 009 re-test (Run 008 race fix)

```text
ID: WIFI_PROVISIONING_ARCHITECTURE (Run 009)
Source: implementer handoff Run 008 race fix, feedback Entry 004
Commands executed:
  idf.py build && idf.py -p /dev/ttyACM0 flash
  Serial capture 22s -> /tmp/b06_hil_boot_log_run009.txt
Hardware used:
  ESP32-C3 SuperMini on /dev/ttyACM0, OLED @ 0x3C
Result:
  Build: PASS (0xdb290)
  Flash: PASS
  Boot stable: PASS (no reboot loop)
  Portal startup serial sequence: PASS (SoftAP → HTTP → portal ready)
  Phone GET / setup form: FAIL (human blank page; 0× GET / in serial with station joined)
Evidence:
  agent-workspaces/tester/test_runs.md Run 009
  agent-workspaces/tester/feedback.md Entry 005
  /tmp/b06_hil_boot_log_run009.txt
  /tmp/b06_hil_boot_log_run009c.txt
Recommendation:
  Return to implementer. HTTP does not reach handler despite portal ready + phone join.
  Investigate DHCP lease, httpd bind on AP netif, dhcps restart in configure_ap_netif_ip.
```

## WIFI_PROVISIONING_PORTAL_REACHABILITY — Run 010

```text
ID: WIFI_PROVISIONING_PORTAL_REACHABILITY (Run 010)
Source: implementer handoff, architect handoff, docs/test_strategy.md
Commands executed:
  idf.py build && idf.py -p /dev/ttyACM0 flash
  Serial capture 45s -> /tmp/b06_hil_boot_log_run010.txt
Result:
  Build/flash: PASS (0xdb770)
  Startup contract + DHCP 192.168.4.2: PASS
  GET / handler invoked: PASS
  GET / HTML delivered without panic: FAIL (stack protection fault)
  Human portal form visible: FAIL
Evidence:
  test_runs.md Run 010, feedback.md Entry 006, /tmp/b06_hil_boot_log_run010.txt
Recommendation:
  Implementer: fix httpd stack / page buffer; re-test /health then /.
```

## WIFI_PROVISIONING_HTTP_STACK_SAFETY — Run 011

```text
ID: WIFI_PROVISIONING_HTTP_STACK_SAFETY (Run 011)
Commands: idf.py build && flash; serial 50s -> /tmp/b06_hil_boot_log_run011.txt
Result:
  Build/flash: PASS (0xdc430)
  GET / response sent without panic: PASS
  Human form visible: PASS
  POST /provision: FAIL (HTTP 431 header too long; CONFIG_HTTPD_MAX_REQ_HDR_LEN=512)
Evidence: test_runs.md Run 011, feedback.md Entry 007, /tmp/b06_hil_boot_log_run011b.txt
Recommendation: Implementer raise HTTPD_MAX_REQ_HDR_LEN; re-test POST. GET / accepted.
```

## WIFI_PROVISIONING_HTTP_HEADER_BUDGET — Run 012

```text
ID: WIFI_PROVISIONING_HTTP_HEADER_BUDGET (Run 012)
Commands: reconfigure, build, flash; serial 60s -> /tmp/b06_hil_boot_log_run012.txt
Result:
  CONFIG_HTTPD_MAX_REQ_HDR_LEN=2048: PASS (build/sdkconfig.h)
  Build/flash: PASS (0xdc5a0)
  GET / regression: PASS; no HTTP 431 in log
  POST /provision handler: NOT EXERCISED (no submit during capture)
Evidence: test_runs.md Run 012, feedback.md Entry 008
Recommendation: Operator submit form; expect handler logs without 431.
```

## DISPLAY_VISUAL_DEMO_PROTOCOL

```text
ID: DISPLAY_VISUAL_DEMO_PROTOCOL
Source: docs/display_visual_demo_protocol.md, implementer handoff
Kconfig: CONFIG_B00_BASEHIL_DISPLAY_VISUAL_DEMO=y
Commands executed:
  idf.py build && idf.py -p /dev/ttyACM0 flash
  Serial capture 35s after reset
Hardware used:
  ESP32-C3 SuperMini, OLED @ 0x3C
Result:
  Build/flash: PASS (0x3a2e0)
  DEMO_STEP 1/3 FULL_FOUR_LINES: PASS (serial + visual)
  DEMO_STEP 2/3 QR_SETUP: PASS (serial + visual; phone scan OK)
  DEMO_STEP 3/3 FULL_TWO_LINES: PASS (serial + visual)
  QR phone scan: yes (http://192.168.4.1)
Reproducible failures:
  None in Run 006.
Evidence:
  agent-workspaces/tester/test_runs.md Run 006
  agent-workspaces/tester/feedback.md Entry 002
  /tmp/b06_hil_boot_log_run006.txt
Recommendation:
  Accept DISPLAY_VISUAL_DEMO_PROTOCOL and display v1 demo on hardware.
```

## DISPLAY_DELIVERY_CONTRACT + QR_ENCODER_INTERFACE

```text
ID: DISPLAY_DELIVERY_CONTRACT, QR_ENCODER_INTERFACE
Source: agent-workspaces/implementer/handoff.md, docs/test_strategy.md
Commands executed:
  idf.py build && idf.py flash
  Host qr_host_test (setup_url + display_qr)
  Serial capture + grep audit
Hardware used:
  ESP32-C3 SuperMini, OLED @ 0x3C
Result:
  Build/flash/boot: PASS (0x39f00)
  setup_url on-device self-test: PASS
  display_qr host matrix tests: PASS
  Delivery caller grep: PASS
  SSD1306 + four-line demo boot: PASS (serial; visual from Run 004)
  QR scan on physical OLED: NOT EXERCISED
  Invalid QR at runtime: NOT EXERCISED
Reproducible failures:
  None in Run 005.
Evidence:
  agent-workspaces/tester/test_runs.md Run 005
  /tmp/b06_hil_boot_log_run005.txt
Recommendation:
  Accept encoder and delivery contract for v1. Run 006: visual demo protocol
  per docs/display_visual_demo_protocol.md (QR on hardware).
```

## I2C_BUS_PHASE2

```text
ID: I2C_BUS_PHASE2
Source: agent-workspaces/implementer/handoff.md, docs/test_strategy.md
Commands executed:
  source ~/esp/esp-idf/export.sh
  idf.py build
  idf.py -p /dev/ttyACM0 flash
  Serial capture 115200 / 15s after flash
Hardware used:
  ESP32-C3 SuperMini on /dev/ttyACM0 with I2C OLED at 0x3C
Result:
  Build: PASS (0x34de0 bytes)
  Flash: PASS
  i2c_bus_transceive / SSD1306 init: PASS
  Stable boot / display_task: PASS
  OLED I2C traffic: ACTIVE
  Two-task concurrent transceive: NOT EXERCISED
  Timeout recovery: NOT EXERCISED
  OLED-absent stub fallback: NOT EXERCISED
  Human visual FULL_FOUR_LINES: PASS (operator: b00_basehil, READY, v0.1 on panel)
Reproducible failures:
  None in Run 004.
Evidence:
  agent-workspaces/tester/test_runs.md Run 004
  agent-workspaces/tester/feedback.md Entry 001
  /tmp/b06_hil_boot_log_run004.txt
Recommendation:
  Accept phase 2 for SSD1306 display path with OLED present. Before phase 3,
  add harness or INA219 for concurrent transceive and timeout tests per
  test_strategy.md.
```

## I2C_BUS_ARCHITECTURE

```text
ID: I2C_BUS_ARCHITECTURE
Source: agent-workspaces/implementer/handoff.md
Commands executed:
  source ~/esp/esp-idf/export.sh
  idf.py build
  idf.py -p /dev/ttyACM0 flash
  Serial capture 115200 / 12s after flash
Hardware used:
  ESP32-C3 SuperMini on /dev/ttyACM0 with I2C OLED responding at 0x3C
Result:
  Build: PASS (0x33740 bytes)
  Flash: PASS
  i2c_bus_init on GPIO0/GPIO1 @ 400 kHz: PASS
  OLED probe/register at 0x3C: PASS
  Stable boot / display_task: PASS
  OLED-absent warning path: NOT EXERCISED (OLED connected)
  OLED frame flush / visual: BLOCKED (driver stub)
Reproducible failures:
  None in Run 003.
Evidence:
  agent-workspaces/tester/test_runs.md Run 003
  /tmp/b06_hil_boot_log_run003.txt
Recommendation:
  Accept I2C phase 1 for present-OLED startup. Optionally re-test OLED-absent
  bench (expect app_core warning + stub without I2C device). Next: SSD1306/SH1106
  driver in display_driver to validate physical FULL_FOUR_LINES output.
```

## OLED_TEXT_DISPLAY_INTERFACE

```text
ID: OLED_TEXT_DISPLAY_INTERFACE
Source: agent-workspaces/implementer/handoff.md (stack fix after Run 001)
Commands executed:
  source ~/esp/esp-idf/export.sh
  idf.py build
  idf.py -p /dev/ttyACM0 flash
  Serial capture 115200 / 12s after flash
Hardware used:
  ESP32-C3 SuperMini on /dev/ttyACM0 (USB-Serial/JTAG)
Result:
  Build: PASS
  Flash: PASS
  display_geometry_self_test on device: PASS
  Stable boot / display_task: PASS
  OLED physical output: PASS (SSD1306 via i2c_bus_transceive; see Run 004)
Reproducible failures:
  None in Run 002. Run 001 stack protection fault resolved.
Evidence:
  agent-workspaces/tester/test_runs.md Run 002, Run 004
  /tmp/b06_hil_boot_log_run002.txt
Recommendation:
  Accept display stack for boot/runtime. Visual demo validated at driver level in
  Run 004; human panel confirmation still recommended.
```

## Template

```text
Role boundary check:
  Confirm this work is tester-owned validation. Redirect code fixes to
  implementer and criteria or design changes to architect if mixed.
ID:
Source:
Commands executed:
Hardware used:
CONFIG_B00_BASEHIL_DISPLAY_VISUAL_DEMO: y | n
Visual demo steps (per manifest):
  Step 1 name= / Expected / Observed / PASS|FAIL|BLOCKED
  Step 2 ...
Result:
Reproducible failures:
Evidence:
  feedback.md entry:
  test_runs.md run:
Recommendation:
```
