galopago/misistemhil/(list of files, drawings)

Other design files:
b-hil-boards/b00_hil/b00_hil.dsn
b-hil-boards/b01_hil/b01_hil.dsn
b-hil-boards/b02_hil/b02.dsn
b-hil-boards/b03_hil/b02.dsn
b-hil-boards/b03_hil/b03.dsn
b-hil-boards/b05_hil/b02.dsn
b-hil-boards/b06_hil/pcb/b06.dsn
