galopago/misistemhil/b-hil-boards/b06_hil/pcb/b06.kicad_pcb

## KiCad design b-hil-boards/b06_hil/pcb/b06.kicad_pcb (2026-09-12)

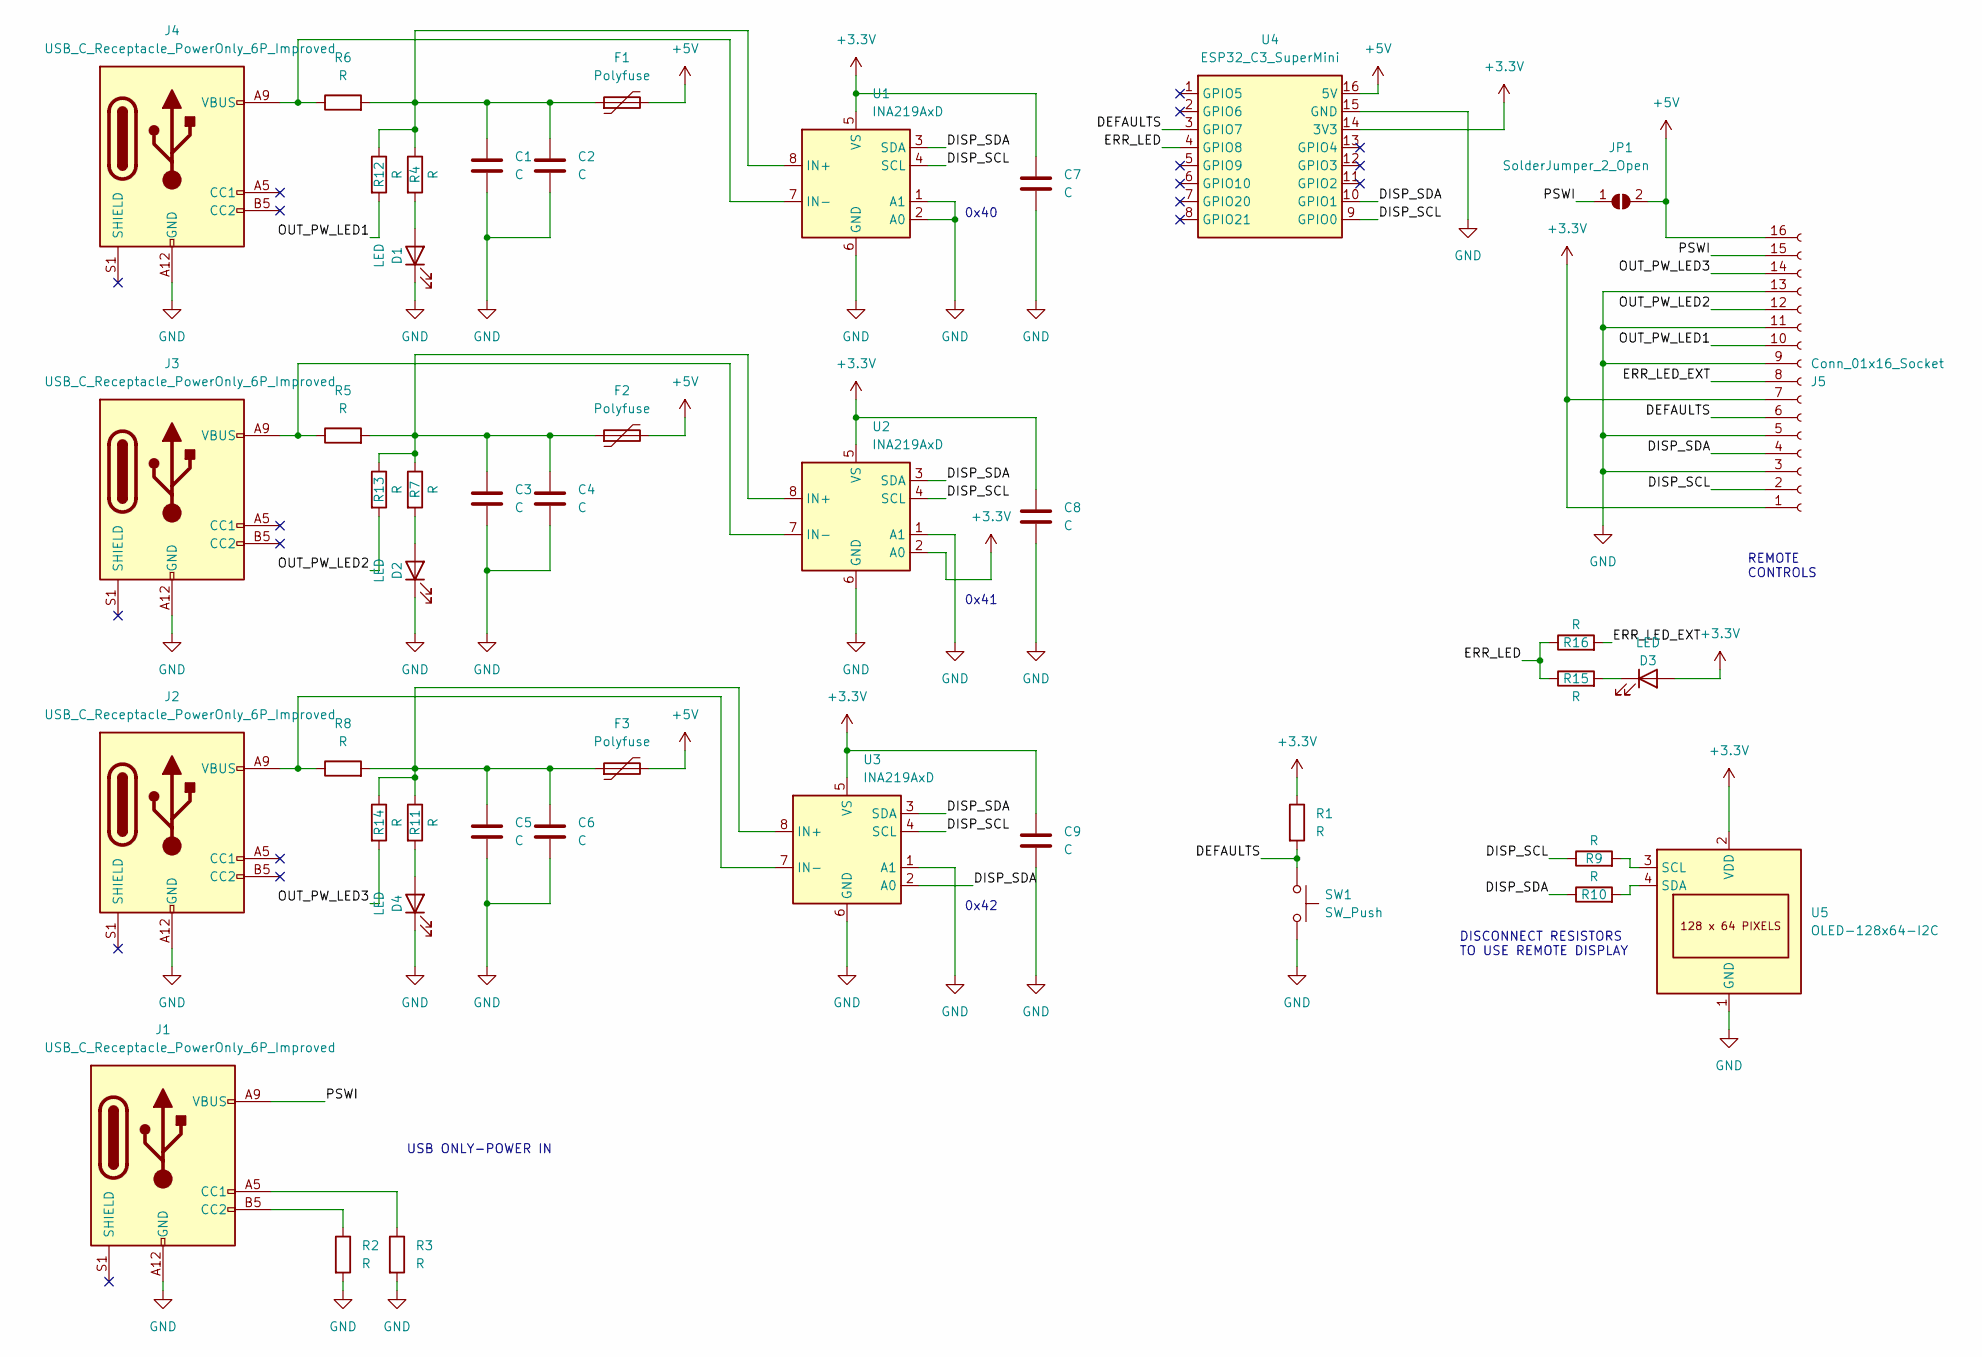
[picture p12: schematic b06.kicad_sch]

Parts:
C1, C3, C5: C; CP_Elec_8x10.5
C2, C4, C6, C7, C8, C9: C; C_0805_2012Metric_Pad1.18x1.45mm_HandSolder
D1, D2, D3, D4: LED; LED_0805_2012Metric_Pad1.15x1.40mm_HandSolder
F1, F2, F3: Polyfuse; Fuse_1206_3216Metric_Pad1.42x1.75mm_HandSolder
J1, J2, J3, J4: USB_C_Receptacle_PowerOnly_6P_Improved; USB_C_Receptacle_HRO_TYPE-C-31-M-12
J5: Conn_01x16_Socket; TerminalBlock_DoubleLevel_2x08_P3.50mm_Horizontal
JP1: SolderJumper_2_Open; SolderJumper-2_P1.3mm_Open_RoundedPad1.0x1.5mm
R1, R2, R3, R4, R7, R9, R10, R11, R12, R13, R14, R15, R16: R; R_0805_2012Metric_Pad1.20x1.40mm_HandSolder
R5, R6, R8: R; R_2512_6332Metric_Pad1.40x3.35mm_HandSolder
SW1: SW_Push; SW_Push_1P1T_NO_6x6mm_H9.5mm
U1, U2, U3: INA219AxD; SOIC-8_3.9x4.9mm_P1.27mm
U4: ESP32_C3_SuperMini; ESP32 C3 SuperMini
U5: OLED-128x64-I2C

Connections:
+3.3V: C7.1, C8.1, C9.1, D3.2 (A), J5.1, J5.7, R1.1, U1.5 (VS), U2.2 (A0), U2.5 (VS), U3.5 (VS), U4.14 (3V3), U5.2 (VDD)
+5V: F1.2, F2.2, F3.2, J5.16, JP1.2 (B), U4.16 (5V)
/DEFAULTS: J5.6, R1.2, SW1.1, U4.3 (GPIO7)
/DISP_SCL: J5.2, R9.1, U1.4 (SCL), U2.4 (SCL), U3.4 (SCL), U4.9 (GPIO0)
/DISP_SDA: J5.4, R10.1, U1.3 (SDA), U2.3 (SDA), U3.2 (A0), U3.3 (SDA), U4.10 (GPIO1)
/ERR_LED: R15.1, R16.1, U4.4 (GPIO8)
/ERR_LED_EXT: J5.8, R16.2
/OUT_PW_LED1: J5.10, R12.2
/OUT_PW_LED2: J5.12, R13.2
/OUT_PW_LED3: J5.14, R14.2
/PSWI: J1.A4 (VBUS), J1.A9 (VBUS), J1.B4 (VBUS), J1.B9 (VBUS), J5.15, JP1.1 (A)
GND: C1.2, C2.2, C3.2, C4.2, C5.2, C6.2, C7.2, C8.2, C9.2, D1.1 (K), D2.1 (K), D4.1 (K), J1.A1 (GND), J1.A12 (GND), J1.B1 (GND), J1.B12 (GND), J2.A1 (GND), J2.A12 (GND), J2.B1 (GND), J2.B12 (GND), J3.A1 (GND), J3.A12 (GND), J3.B1 (GND), J3.B12 (GND), J4.A1 (GND), J4.A12 (GND), J4.B1 (GND), J4.B12 (GND), J5.3, J5.5, J5.9, J5.11, J5.13, R2.2, R3.2, SW1.2, U1.1 (A1), U1.2 (A0), U1.6 (GND), U2.1 (A1), U2.6 (GND), U3.1 (A1), U3.6 (GND), U4.15 (GND), U5.1 (GND)
unnamed: D1.2 (A), R4.2
unnamed: D2.2 (A), R7.2
unnamed: D3.1 (K), R15.2
unnamed: D4.2 (A), R11.2
unnamed: J1.A5 (CC1), R3.1
unnamed: J1.B5 (CC2), R2.1
unnamed: C1.1, C2.1, F1.1, R4.1, R6.2, R12.1, U1.8 (IN+)
unnamed: J4.A4 (VBUS), J4.A9 (VBUS), J4.B4 (VBUS), J4.B9 (VBUS), R6.1, U1.7 (IN-)
unnamed: C3.1, C4.1, F2.1, R5.2, R7.1, R13.1, U2.8 (IN+)
unnamed: J3.A4 (VBUS), J3.A9 (VBUS), J3.B4 (VBUS), J3.B9 (VBUS), R5.1, U2.7 (IN-)
unnamed: C5.1, C6.1, F3.1, R8.2, R11.1, R14.1, U3.8 (IN+)
unnamed: J2.A4 (VBUS), J2.A9 (VBUS), J2.B4 (VBUS), J2.B9 (VBUS), R8.1, U3.7 (IN-)
unnamed: R9.2, U5.3 (SCL)
unnamed: R10.2, U5.4 (SDA)

Notes on the sheet:
0x41
0x42
REMOTE CONTROLS
0x40
DISCONNECT RESISTORS TO USE REMOTE DISPLAY
USB ONLY-POWER IN

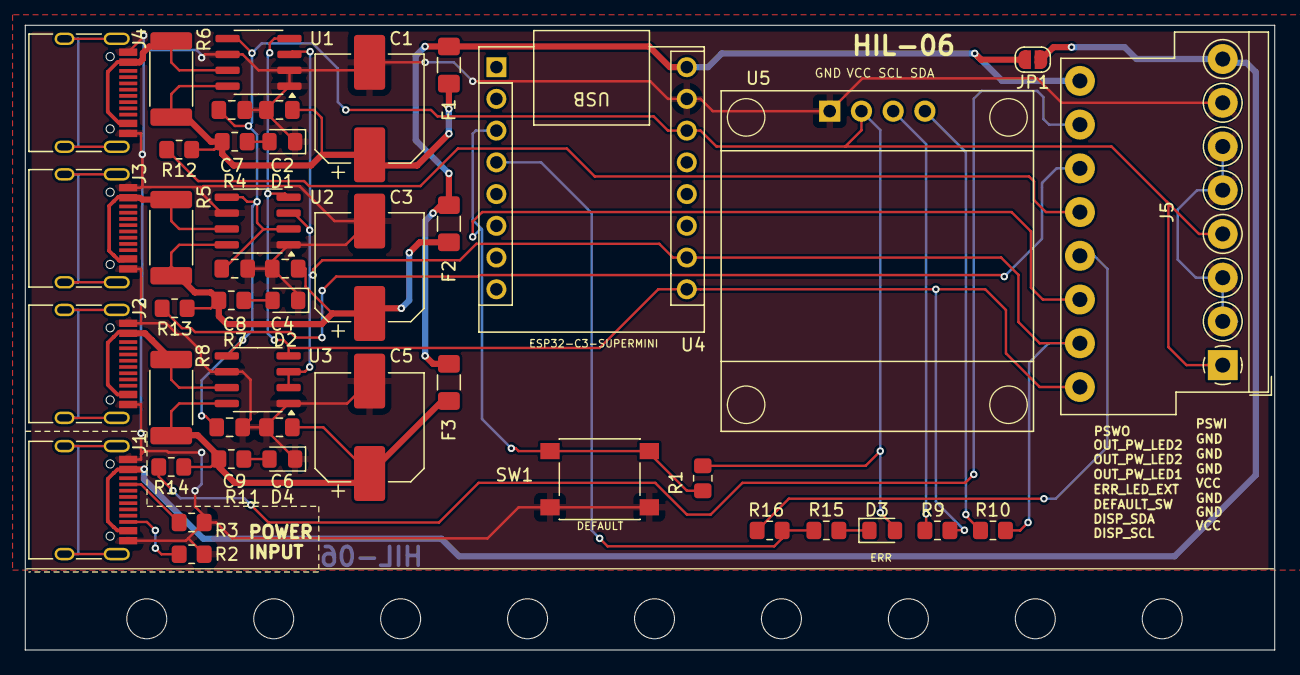
[picture p13: board b06.kicad_pcb from above]

Board: 2 copper layers, 100.0 x 50.0 mm, 53 parts (0 on the bottom side), 26 nets.

Other parts of the board:
MH01, MH02, MH03, MH04, MH05, MH06, MH07, MH08, MH09: MountingHole_3.2mm_M3
