galopago/misistemhil/b-hil-boards/b02_hil/b02.kicad_pcb

## KiCad design b-hil-boards/b02_hil/b02.kicad_pcb (2026-05-25)

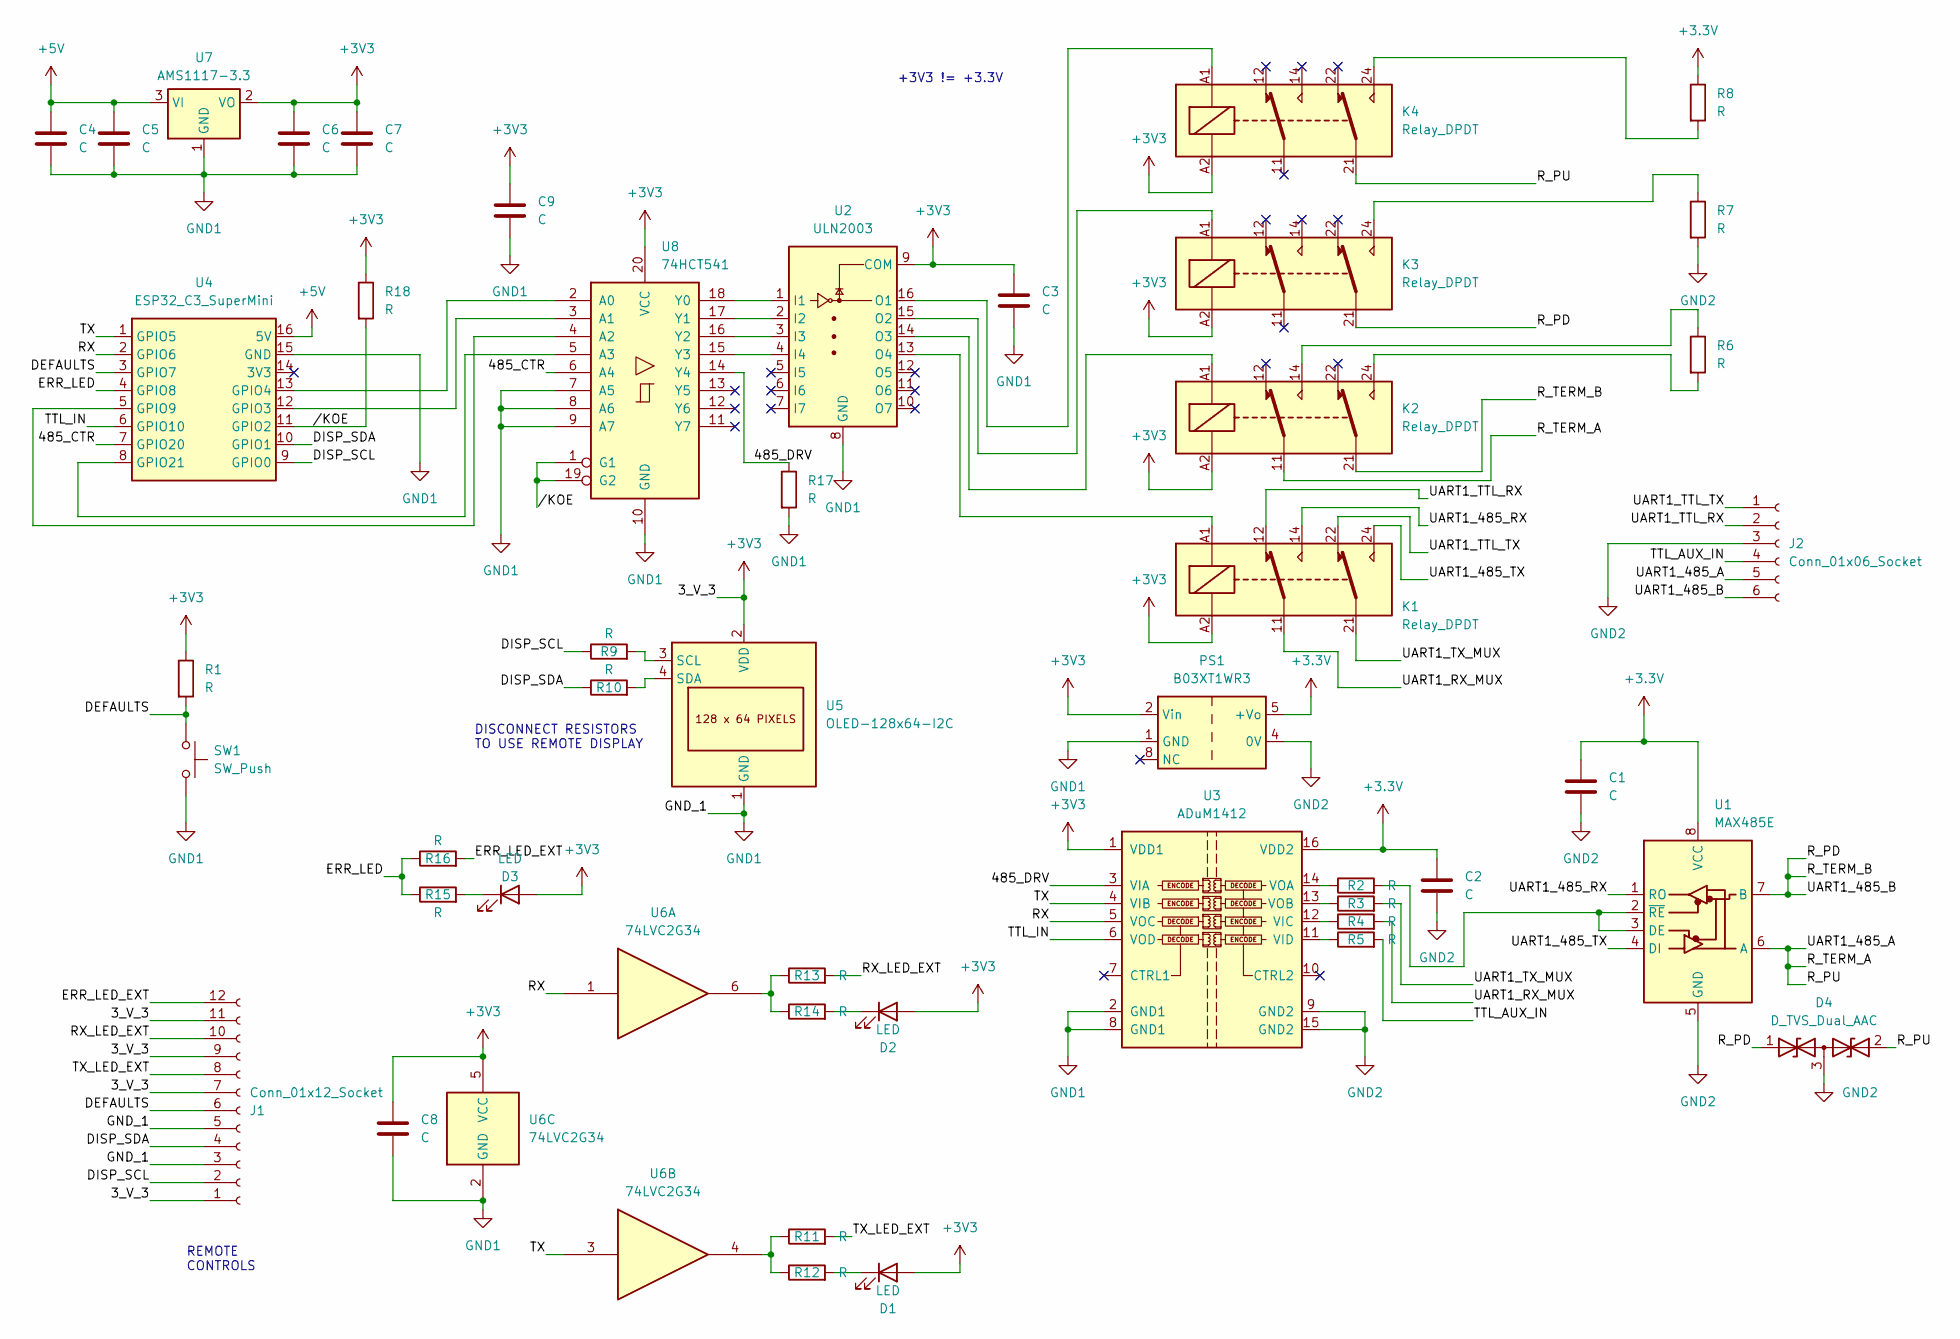
[picture p14: schematic b02.kicad_sch]

Parts:
C1, C2, C3, C4, C5, C6, C7, C8, C9: C; C_0805_2012Metric_Pad1.18x1.45mm_HandSolder
D1, D2, D3: LED; LED_0805_2012Metric_Pad1.15x1.40mm_HandSolder
D4: D_TVS_Dual_AAC; SOT-23-3
J1: Conn_01x12_Socket; TerminalBlock_DoubleLevel_2x06_P3.50mm_Horizontal
J2: Conn_01x06_Socket; TerminalBlock_DoubleLevel_2x03_P3.50mm_Horizontal
K1, K2, K3, K4: Relay_DPDT; Relay_DPDT_Omron_G6K-2F-Y
PS1: B03XT1WR3; Converter_DCDC_Mornsun_B03_XT_1WR3_SMD
R1, R2, R3, R4, R5, R6, R7, R8, R9, R10, R11, R12, R13, R14, R15, R16, R17, R18: R; R_0805_2012Metric_Pad1.20x1.40mm_HandSolder
SW1: SW_Push; SW_Push_1P1T_NO_6x6mm_H9.5mm
U1: MAX485E; SOIC-8_3.9x4.9mm_P1.27mm
U2: ULN2003; SOIC-16_3.9x9.9mm_P1.27mm
U3: ADuM1412; SOIC-16W_7.5x10.3mm_P1.27mm
U4: ESP32_C3_SuperMini; ESP32 C3 SuperMini
U5: OLED-128x64-I2C
U6: 74LVC2G34; SOT-23-6_Handsoldering
U7: AMS1117-3.3; SOT-223-3_TabPin2
U8: 74HCT541; TSSOP-20_4.4x6.5mm_P0.65mm

Connections:
+3.3V: C1.1, C2.1, PS1.5 (+Vo), R8.1, U1.8 (VCC), U3.16 (VDD2)
+3V3: C3.1, C6.1, C7.1, C8.1, C9.1, D1.2 (A), D2.2 (A), D3.2 (A), J1.1, J1.7, J1.9, J1.11, K1.A2, K2.A2, K3.A2, K4.A2, PS1.2 (Vin), R1.1, R18.1, U2.9 (COM), U3.1 (VDD1), U5.2 (VDD), U6.5 (VCC), U7.2 (VO), U8.20 (VCC)
+5V: C4.1, C5.1, U4.16 (5V), U7.3 (VI)
/485_CTR: U4.7 (GPIO20), U8.6 (A4)
/485_DRV: R17.1, U3.3 (VIA), U8.14 (Y4)
/DEFAULTS: J1.6, R1.2, SW1.1, U4.3 (GPIO7)
/DISP_SCL: J1.2, R9.1, U4.9 (GPIO0)
/DISP_SDA: J1.4, R10.1, U4.10 (GPIO1)
/ERR_LED: R15.1, R16.1, U4.4 (GPIO8)
/ERR_LED_EXT: J1.12, R16.2
/RX: U3.5 (VOC), U4.2 (GPIO6), U6.1
/RX_LED_EXT: J1.10, R13.2
/R_PD: D4.1 (A1), J2.6, K2.21, K3.21, U1.7 (B)
/R_PU: D4.2 (A2), J2.5, K2.11, K4.21, U1.6 (A)
/TTL_AUX_IN: J2.4, R5.2
/TTL_IN: U3.6 (VOD), U4.6 (GPIO10)
/TX: U3.4 (VIB), U4.1 (GPIO5), U6.3
/TX_LED_EXT: J1.8, R11.2
/UART1_485_RX: K1.14, U1.1 (RO)
/UART1_485_TX: K1.24, U1.4 (DI)
/UART1_RX_MUX: K1.11, R4.2
/UART1_TTL_RX: J2.2, K1.12
/UART1_TTL_TX: J2.1, K1.22
/UART1_TX_MUX: K1.21, R3.2
//KOE: R18.2, U4.11 (GPIO2), U8.1 (G1), U8.19 (G2)
GND1: C3.2, C4.2, C5.2, C6.2, C7.2, C8.2, C9.2, J1.3, J1.5, PS1.1 (GND), R17.2, SW1.2, U2.8 (GND), U3.2 (GND1), U3.8 (GND1), U4.15 (GND), U5.1 (GND), U6.2 (GND), U7.1 (GND), U8.7 (A5), U8.8 (A6), U8.9 (A7), U8.10 (GND)
GND2: C1.2, C2.2, D4.3 (common), J2.3, PS1.4 (0V), R7.2, U1.5 (GND), U3.9 (GND2), U3.15 (GND2)
unnamed: D1.1 (K), R12.2
unnamed: D2.1 (K), R14.2
unnamed: D3.1 (K), R15.2
unnamed: K2.14, R6.1
unnamed: K2.24, R6.2
unnamed: K3.24, R7.1
unnamed: K4.24, R8.2
unnamed: R11.1, R12.1, U6.4
unnamed: R13.1, R14.1, U6.6
unnamed: R2.2, U1.2 (~RE), U1.3 (DE)
unnamed: U2.1 (I1), U8.18 (Y0)
unnamed: U2.2 (I2), U8.17 (Y1)
unnamed: U2.3 (I3), U8.16 (Y2)
unnamed: U2.4 (I4), U8.15 (Y3)
unnamed: K4.A1, U2.16 (O1)
unnamed: K3.A1, U2.15 (O2)
unnamed: K2.A1, U2.14 (O3)
unnamed: K1.A1, U2.13 (O4)
unnamed: R4.1, U3.12 (VIC)
unnamed: R5.1, U3.11 (VID)
unnamed: R2.1, U3.14 (VOA)
unnamed: R3.1, U3.13 (VOB)
unnamed: U4.12 (GPIO3), U8.3 (A1)
unnamed: U4.13 (GPIO4), U8.2 (A0)
unnamed: U4.5 (GPIO9), U8.4 (A2)
unnamed: U4.8 (GPIO21), U8.5 (A3)
unnamed: R9.2, U5.3 (SCL)
unnamed: R10.2, U5.4 (SDA)

Notes on the sheet:
+3V3 != +3.3V
REMOTE CONTROLS
DISCONNECT RESISTORS TO USE REMOTE DISPLAY

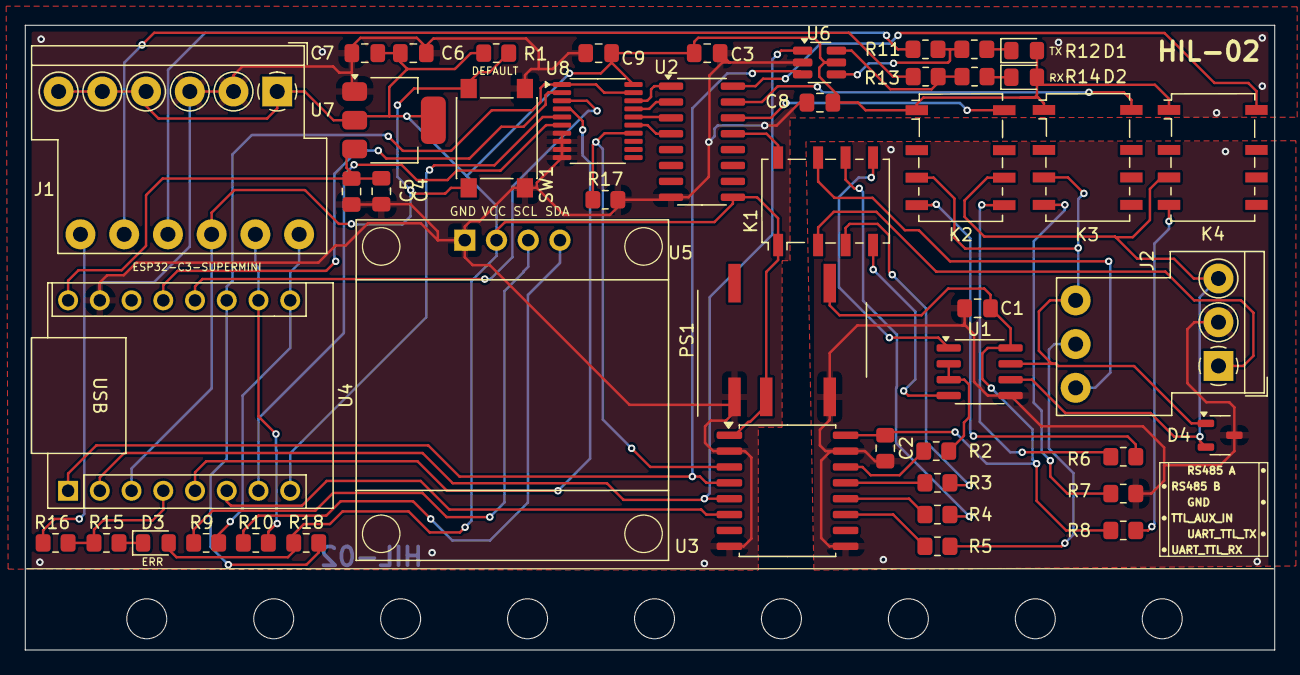
[picture p15: board b02.kicad_pcb from above]

Board: 2 copper layers, 100.0 x 50.0 mm, 56 parts (0 on the bottom side), 55 nets.

Other parts of the board:
MH01, MH02, MH03, MH04, MH05, MH06, MH07, MH08, MH09: MountingHole_3.2mm_M3
