galopago/misistemhil/b-hil-boards/b03_hil/b03.kicad_pcb

## KiCad design b-hil-boards/b03_hil/b03.kicad_pcb (2026-05-22)

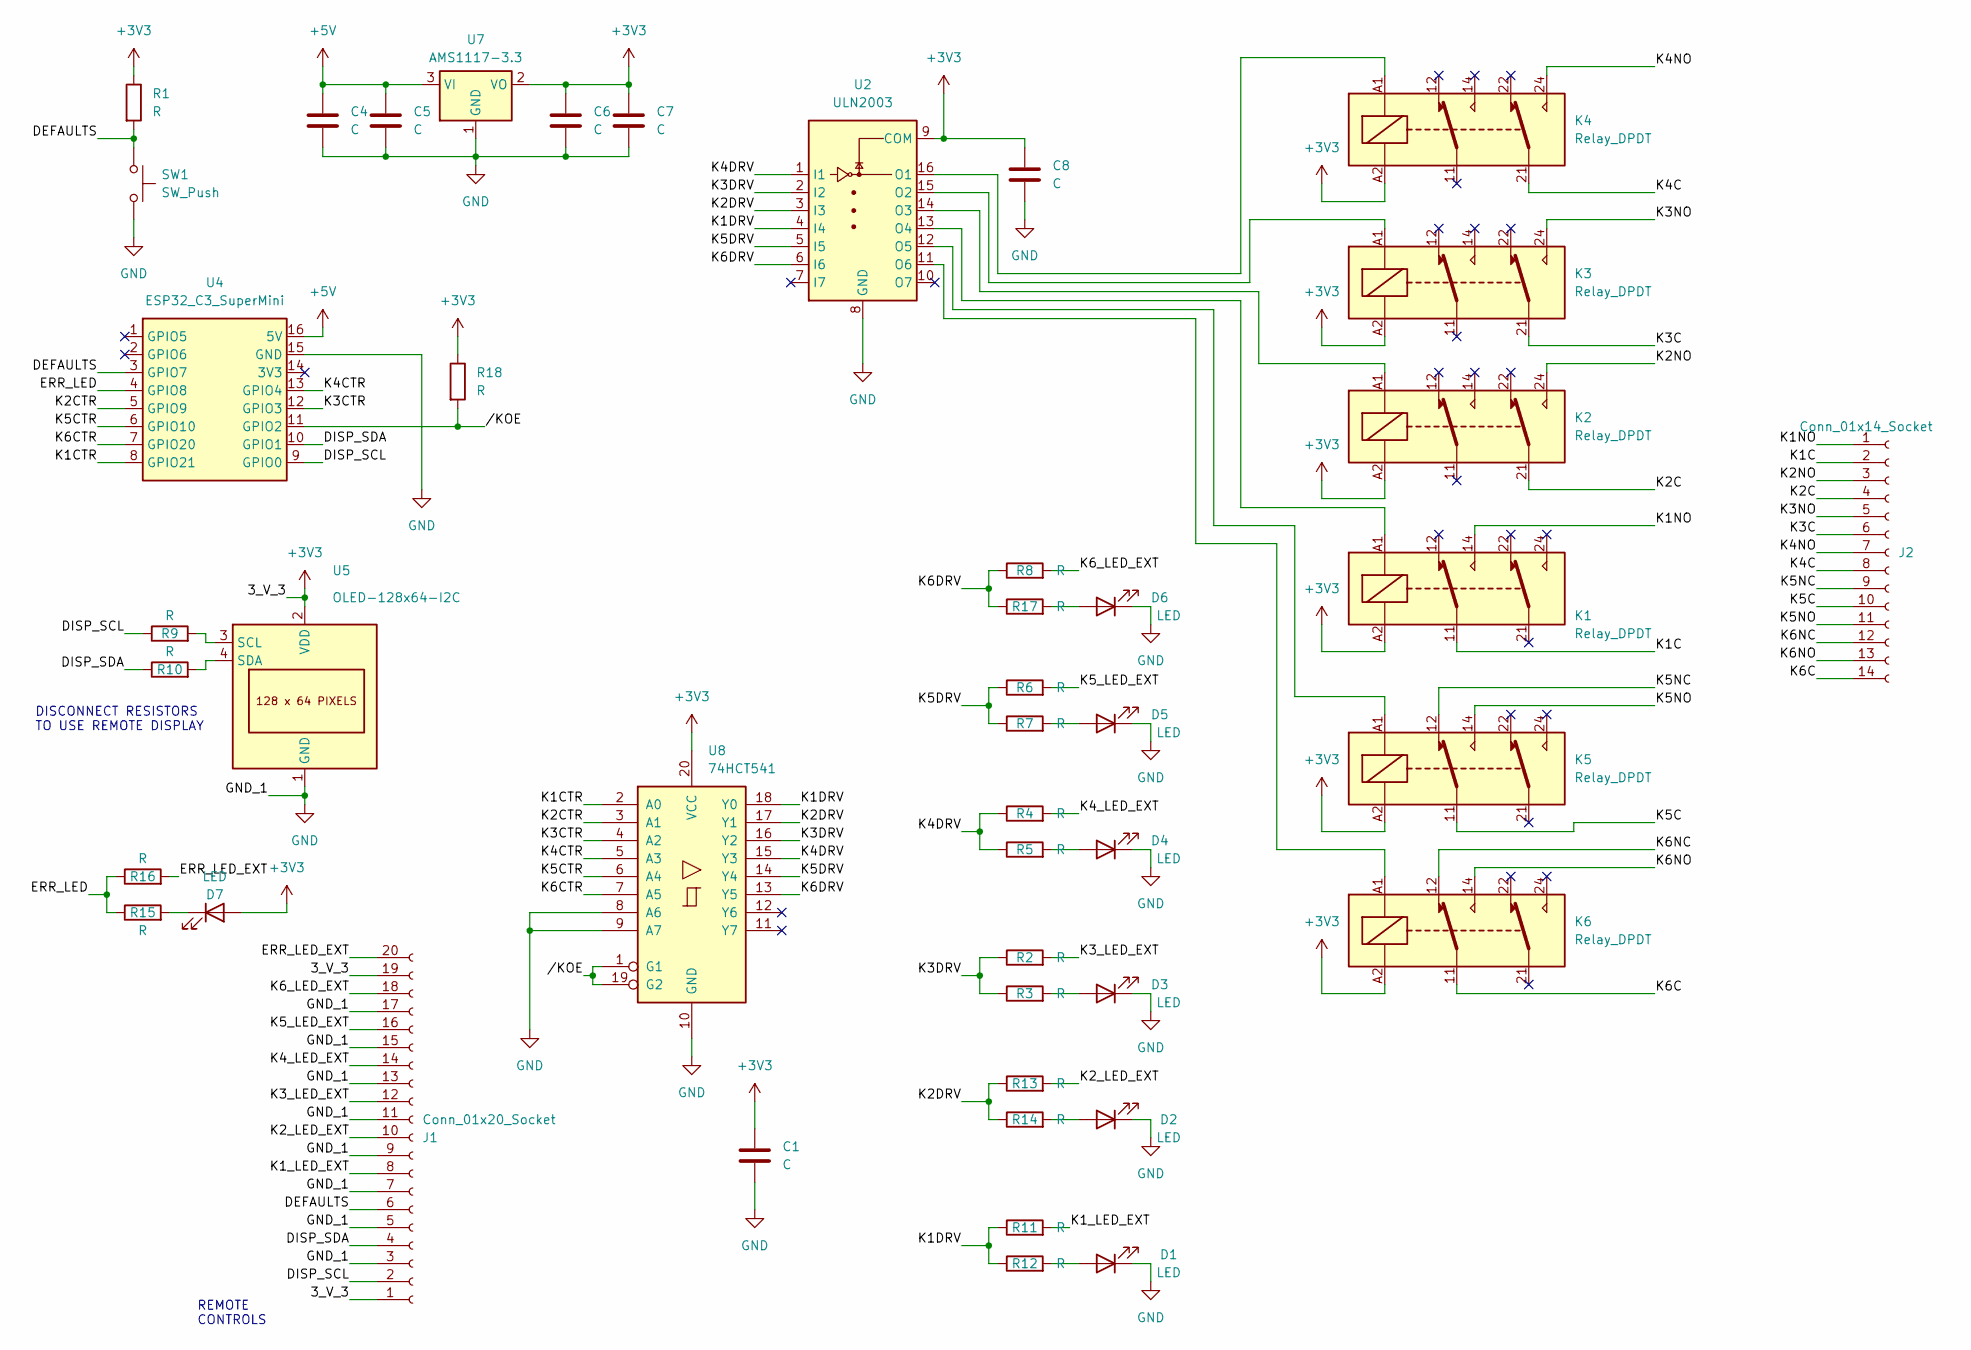
[picture p16: schematic b03.kicad_sch, HIL-03]

Parts:
C1, C4, C5, C6, C7, C8: C; C_0805_2012Metric_Pad1.18x1.45mm_HandSolder
D1, D2, D3, D4, D5, D6, D7: LED; LED_0805_2012Metric_Pad1.15x1.40mm_HandSolder
J1: Conn_01x20_Socket; TerminalBlock_DoubleLevel_2x10_P3.50mm_Horizontal
J2: Conn_01x14_Socket; TerminalBlock_DoubleLevel_2x07_P3.50mm_Horizontal
K1, K2, K3, K4, K5, K6: Relay_DPDT; Relay_DPDT_Omron_G6K-2F-Y
R1, R2, R3, R4, R5, R6, R7, R8, R9, R10, R11, R12, R13, R14, R15, R16, R17, R18: R; R_0805_2012Metric_Pad1.20x1.40mm_HandSolder
SW1: SW_Push; SW_Push_1P1T_NO_6x6mm_H9.5mm
U2: ULN2003; SOIC-16_3.9x9.9mm_P1.27mm
U4: ESP32_C3_SuperMini; ESP32 C3 SuperMini
U5: OLED-128x64-I2C
U7: AMS1117-3.3; SOT-223-3_TabPin2
U8: 74HCT541; TSSOP-20_4.4x6.5mm_P0.65mm

Connections:
+3V3: C1.1, C6.1, C7.1, C8.1, D7.2 (A), J1.1, J1.19, K1.A2, K2.A2, K3.A2, K4.A2, K5.A2, K6.A2, R1.1, R18.1, U2.9 (COM), U5.2 (VDD), U7.2 (VO), U8.20 (VCC)
+5V: C4.1, C5.1, U4.16 (5V), U7.3 (VI)
/DEFAULTS: J1.6, R1.2, SW1.1, U4.3 (GPIO7)
/DISP_SCL: J1.2, R9.1, U4.9 (GPIO0)
/DISP_SDA: J1.4, R10.1, U4.10 (GPIO1)
/ERR_LED: R15.1, R16.1, U4.4 (GPIO8)
/ERR_LED_EXT: J1.20, R16.2
/K1C: J2.2, K1.11
/K1CTR: U4.8 (GPIO21), U8.2 (A0)
/K1DRV: R11.1, R12.1, U2.4 (I4), U8.18 (Y0)
/K1NO: J2.1, K1.14
/K1_LED_EXT: J1.8, R11.2
/K2C: J2.4, K2.21
/K2CTR: U4.5 (GPIO9), U8.3 (A1)
/K2DRV: R13.1, R14.1, U2.3 (I3), U8.17 (Y1)
/K2NO: J2.3, K2.24
/K2_LED_EXT: J1.10, R13.2
/K3C: J2.6, K3.21
/K3CTR: U4.12 (GPIO3), U8.4 (A2)
/K3DRV: R2.1, R3.1, U2.2 (I2), U8.16 (Y2)
/K3NO: J2.5, K3.24
/K3_LED_EXT: J1.12, R2.2
/K4C: J2.8, K4.21
/K4CTR: U4.13 (GPIO4), U8.5 (A3)
/K4DRV: R4.1, R5.1, U2.1 (I1), U8.15 (Y3)
/K4NO: J2.7, K4.24
/K4_LED_EXT: J1.14, R4.2
/K5C: J2.10, K5.11
/K5CTR: U4.6 (GPIO10), U8.6 (A4)
/K5DRV: R6.1, R7.1, U2.5 (I5), U8.14 (Y4)
/K5NC: J2.9, K5.12
/K5NO: J2.11, K5.14
/K5_LED_EXT: J1.16, R6.2
/K6C: J2.14, K6.11
/K6CTR: U4.7 (GPIO20), U8.7 (A5)
/K6DRV: R8.1, R17.1, U2.6 (I6), U8.13 (Y5)
/K6NC: J2.12, K6.12
/K6NO: J2.13, K6.14
/K6_LED_EXT: J1.18, R8.2
//KOE: R18.2, U4.11 (GPIO2), U8.1 (G1), U8.19 (G2)
GND: C1.2, C4.2, C5.2, C6.2, C7.2, C8.2, D1.1 (K), D2.1 (K), D3.1 (K), D4.1 (K), D5.1 (K), D6.1 (K), J1.3, J1.5, J1.7, J1.9, J1.11, J1.13, J1.15, J1.17, SW1.2, U2.8 (GND), U4.15 (GND), U5.1 (GND), U7.1 (GND), U8.8 (A6), U8.9 (A7), U8.10 (GND)
unnamed: D1.2 (A), R12.2
unnamed: D2.2 (A), R14.2
unnamed: D3.2 (A), R3.2
unnamed: D4.2 (A), R5.2
unnamed: D5.2 (A), R7.2
unnamed: D6.2 (A), R17.2
unnamed: D7.1 (K), R15.2
unnamed: K4.A1, U2.16 (O1)
unnamed: K3.A1, U2.15 (O2)
unnamed: K2.A1, U2.14 (O3)
unnamed: K1.A1, U2.13 (O4)
unnamed: K5.A1, U2.12 (O5)
unnamed: K6.A1, U2.11 (O6)
unnamed: R9.2, U5.3 (SCL)
unnamed: R10.2, U5.4 (SDA)

Notes on the sheet:
REMOTE CONTROLS
DISCONNECT RESISTORS TO USE REMOTE DISPLAY

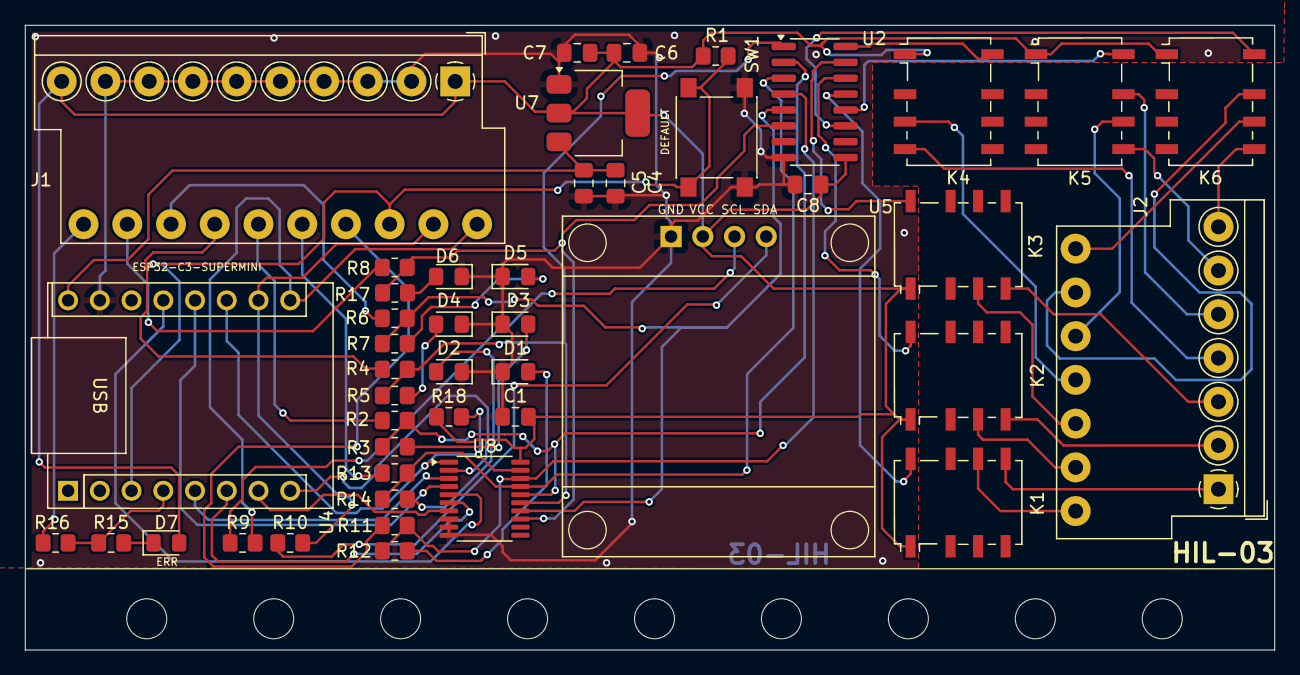
[picture p17: board b03.kicad_pcb from above]

Board: 2 copper layers, 100.0 x 50.0 mm, 54 parts (0 on the bottom side), 56 nets.

Other parts of the board:
MH01, MH02, MH03, MH04, MH05, MH06, MH07, MH08, MH09: MountingHole_3.2mm_M3
