galopago/misistemhil/b-hil-boards/b05_hil/b05.kicad_pcb

## KiCad design b-hil-boards/b05_hil/b05.kicad_pcb (2026-05-13)

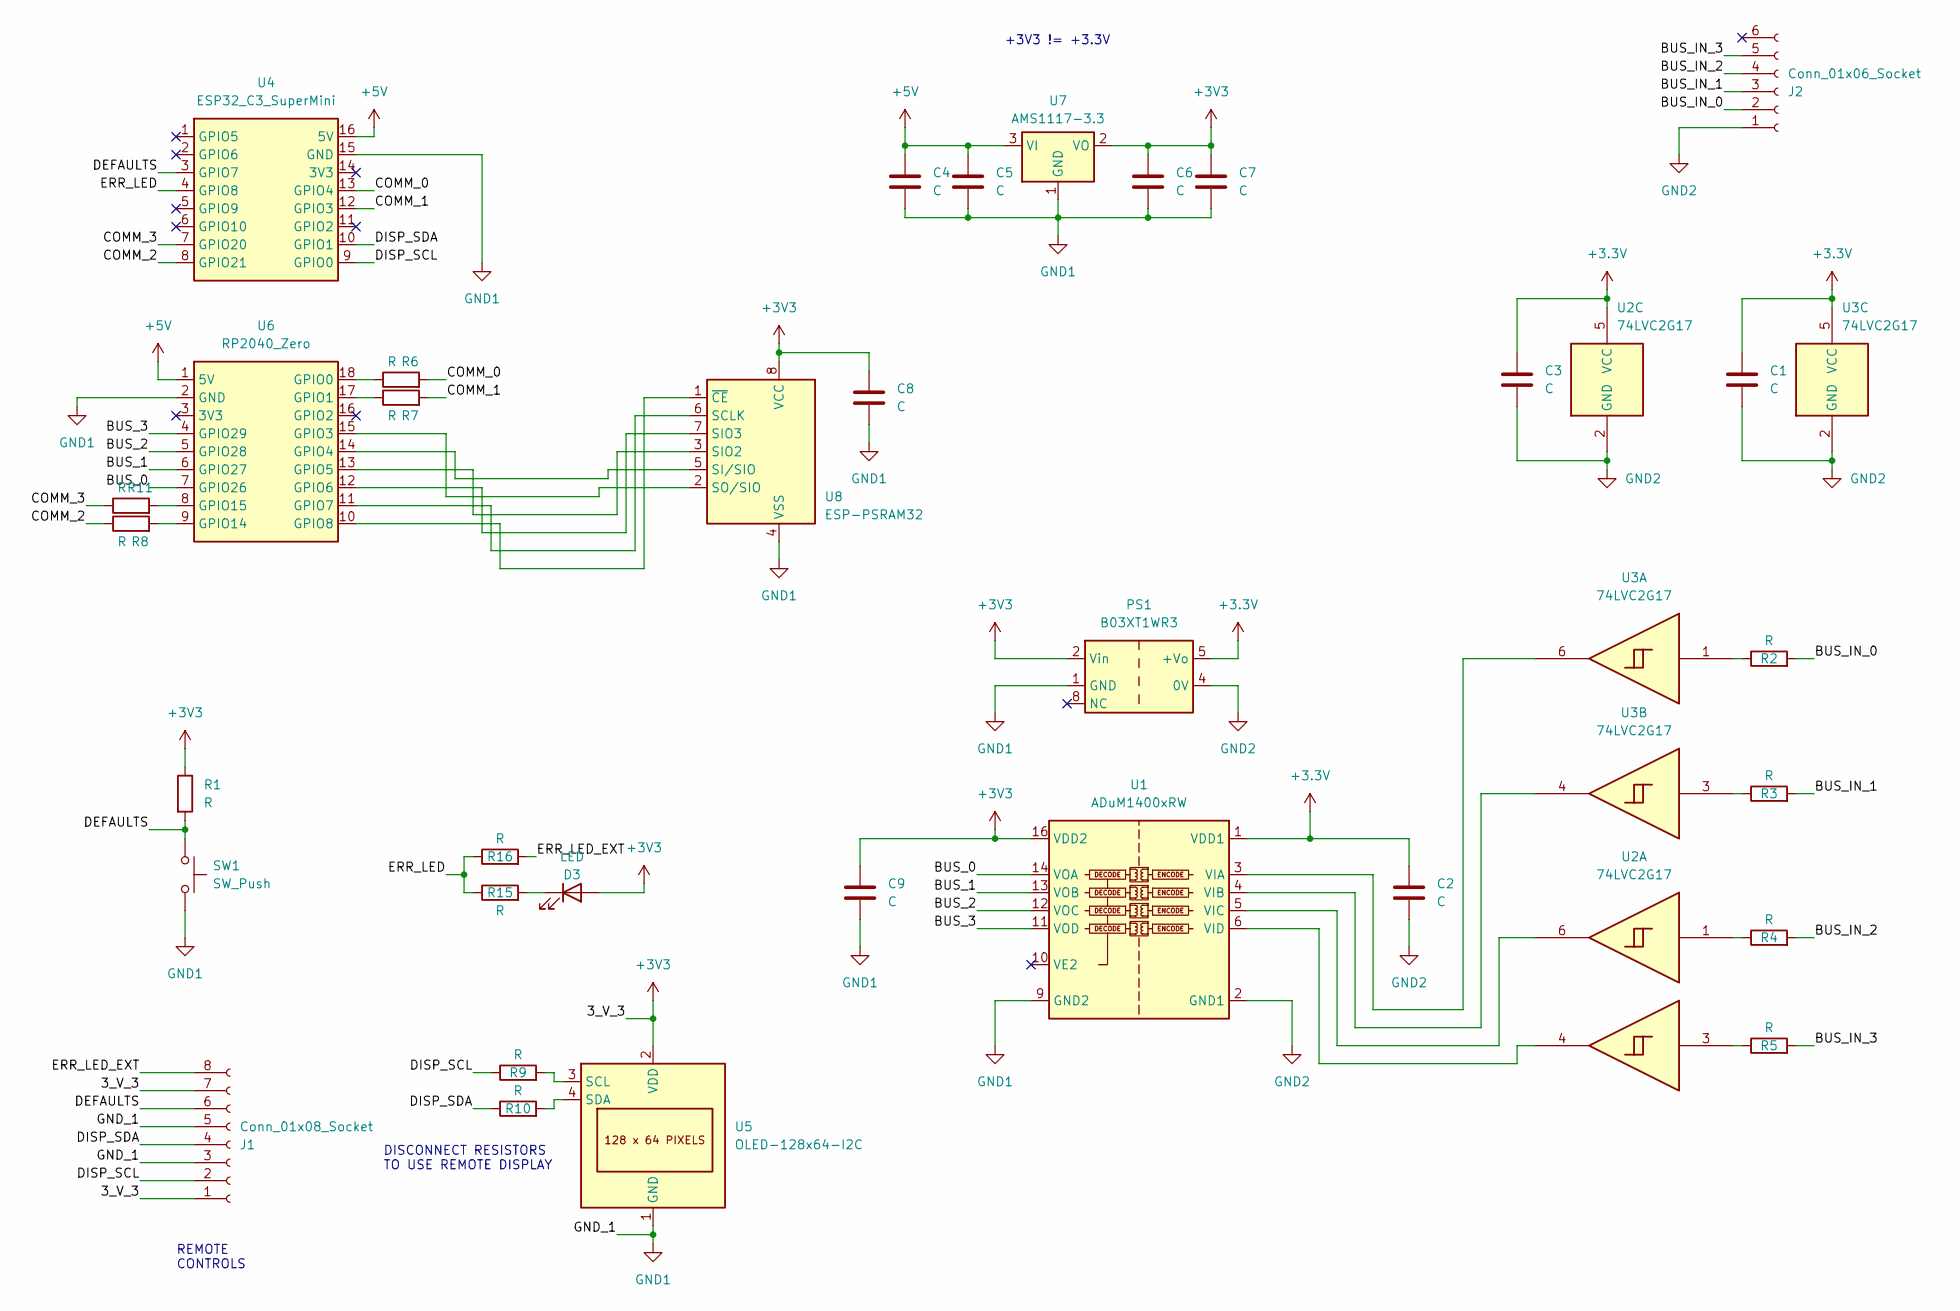
[picture p18: schematic b05.kicad_sch]

Parts:
C1, C2, C3, C4, C5, C6, C7, C8, C9: C; C_0805_2012Metric_Pad1.18x1.45mm_HandSolder
D3: LED; LED_0805_2012Metric_Pad1.15x1.40mm_HandSolder
J1: Conn_01x08_Socket; TerminalBlock_DoubleLevel_2x04_P3.50mm_Horizontal
J2: Conn_01x06_Socket; TerminalBlock_DoubleLevel_2x03_P3.50mm_Horizontal
PS1: B03XT1WR3; Converter_DCDC_Mornsun_B03_XT_1WR3_SMD
R1, R2, R3, R4, R5, R6, R7, R8, R9, R10, R11, R15, R16: R; R_0805_2012Metric_Pad1.20x1.40mm_HandSolder
SW1: SW_Push; SW_Push_1P1T_NO_6x6mm_H9.5mm
U1: ADuM1400xRW; SOIC-16W_7.5x10.3mm_P1.27mm
U2, U3: 74LVC2G17; SOT-23-6_Handsoldering
U4: ESP32_C3_SuperMini; ESP32 C3 SuperMini
U5: OLED-128x64-I2C
U6: RP2040_Zero; RP2040 Zero
U7: AMS1117-3.3; SOT-223-3_TabPin2
U8: ESP-PSRAM32; SOIC-8_3.9x4.9mm_P1.27mm

Connections:
+3.3V: C1.1, C2.1, C3.1, PS1.5 (+Vo), U1.1 (VDD1), U2.5 (VCC), U3.5 (VCC)
+3V3: C6.1, C7.1, C8.1, C9.1, D3.2 (A), J1.1, J1.7, PS1.2 (Vin), R1.1, U1.16 (VDD2), U5.2 (VDD), U7.2 (VO), U8.8 (VCC)
+5V: C4.1, C5.1, U4.16 (5V), U6.1 (5V), U7.3 (VI)
/BUS_0: U1.14 (VOA), U6.7 (GPIO26)
/BUS_1: U1.13 (VOB), U6.6 (GPIO27)
/BUS_2: U1.12 (VOC), U6.5 (GPIO28)
/BUS_3: U1.11 (VOD), U6.4 (GPIO29)
/BUS_IN_0: J2.2, R2.2
/BUS_IN_1: J2.3, R3.2
/BUS_IN_2: J2.4, R4.2
/BUS_IN_3: J2.5, R5.2
/COMM_0: R6.2, U4.13 (GPIO4)
/COMM_1: R7.2, U4.12 (GPIO3)
/COMM_2: R8.1, U4.8 (GPIO21)
/COMM_3: R11.1, U4.7 (GPIO20)
/DEFAULTS: J1.6, R1.2, SW1.1, U4.3 (GPIO7)
/DISP_SCL: J1.2, R9.1, U4.9 (GPIO0)
/DISP_SDA: J1.4, R10.1, U4.10 (GPIO1)
/ERR_LED: R15.1, R16.1, U4.4 (GPIO8)
/ERR_LED_EXT: J1.8, R16.2
GND1: C4.2, C5.2, C6.2, C7.2, C8.2, C9.2, J1.3, J1.5, PS1.1 (GND), SW1.2, U1.9 (GND2), U1.15 (GND2), U4.15 (GND), U5.1 (GND), U6.2 (GND), U7.1 (GND), U8.4 (VSS)
GND2: C1.2, C2.2, C3.2, J2.1, PS1.4 (0V), U1.2 (GND1), U1.8 (GND1), U2.2 (GND), U3.2 (GND)
unnamed: D3.1 (K), R15.2
unnamed: R2.1, U3.1
unnamed: R3.1, U3.3
unnamed: R4.1, U2.1
unnamed: R5.1, U2.3
unnamed: U1.3 (VIA), U3.6
unnamed: U1.4 (VIB), U3.4
unnamed: U1.5 (VIC), U2.6
unnamed: U1.6 (VID), U2.4
unnamed: R9.2, U5.3 (SCL)
unnamed: R10.2, U5.4 (SDA)
unnamed: R6.1, U6.18 (GPIO0)
unnamed: R7.1, U6.17 (GPIO1)
unnamed: U6.15 (GPIO3), U8.2 (SO/SIO)
unnamed: U6.14 (GPIO4), U8.5 (SI/SIO)
unnamed: U6.13 (GPIO5), U8.3 (SIO2)
unnamed: U6.12 (GPIO6), U8.7 (SIO3)
unnamed: U6.11 (GPIO7), U8.6 (SCLK)
unnamed: U6.10 (GPIO8), U8.1 (~CE)
unnamed: R8.2, U6.9 (GPIO14)
unnamed: R11.2, U6.8 (GPIO15)

Notes on the sheet:
+3V3 != +3.3V
REMOTE CONTROLS
DISCONNECT RESISTORS TO USE REMOTE DISPLAY

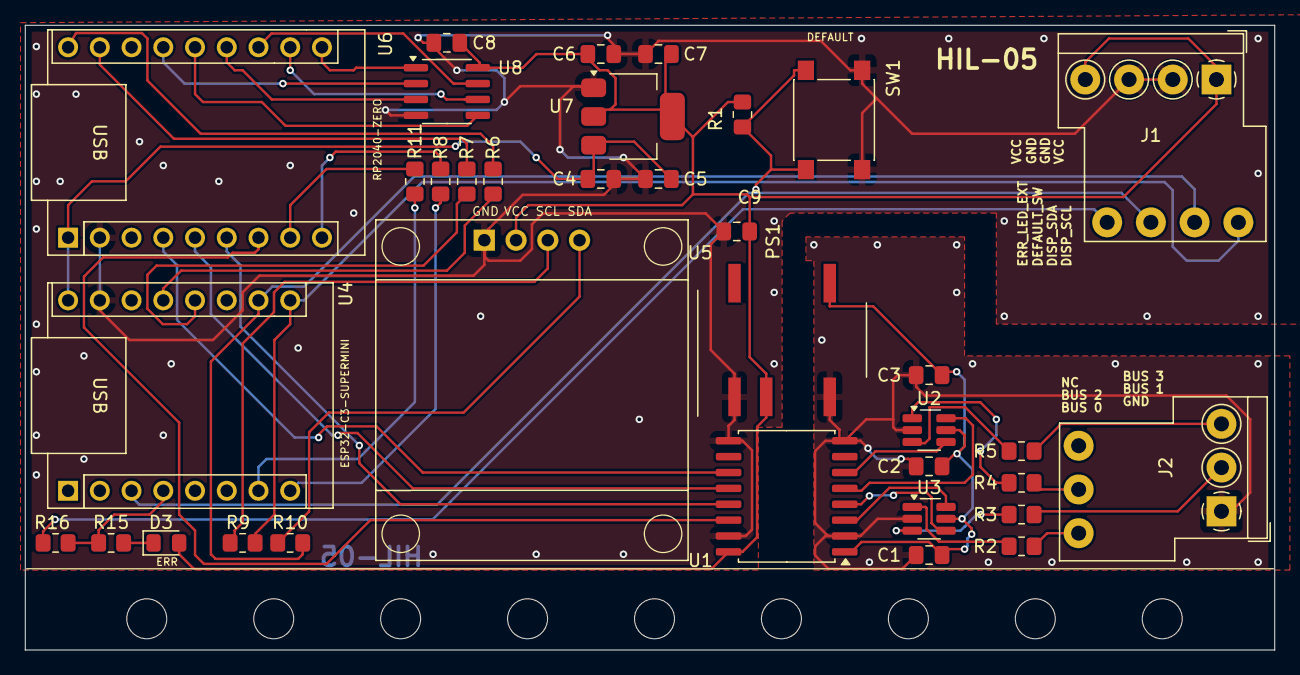
[picture p19: board b05.kicad_pcb from above]

Board: 2 copper layers, 100.0 x 50.0 mm, 44 parts (0 on the bottom side), 43 nets.

Other parts of the board:
MH01, MH02, MH03, MH04, MH05, MH06, MH07, MH08, MH09: MountingHole_3.2mm_M3
