galopago/misistemhil/b-hil-boards/b01_hil/b01_hil.kicad_pcb

## KiCad design b-hil-boards/b01_hil/b01_hil.kicad_pcb (2024-10-27)

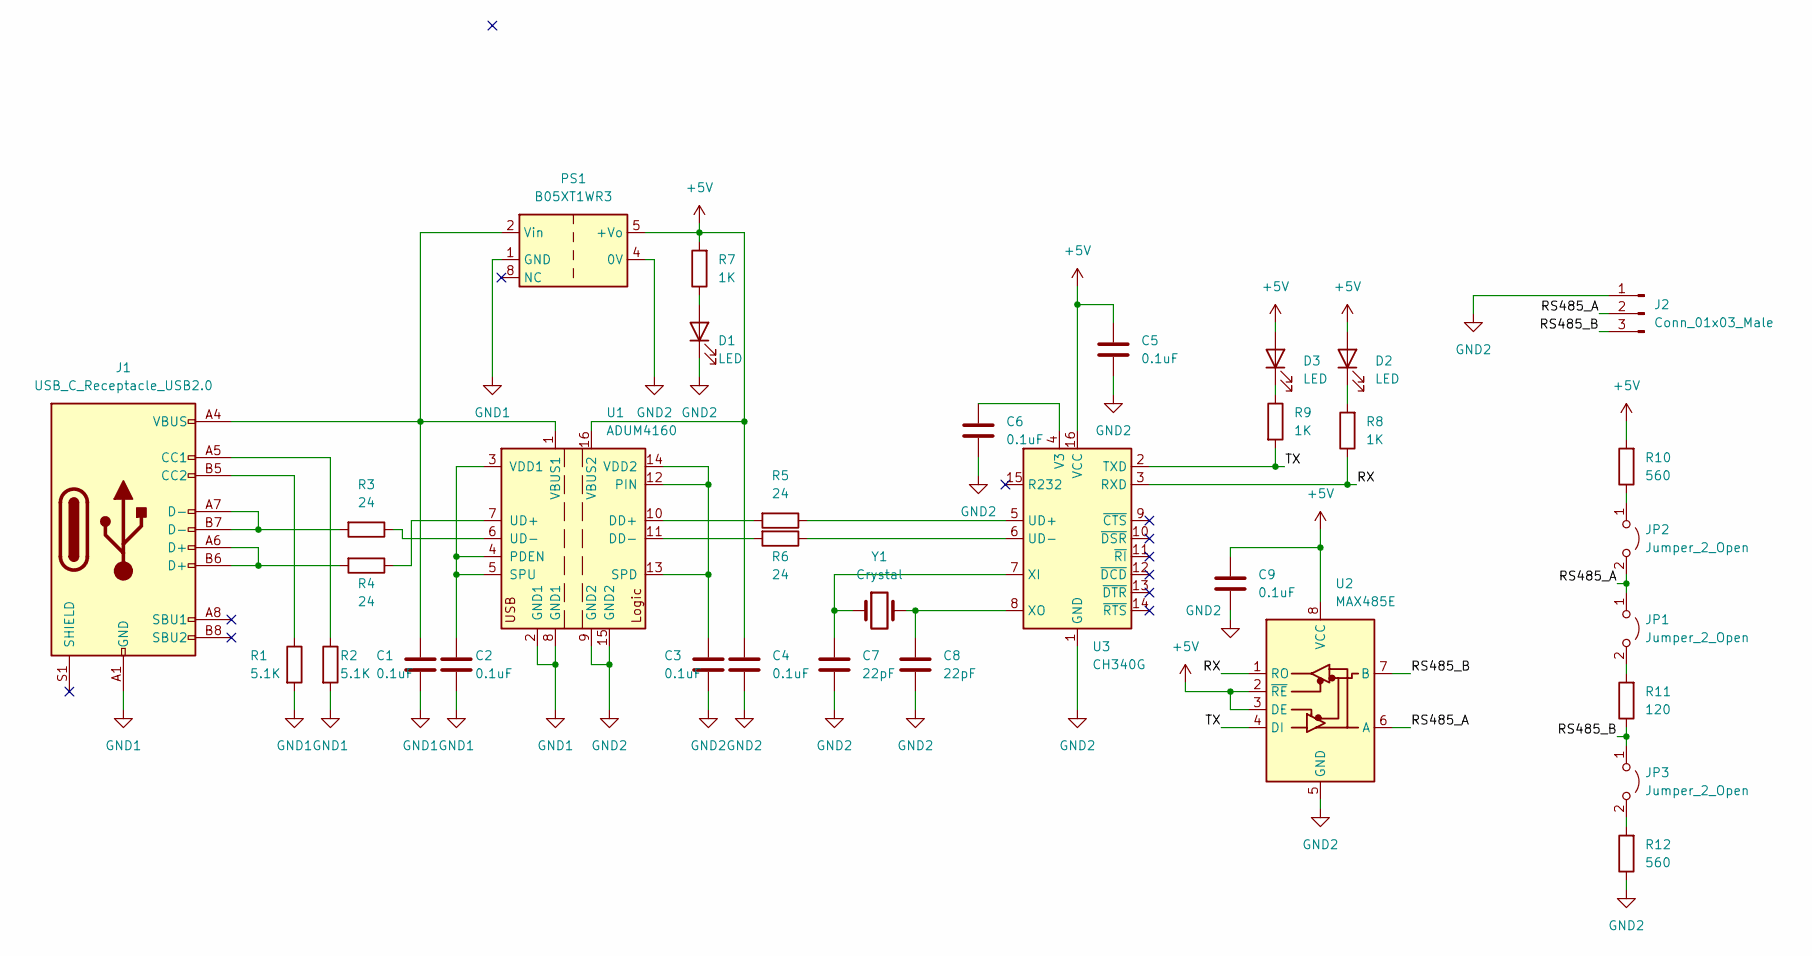
[picture p20: schematic b01_hil.kicad_sch, HIL-01 ISOLATED USB TO RS485]

Parts:
C1, C2, C3, C4, C5, C6, C9: 0.1uF; C_0805_2012Metric_Pad1.18x1.45mm_HandSolder
C7, C8: 22pF; C_0805_2012Metric_Pad1.18x1.45mm_HandSolder
D1, D2, D3: LED; D_0805_2012Metric_Pad1.15x1.40mm_HandSolder
J1: USB_C_Receptacle_USB2.0; USB_C_Receptacle_HRO_TYPE-C-31-M-12
J2: Conn_01x03_Male; TerminalBlock_4Ucon_1x03_P3.50mm_Horizontal
JP1, JP2, JP3: Jumper_2_Open; PinHeader_1x02_P2.54mm_Vertical
PS1: B05XT1WR3; Converter_DCDC_Mornsun_B05_XT_1WR3_SMD
R1, R2: 5.1K; R_0805_2012Metric_Pad1.20x1.40mm_HandSolder
R3, R4, R5, R6: 24; R_0805_2012Metric_Pad1.20x1.40mm_HandSolder
R7, R8, R9: 1K; R_0805_2012Metric_Pad1.20x1.40mm_HandSolder
R10, R12: 560; R_0805_2012Metric_Pad1.20x1.40mm_HandSolder
R11: 120; R_0805_2012Metric_Pad1.20x1.40mm_HandSolder
U1: ADUM4160; SOIC-16W_7.5x10.3mm_P1.27mm
U2: MAX485E; SOP-8_3.9x4.9mm_P1.27mm
U3: CH340G; SOIC-16_3.9x9.9mm_P1.27mm
Y1: Crystal; Crystal_SMD_HC49-SD_HandSoldering_Compact

Connections:
+5V: C4.1, C5.1, C9.1, D2.2 (A), D3.2 (A), PS1.5 (+Vo), R7.2, R10.2, U1.16 (VBUS2), U2.2 (~RE), U2.3 (DE), U2.8 (VCC), U3.16 (VCC)
/RS485_A: J2.2, JP1.1 (A), JP2.2 (B), U2.6 (A)
/RS485_B: J2.3, JP3.1 (A), R11.1, U2.7 (B)
/RX: R8.1, U2.1 (RO), U3.3 (RXD)
/TX: R9.2, U2.4 (DI), U3.2 (TXD)
GND1: C1.2, C2.2, J1.A1 (GND), J1.A12 (GND), J1.B1 (GND), J1.B12 (GND), PS1.1 (GND), R1.2, R2.2, U1.2 (GND1), U1.8 (GND1)
GND2: C3.2, C4.2, C5.2, C6.2, C7.2, C8.2, C9.2, D1.1 (K), J2.1, PS1.4 (0V), R12.1, U1.9 (GND2), U1.15 (GND2), U2.5 (GND), U3.1 (GND)
unnamed: C1.1, J1.A4 (VBUS), J1.A9 (VBUS), J1.B4 (VBUS), J1.B9 (VBUS), PS1.2 (Vin), U1.1 (VBUS1)
unnamed: C2.1, U1.3 (VDD1), U1.4 (PDEN), U1.5 (SPU)
unnamed: C3.1, U1.12 (PIN), U1.13 (SPD), U1.14 (VDD2)
unnamed: C6.1, U3.4 (V3)
unnamed: C7.1, U3.7 (XI), Y1.1
unnamed: C8.1, U3.8 (XO), Y1.2
unnamed: D1.2 (A), R7.1
unnamed: D2.1 (K), R8.2
unnamed: D3.1 (K), R9.1
unnamed: J1.A5 (CC1), R2.1
unnamed: J1.A6 (D+), J1.B6 (D+), R4.2
unnamed: J1.A7 (D-), J1.B7 (D-), R3.2
unnamed: J1.B5 (CC2), R1.1
unnamed: JP1.2 (B), R11.2
unnamed: JP2.1 (A), R10.1
unnamed: JP3.2 (B), R12.2
unnamed: R3.1, U1.6 (UD-)
unnamed: R4.1, U1.7 (UD+)
unnamed: R5.1, U3.5 (UD+)
unnamed: R5.2, U1.10 (DD+)
unnamed: R6.1, U3.6 (UD-)
unnamed: R6.2, U1.11 (DD-)

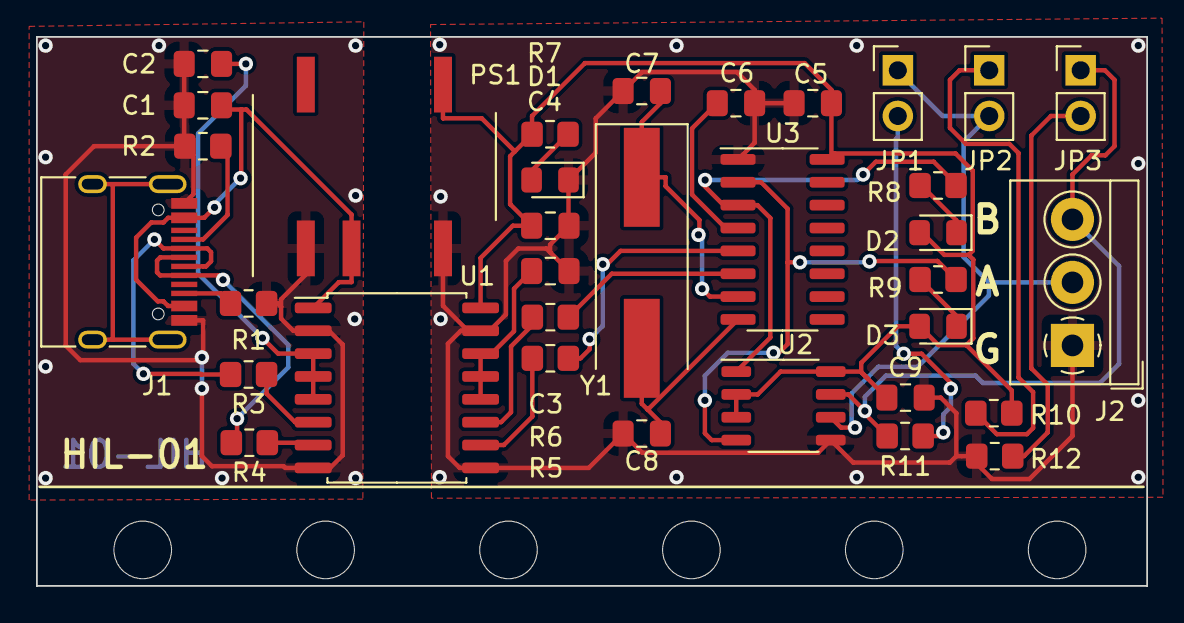
[picture p21: board b01_hil.kicad_pcb from above]

Board: 2 copper layers, 61.7 x 30.5 mm, 34 parts (0 on the bottom side), 29 nets.
