galopago/misistemhil/b-hil-boards/b03_hil/firmware/components/app_core/app_core.c

#include "app_core.h"

#include "app_core_wifi.h"
#include "board_pins.h"
#include "display.h"
#include "display_controller.h"
#include "display_geometry_test.h"
#include "error_led.h"
#include "esp_check.h"
#include "esp_log.h"
#include "i2c_bus.h"
#include "relay_ctrl.h"
#include "relay_sched.h"
#include "setup_url.h"

static const char *TAG = "app_core";

static esp_err_t resolve_oled_config(display_config_t *cfg)
{
    if (cfg == NULL) {
        return ESP_ERR_INVALID_ARG;
    }

    if (!cfg->has_address) {
        static const uint8_t candidates[] = {BOARD_OLED_ADDRESS_0, BOARD_OLED_ADDRESS_1};

        for (size_t i = 0; i < sizeof(candidates); ++i) {
            bool present = false;
            ESP_RETURN_ON_ERROR(i2c_bus_probe(candidates[i], &present), TAG,
                                "OLED probe failed for 0x%02X", candidates[i]);
            if (present) {
                cfg->address = candidates[i];
                cfg->has_address = true;
                ESP_LOGI(TAG, "OLED detected at I2C address 0x%02X", cfg->address);
                break;
            }
        }

        if (!cfg->has_address) {
            ESP_LOGW(TAG, "OLED not detected at 0x%02X or 0x%02X; starting display stub",
                     BOARD_OLED_ADDRESS_0, BOARD_OLED_ADDRESS_1);
            return ESP_OK;
        }
    }

    i2c_bus_device_t device = NULL;
    ESP_RETURN_ON_ERROR(i2c_bus_add_device(cfg->address, &device), TAG,
                        "failed to register OLED device 0x%02X", cfg->address);
    cfg->i2c_device = device;
    cfg->has_i2c_device = true;
    return ESP_OK;
}

void app_core_start(void)
{
    ESP_LOGI(TAG, "Board: %s", board_name());

    /* OE-safe relay bring-up before any long init (I2C / display / WiFi). */
    ESP_ERROR_CHECK(relay_ctrl_init());
    app_core_relay_oled_register();
    ESP_ERROR_CHECK(relay_sched_init());

    const b03_hil_board_pins_t *pins = board_pins();
    ESP_LOGI(TAG, "I2C SCL GPIO%d SDA GPIO%d", pins->i2c_scl, pins->i2c_sda);

    i2c_bus_config_t bus_config = {0};
    board_i2c_bus_config(&bus_config);
    ESP_ERROR_CHECK(i2c_bus_init(&bus_config));

    ESP_ERROR_CHECK(display_geometry_self_test());
    ESP_ERROR_CHECK(setup_url_self_test());

    display_config_t cfg = DISPLAY_CONFIG_DEFAULT();
    ESP_ERROR_CHECK(resolve_oled_config(&cfg));
    ESP_ERROR_CHECK(display_start(&cfg));
    ESP_ERROR_CHECK(display_controller_init());

    ESP_ERROR_CHECK(error_led_init());

    esp_err_t wifi_err = app_core_wifi_start();
    if (wifi_err != ESP_OK) {
        ESP_LOGW(TAG, "WiFi startup failed: %s", esp_err_to_name(wifi_err));
    }
}

esp_err_t app_core_error_led_set_pattern(error_led_pattern_t pattern)
{
    return error_led_set_pattern(pattern);
}

esp_err_t app_core_display_show_template(display_layout_template_t template_id,
                                         const char *const *lines, size_t line_count)
{
    return display_controller_show_template(template_id, lines, line_count);
}

esp_err_t app_core_display_show_qr_setup(const char *url, const char *const *text_lines,
                                         size_t text_line_count)
{
    if (!setup_url_validate(url)) {
        ESP_LOGE(TAG, "invalid QR setup URL");
        return ESP_ERR_INVALID_ARG;
    }

    return display_controller_show_qr_setup(url, text_lines, text_line_count);
}

esp_err_t app_core_relay_set(int channel, bool on)
{
    (void)relay_sched_preempt_channel(channel);
    return relay_ctrl_set(channel, on);
}

esp_err_t app_core_relay_set_mask(uint8_t mask)
{
    (void)relay_sched_preempt_all();
    return relay_ctrl_set_mask(mask);
}

esp_err_t app_core_relay_get(int channel, bool *on_out)
{
    return relay_ctrl_get(channel, on_out);
}

uint8_t app_core_relay_get_mask(void)
{
    return relay_ctrl_get_mask();
}

esp_err_t app_core_relay_pulse(int channel, uint32_t duration_ms)
{
    return relay_sched_pulse(channel, duration_ms);
}

esp_err_t app_core_relay_hold(int channel, uint32_t duration_ms)
{
    return relay_sched_hold(channel, duration_ms);
}

esp_err_t app_core_relay_release_all(void)
{
    (void)relay_sched_cancel_all();
    return relay_ctrl_set_mask(0);
}
