galopago/misistemhil/b-hil-boards/b03_hil/firmware/components/host_api/host_api_capabilities.c

#include "host_api_internal.h"

#include <stddef.h>

/* Catalog for B03_HOST_API_RELAY + B03_HOST_API_RELAY_V2_LLM. */
static const char *const k_capabilities_json =
    "{"
    "\"api_version\":1,"
    "\"board_id\":\"b03_hil\","
    "\"summary\":\"Six-channel relay HIL board with timed pulse/hold and encoder simulation\","
    "\"timing_limits\":{"
    "\"min_duration_ms\":20,"
    "\"max_pulse_ms\":4000,"
    "\"max_hold_ms\":60000,"
    "\"min_phase_ms\":20,"
    "\"min_train_period_ms\":40,"
    "\"max_phase_ms\":1000,"
    "\"max_sequence_ms\":60000,"
    "\"quad_states_per_step\":4"
    "},"
    "\"channels\":["
    "{\"channel\":1,\"label\":\"KEY_FACTORY\",\"typical_use\":\"relay_hold 10000 for erase\"},"
    "{\"channel\":3,\"label\":\"ENC_A\",\"typical_use\":\"encoder_step channel_a\"},"
    "{\"channel\":4,\"label\":\"ENC_B\",\"typical_use\":\"encoder_step channel_b\"},"
    "{\"channel\":5,\"label\":\"ENC_PULSE\",\"typical_use\":\"encoder_pulse_train\"}"
    "],"
    "\"commands\":["
    "{"
    "\"name\":\"ping\","
    "\"summary\":\"Liveness check\","
    "\"args\":[],"
    "\"result\":[{\"name\":\"pong\",\"type\":\"bool\"}]"
    "},"
    "{"
    "\"name\":\"info\","
    "\"summary\":\"Identity and STA network snapshot\","
    "\"args\":[],"
    "\"result\":["
    "{\"name\":\"api_version\",\"type\":\"int\"},"
    "{\"name\":\"board_id\",\"type\":\"string\"},"
    "{\"name\":\"board_number\",\"type\":\"string\"},"
    "{\"name\":\"identity\",\"type\":\"string\"},"
    "{\"name\":\"sta_ipv4\",\"type\":\"string\"},"
    "{\"name\":\"streams_supported\",\"type\":\"bool\"}"
    "]"
    "},"
    "{"
    "\"name\":\"capabilities\","
    "\"summary\":\"Return this capability manifest\","
    "\"args\":[],"
    "\"result\":["
    "{\"name\":\"api_version\",\"type\":\"int\"},"
    "{\"name\":\"board_id\",\"type\":\"string\"},"
    "{\"name\":\"summary\",\"type\":\"string\"},"
    "{\"name\":\"commands\",\"type\":\"object\"},"
    "{\"name\":\"streams\",\"type\":\"object\"},"
    "{\"name\":\"timing_limits\",\"type\":\"object\"}"
    "]"
    "},"
    "{"
    "\"name\":\"relay_set\","
    "\"summary\":\"Set one relay channel on or off (preempts hold/encoder on that channel)\","
    "\"args\":["
    "{\"name\":\"channel\",\"type\":\"int\",\"required\":true,\"notes\":\"Relay channel 1..6 (K1..K6)\"},"
    "{\"name\":\"on\",\"type\":\"bool\",\"required\":true,\"notes\":\"true=energize coil, false=release\"}"
    "],"
    "\"result\":["
    "{\"name\":\"channel\",\"type\":\"int\",\"notes\":\"Echo channel\"},"
    "{\"name\":\"on\",\"type\":\"bool\",\"notes\":\"Applied state\"}"
    "]"
    "},"
    "{"
    "\"name\":\"relay_set_all\","
    "\"summary\":\"Set all six relays via mask or states[6] (preempts timers/encoder)\","
    "\"args\":["
    "{\"name\":\"mask\",\"type\":\"int\",\"required\":false,\"notes\":\"0..63; bit0=ch1; XOR with states (exactly one required)\"},"
    "{\"name\":\"states\",\"type\":\"object\",\"required\":false,\"notes\":\"JSON array of 6 bools; index0=ch1; XOR with mask\"}"
    "],"
    "\"result\":["
    "{\"name\":\"mask\",\"type\":\"int\",\"notes\":\"Applied 0..63\"},"
    "{\"name\":\"states\",\"type\":\"object\",\"notes\":\"Applied array of 6 bools\"}"
    "]"
    "},"
    "{"
    "\"name\":\"relay_get\","
    "\"summary\":\"Get one relay channel commanded state\","
    "\"args\":["
    "{\"name\":\"channel\",\"type\":\"int\",\"required\":true,\"notes\":\"Relay channel 1..6\"}"
    "],"
    "\"result\":["
    "{\"name\":\"channel\",\"type\":\"int\",\"notes\":\"Echo channel\"},"
    "{\"name\":\"on\",\"type\":\"bool\",\"notes\":\"Commanded state (shadow)\"},"
    "{\"name\":\"hold_remaining_ms\",\"type\":\"int\",\"notes\":\"0 if no release timer armed\"}"
    "]"
    "},"
    "{"
    "\"name\":\"relay_get_all\","
    "\"summary\":\"Get all six relay commanded states\","
    "\"args\":[],"
    "\"result\":["
    "{\"name\":\"mask\",\"type\":\"int\",\"notes\":\"0..63 bit0=ch1\"},"
    "{\"name\":\"states\",\"type\":\"object\",\"notes\":\"Array of 6 bools; index0=ch1\"},"
    "{\"name\":\"hold_remaining_ms\",\"type\":\"object\",\"notes\":\"Array of 6 ints remaining ms\"}"
    "]"
    "},"
    "{"
    "\"name\":\"relay_pulse\","
    "\"summary\":\"Non-blocking pulse: ON then auto OFF after duration_ms\","
    "\"args\":["
    "{\"name\":\"channel\",\"type\":\"int\",\"required\":true,\"notes\":\"1..6\"},"
    "{\"name\":\"duration_ms\",\"type\":\"int\",\"required\":true,\"notes\":\"20..4000\"}"
    "],"
    "\"result\":["
    "{\"name\":\"channel\",\"type\":\"int\"},"
    "{\"name\":\"duration_ms\",\"type\":\"int\"},"
    "{\"name\":\"armed\",\"type\":\"bool\"},"
    "{\"name\":\"on\",\"type\":\"bool\"}"
    "]"
    "},"
    "{"
    "\"name\":\"relay_hold\","
    "\"summary\":\"Non-blocking hold: ON then auto OFF after duration_ms\","
    "\"args\":["
    "{\"name\":\"channel\",\"type\":\"int\",\"required\":true,\"notes\":\"1..6\"},"
    "{\"name\":\"duration_ms\",\"type\":\"int\",\"required\":true,\"notes\":\"20..60000\"}"
    "],"
    "\"result\":["
    "{\"name\":\"channel\",\"type\":\"int\"},"
    "{\"name\":\"duration_ms\",\"type\":\"int\"},"
    "{\"name\":\"armed\",\"type\":\"bool\"},"
    "{\"name\":\"on\",\"type\":\"bool\"}"
    "]"
    "},"
    "{"
    "\"name\":\"relay_hold_many\","
    "\"summary\":\"Arm multiple independent holds in one command\","
    "\"args\":["
    "{\"name\":\"items\",\"type\":\"object\",\"required\":true,\"notes\":\"Array 1..6 of {channel,duration_ms}; unique channels; duration 20..60000\"}"
    "],"
    "\"result\":["
    "{\"name\":\"armed\",\"type\":\"object\",\"notes\":\"Array of {channel,duration_ms}\"}"
    "]"
    "},"
    "{"
    "\"name\":\"relay_hold_cancel\","
    "\"summary\":\"Cancel release timer(s); channel ends OFF\","
    "\"args\":["
    "{\"name\":\"channel\",\"type\":\"int\",\"required\":false,\"notes\":\"1..6 when not all\"},"
    "{\"name\":\"all\",\"type\":\"bool\",\"required\":false,\"notes\":\"true cancels all timers and aborts encoder\"}"
    "],"
    "\"result\":["
    "{\"name\":\"cancelled\",\"type\":\"bool\"}"
    "]"
    "},"
    "{"
    "\"name\":\"relay_release_all\","
    "\"summary\":\"All OFF; cancel timers; abort encoder\","
    "\"args\":[],"
    "\"result\":["
    "{\"name\":\"mask\",\"type\":\"int\"},"
    "{\"name\":\"states\",\"type\":\"object\"}"
    "]"
    "},"
    "{"
    "\"name\":\"encoder_step\","
    "\"summary\":\"Non-blocking quadrature steps on two channels\","
    "\"args\":["
    "{\"name\":\"channel_a\",\"type\":\"int\",\"required\":true,\"notes\":\"1..6\"},"
    "{\"name\":\"channel_b\",\"type\":\"int\",\"required\":true,\"notes\":\"1..6 distinct from a\"},"
    "{\"name\":\"steps\",\"type\":\"int\",\"required\":true,\"notes\":\">=1; total steps*4*period_ms <= 60000\"},"
    "{\"name\":\"direction\",\"type\":\"string\",\"required\":true,\"notes\":\"cw or ccw\"},"
    "{\"name\":\"period_ms\",\"type\":\"int\",\"required\":true,\"notes\":\"20..1000 per quadrature phase\"}"
    "],"
    "\"result\":["
    "{\"name\":\"started\",\"type\":\"bool\"},"
    "{\"name\":\"channel_a\",\"type\":\"int\"},"
    "{\"name\":\"channel_b\",\"type\":\"int\"},"
    "{\"name\":\"steps\",\"type\":\"int\"},"
    "{\"name\":\"direction\",\"type\":\"string\"},"
    "{\"name\":\"period_ms\",\"type\":\"int\"}"
    "]"
    "},"
    "{"
    "\"name\":\"encoder_pulse_train\","
    "\"summary\":\"Non-blocking single-channel pulse train (no direction)\","
    "\"args\":["
    "{\"name\":\"channel\",\"type\":\"int\",\"required\":true,\"notes\":\"1..6\"},"
    "{\"name\":\"pulses\",\"type\":\"int\",\"required\":true,\"notes\":\">=1; pulses*period_ms <= 60000\"},"
    "{\"name\":\"period_ms\",\"type\":\"int\",\"required\":true,\"notes\":\"40..1000\"},"
    "{\"name\":\"pulse_ms\",\"type\":\"int\",\"required\":true,\"notes\":\"20..(period_ms-20)\"}"
    "],"
    "\"result\":["
    "{\"name\":\"started\",\"type\":\"bool\"},"
    "{\"name\":\"channel\",\"type\":\"int\"},"
    "{\"name\":\"pulses\",\"type\":\"int\"},"
    "{\"name\":\"period_ms\",\"type\":\"int\"},"
    "{\"name\":\"pulse_ms\",\"type\":\"int\"}"
    "]"
    "},"
    "{"
    "\"name\":\"encoder_cancel\","
    "\"summary\":\"Abort active encoder run; involved channels OFF\","
    "\"args\":[],"
    "\"result\":["
    "{\"name\":\"cancelled\",\"type\":\"bool\"}"
    "]"
    "}"
    "],"
    "\"streams\":[]"
    "}";

cJSON *host_api_capabilities_build_result(void)
{
    cJSON *root = cJSON_Parse(k_capabilities_json);
    if (root == NULL || !cJSON_IsObject(root)) {
        cJSON_Delete(root);
        return NULL;
    }
    return root;
}
