galopago/misistemhil/(commit log)

2024-02-11 started usb to 485 isolated schem
    [hil01.dsn, hil01.kicad_pcb, hil01.kicad_sch]
2024-02-13 started 6.35 screw barrier connector footprint
2024-02-19 updated rs485 footprint
    [hil01.kicad_pcb, hil01.kicad_sch]
2024-02-19 started hil-00 board
    [hil00.dsn, hil00.kicad_pcb, hil00.kicad_sch]
2024-02-21 all elements placed
    [hil00.kicad_pcb]
2024-02-25 all traces routed
    [hil00.dsn, hil00.kicad_pcb]
2024-02-25 improved vias on ground planes
    [hil00-B_Cu.gbr, hil00-B_Mask.gbr, hil00-B_Silkscreen.gbr, hil00-Edge_Cuts.gbr, hil00-F_Cu.gbr, hil00-F_Mask.gbr, hil00-F_Silkscreen.gbr, hil00-NPTH.drl]
2024-02-25 improved vias on ground planes+
    [hil00-B_Cu.gbr, hil00-B_Mask.gbr, hil00-B_Silkscreen.gbr, hil00-Edge_Cuts.gbr, hil00-F_Cu.gbr, hil00-F_Mask.gbr, hil00-F_Silkscreen.gbr, hil00-NPTH.drl]
2024-02-25 improved vias on ground planes++
    [hil00.kicad_pcb]
2024-02-25 single gerbers
    [hil00-B_Cu.gbr, hil00-B_Mask.gbr, hil00-B_Silkscreen.gbr, hil00-Edge_Cuts.gbr, hil00-F_Cu.gbr, hil00-F_Mask.gbr, hil00-F_Silkscreen.gbr, hil00-NPTH.drl]
2024-02-25 panel gerbers
    [hil00-panel-B_Cu.gbr, hil00-panel-B_Mask.gbr, hil00-panel-B_Silkscreen.gbr, hil00-panel-Edge_Cuts.gbr, hil00-panel-F_Cu.gbr, hil00-panel-F_Mask.gbr, hil00-panel-F_Silkscreen.gbr, hil00-panel-NPTH.drl]
2024-02-25 deleted unused files
    [hil01.dsn, hil01.kicad_pcb, hil01.kicad_sch]
2024-02-26 single gerber
    [hil01-B_Cu.gbr, hil01-B_Mask.gbr, hil01-B_Silkscreen.gbr, hil01-Edge_Cuts.gbr, hil01-F_Cu.gbr, hil01-F_Mask.gbr, hil01-F_Silkscreen.gbr, hil01-NPTH.drl]
2024-02-26 panel gerber
    [hil01-panel-B_Cu.gbr, hil01-panel-B_Mask.gbr, hil01-panel-B_Silkscreen.gbr, hil01-panel-Edge_Cuts.gbr, hil01-panel-F_Cu.gbr, hil01-panel-F_Mask.gbr, hil01-panel-F_Silkscreen.gbr, hil01-panel-NPTH.drl]
2024-08-05 started a00-backplate first test
    [a00_hilbackplate.kicad_pcb, a00_hilbackplate.kicad_sch, b00_hil.dsn, b00_hil.kicad_pcb, b00_hil.kicad_sch, b01_hil.dsn, b01_hil.kicad_pcb, b01_hil.kicad_sch]
2024-08-15 started label panels
    [a00_hilbackplate-B_Cu.gbr, a00_hilbackplate-B_Mask.gbr, a00_hilbackplate-B_Paste.gbr, a00_hilbackplate-B_Silkscreen.gbr, a00_hilbackplate-Edge_Cuts.gbr, a00_hilbackplate-F_Cu.gbr, a00_hilbackplate-F_Mask.gbr, a00_hilbackplate-F_Paste.gbr]
2024-08-16 added copper planes
    [-B_Cu.gbr, -B_Mask.gbr, -B_Paste.gbr, -B_Silkscreen.gbr, -Edge_Cuts.gbr, -F_Cu.gbr, -F_Mask.gbr, -F_Paste.gbr]
2024-08-16 fixed name number
    [-B_Cu.gbr, -B_Mask.gbr, -B_Paste.gbr, -B_Silkscreen.gbr, -Edge_Cuts.gbr, -F_Cu.gbr, -F_Mask.gbr, -F_Silkscreen.gbr]
2024-10-27 Changed jumper distances to be compatible with 2.54 pin headers
    [-B_Cu.gbr, -B_Mask.gbr, -B_Paste.gbr, -B_Silkscreen.gbr, -Edge_Cuts.gbr, -F_Cu.gbr, -F_Mask.gbr, -F_Paste.gbr]
2026-02-18 Start b02 HIL board card
    - Add b02_hil board: schematic, PCB, project and library files
    - Add b02 assets (datasheets, pinout, images) and gerber exports
    - Update b01_hil project files and add b01 backup archives
    [b02.kicad_pcb, b02.kicad_sch]
2026-02-23 B02 card: routing and silkscreen completed
    - PCB layout and silkscreen finished for b02_hil
    [b02.dsn, b02.kicad_pcb, b02.kicad_sch]
2026-02-23 B02 card: gerbers generated for manufacturing
    - Add gerber and drill files for b02_hil in gerber/single/
    [b02-B_Cu.gbr, b02-B_Mask.gbr, b02-B_Paste.gbr, b02-B_Silkscreen.gbr, b02-Edge_Cuts.gbr, b02-F_Cu.gbr, b02-F_Mask.gbr, b02-F_Paste.gbr]
2026-02-23 B02 card: add gerbers for panelized board
    - Generate panel gerber and drill files in gerber/panel/
    [-B_Cu.gbr, -B_Mask.gbr, -B_Paste.gbr, -B_Silkscreen.gbr, -Edge_Cuts.gbr, -F_Cu.gbr, -F_Mask.gbr, -F_Paste.gbr]
2026-02-25 B03: place all board elements (PCB and schematic)
    - Complete component placement for B03 HIL board
    - Add KiCad project, schematic and PCB layout
    - Include symbol/footprint lib tables and fp-info-cache
    - Add project libraries and assets (ESP32-C3, datasheets)
    [b03.kicad_pcb, b03.kicad_sch]
2026-02-25 B03: route all board traces
    - Complete trace routing for B03 HIL board
    - Update PCB layout (b03.kicad_pcb) and schematic (b03.kicad_sch)
    - Add routing session/export files and backups
    [b02.dsn, b03.kicad_pcb, b03.kicad_sch]
2026-02-25 B03: add Gerber output for single board
    - Create Gerber files for single-board fabrication (gerber/single/)
    - Include copper, mask, paste, silkscreen, edge cuts and drill files
    - Add b03-single.zip package for manufacturer
    [b03-B_Cu.gbr, b03-B_Mask.gbr, b03-B_Paste.gbr, b03-B_Silkscreen.gbr, b03-Edge_Cuts.gbr, b03-F_Cu.gbr, b03-F_Mask.gbr, b03-F_Paste.gbr]
2026-02-26 B04: complete trace routing for HIL board
    - Add B04 HIL board project with full PCB routing (b04.kicad_pcb, b04.kicad_sch)
    - Include KiCad project, libraries and assets (ESP32-C3, datasheets)
    - Add B03 Gerber panel output (gerber/panel/) for multi-board fabrication
    - Update backups
    [-B_Cu.gbr, -B_Mask.gbr, -B_Paste.gbr, -B_Silkscreen.gbr, -Edge_Cuts.gbr, -F_Cu.gbr, -F_Mask.gbr, -F_Paste.gbr]
2026-02-26 B04: add Gerber output for single board
    - Include copper, mask, paste, silkscreen, edge cuts and drill files (PTH/NPTH)
    - Add b04-single.zip package for manufacturer
    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
    [b04-B_Cu.gbr, b04-B_Mask.gbr, b04-B_Paste.gbr, b04-B_Silkscreen.gbr, b04-Edge_Cuts.gbr, b04-F_Cu.gbr, b04-F_Mask.gbr, b04-F_Paste.gbr]
2026-02-26 B04: add Gerber output for panel
    - Create Gerber files for panel fabrication (gerber/panel/)
    - Add b04-panel.zip package for multi-board manufacturer
    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
    [-B_Cu.gbr, -B_Mask.gbr, -B_Paste.gbr, -B_Silkscreen.gbr, -Edge_Cuts.gbr, -F_Cu.gbr, -F_Mask.gbr, -F_Paste.gbr]
2026-03-19 fix(b02): correct LED D3 polarity on schematic and PCB
    Fix reversed polarity marking/connection for D3 in b02.kicad_sch and
    b02.kicad_pcb.
    [b02.kicad_pcb, b02.kicad_sch]
2026-03-19 chore: refresh KiCad backup archives (b02, b03, b04)
    Remove superseded zip snapshots and add current backups under each
    board's *-backups folder.
2026-03-19 fix(b03): correct LED D7 polarity on schematic and PCB
    Fix reversed polarity marking/connection for D7 in b03.kicad_sch and
    b03.kicad_pcb.
    [b03.kicad_pcb, b03.kicad_sch]
2026-03-19 chore(b03): add KiCad backup archive after D7 polarity fix
    Add b03-2026-03-19_183716.zip under b03-backups.
2026-03-19 chore(b02): update single-board Gerber outputs
    Refresh layer, drill, and b02-single.zip exports under gerber/single/ for
    single-board fabrication.
    [b02-B_Cu.gbr, b02-B_Mask.gbr, b02-B_Paste.gbr, b02-B_Silkscreen.gbr, b02-Edge_Cuts.gbr, b02-F_Cu.gbr, b02-F_Mask.gbr, b02-F_Paste.gbr]
2026-03-19 chore(b02): update panel Gerber outputs
    Refresh layer, drill, and b02-panel.zip exports under gerber/panel/ for
    panelized fabrication.
    [-B_Cu.gbr, -B_Mask.gbr, -B_Paste.gbr, -B_Silkscreen.gbr, -Edge_Cuts.gbr, -F_Cu.gbr, -F_Mask.gbr, -F_Paste.gbr]
2026-03-19 chore(b03): update single-board Gerber outputs
    Refresh layer, drill, and b03-single.zip exports under gerber/single/ for
    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
    [b03-B_Cu.gbr, b03-B_Mask.gbr, b03-B_Paste.gbr, b03-B_Silkscreen.gbr, b03-Edge_Cuts.gbr, b03-F_Cu.gbr, b03-F_Mask.gbr, b03-F_Paste.gbr]
2026-03-19 chore(b03): update panel Gerber outputs
    Refresh layer, drill, and b03-panel.zip exports under gerber/panel/ for
    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
    [-B_Cu.gbr, -B_Mask.gbr, -B_Paste.gbr, -B_Silkscreen.gbr, -Edge_Cuts.gbr, -F_Cu.gbr, -F_Mask.gbr, -F_Paste.gbr]
2026-05-13 B02: invert UART indicator LED polarity; refresh KiCad backups
    - B02: reflect UART status LED polarity in schematic and PCB; update project layout.
    - B02/B03/B04: rotate KiCad automatic backup zips (remove obsolete B02 backups, add current ones).
    - B03: tweak D7 silkscreen/Fab text offsets on PCB (reference and value placement).
    [b02.kicad_pcb, b02.kicad_sch, b03.kicad_pcb]
2026-05-13 B02: update bottom silkscreen labels
    - Fix B.SilkS VCC/GND text near connector headers on b02.kicad_pcb.
    - Rotate KiCad project backup zip.
    - Remove outdated gerber/single exports.
    [b02-B_Cu.gbr, b02-B_Mask.gbr, b02-B_Paste.gbr, b02-B_Silkscreen.gbr, b02-Edge_Cuts.gbr, b02-F_Cu.gbr, b02-F_Mask.gbr, b02-F_Paste.gbr]
2026-05-13 B02: update single-board Gerber outputs
    Regenerate gerber/single package (layers, silkscreen, paste, drills, and b02-single.zip) for one-up B02 fabrication.
    [b02-B_Cu.gbr, b02-B_Mask.gbr, b02-B_Paste.gbr, b02-B_Silkscreen.gbr, b02-Edge_Cuts.gbr, b02-F_Cu.gbr, b02-F_Mask.gbr, b02-F_Paste.gbr]
2026-05-13 B02: update panel Gerber outputs
    Regenerate gerber/panel package (copper, mask, paste, silkscreen, edge cuts, drills, and b02-panel.zip) for panelized B02 fabrication.
    [-B_Cu.gbr, -B_Mask.gbr, -B_Paste.gbr, -B_Silkscreen.gbr, -Edge_Cuts.gbr, -F_Cu.gbr, -F_Mask.gbr, -F_Paste.gbr]
2026-05-13 B02: rotate KiCad project backup zip
2026-05-13 B02: refresh KiCad automatic backup zips
    Drop two older b02-backups archives and add the latest project snapshot.
2026-05-13 Add B05 HIL board KiCad project
    Introduce the new b05_hil design: schematic and PCB sources, project files,
    local symbol/footprint libraries, datasheet assets, FreeRouting artifacts
    (b02.dsn/rules/ses), KiCad automatic backups, and single/panel Gerber outputs.
    [-B_Cu.gbr, -B_Mask.gbr, -B_Paste.gbr, -B_Silkscreen.gbr, -Edge_Cuts.gbr, -F_Cu.gbr, -F_Mask.gbr, -F_Paste.gbr]
2026-05-13 d00_hil_faceplate: add initial KiCad project files
    Create the d-faceplates/d00_hil_faceplate tree with starter schematic, PCB, project and library files, fp-info-cache, and KiCad automatic backups.
    [d00_hil_faceplate.kicad_pcb, d00_hil_faceplate.kicad_sch]
2026-05-13 d01_hil_faceplate: add initial KiCad project files
    Create the d-faceplates/d01_hil_faceplate tree with starter schematic, PCB, project and library files, fp-info-cache, and KiCad automatic backups.
    [d01_hil_faceplate.kicad_pcb, d01_hil_faceplate.kicad_sch]
2026-05-13 chore: sync KiCad backups and project metadata; add B06
    - B00: refresh .kicad_pro/.kicad_prl and add latest automatic backup zips.
    - B05: rotate KiCad automatic backup zip.
    - C00 labelplate: refresh .kicad_pro/.kicad_prl and add backup zip.
    - B06: introduce new HIL KiCad project (schematic, PCB, local libraries, assets, fp cache, backups).
    [b06.kicad_pcb, b06.kicad_sch]
2026-05-13 d01_hil_faceplate: add single-board Gerber outputs
    Export gerber/single (copper, mask, paste, silkscreen, edge cuts, drills, and d01-hil-faceplate-single.zip), refresh PCB and fp-info-cache, and rotate KiCad automatic backup.
    [d01_hil_faceplate-B_Cu.gbr, d01_hil_faceplate-B_Mask.gbr, d01_hil_faceplate-B_Paste.gbr, d01_hil_faceplate-B_Silkscreen.gbr, d01_hil_faceplate-Edge_Cuts.gbr, d01_hil_faceplate-F_Cu.gbr, d01_hil_faceplate-F_Mask.gbr, d01_hil_faceplate-F_Paste.gbr]
2026-05-13 d01_hil_faceplate: add panel Gerber outputs
    Add gerber/panel exports (copper, mask, paste, silkscreen, edge cuts, drills, and d01-hil-faceplate-panel.zip) for panelized fabrication; rotate KiCad automatic backup.
    [-B_Cu.gbr, -B_Mask.gbr, -B_Paste.gbr, -B_Silkscreen.gbr, -Edge_Cuts.gbr, -F_Cu.gbr, -F_Mask.gbr, -F_Paste.gbr]
2026-05-13 d-faceplates: regenerate Gerber outputs after fabrication issues
    Previous d01_hil_faceplate panel exports were incorrect; replace the full
    gerber/panel set and packaged zip with corrected manufacturing files.
    Rotate KiCad automatic backups for d00 and d01 faceplate projects.
    [-B_Cu.gbr, -B_Mask.gbr, -B_Paste.gbr, -B_Silkscreen.gbr, -Edge_Cuts.gbr, -F_Cu.gbr, -F_Mask.gbr, -F_Paste.gbr]
2026-05-15 B06: finalize PCB routing and design data
    Complete the routed layout in b06.kicad_pcb, align schematic and project
    settings, refresh fp-info-cache and sym-lib-table, add FreeRouting exchange
    files (b06.dsn, b06.rules, b06.ses), the INA219 datasheet asset, the
    Connector_Improved library symbol, and KiCad automatic backup archives.
    [b06.dsn, b06.kicad_pcb, b06.kicad_sch]
2026-05-15 B00: add latest KiCad automatic backup
    Track new b00_hil-backups snapshot archive.
2026-05-15 d01_hil_faceplate: refresh KiCad automatic backups
    Remove two older d01_hil_faceplate-backups zips and add the latest project snapshots.
2026-05-15 d00_hil_faceplate: add single-board Gerber outputs
    Export gerber/single (copper, mask, paste, silkscreen, edge cuts, drills, and d00-hil-faceplate-single.zip), refresh PCB, and rotate KiCad automatic backups.
    [d00_hil_faceplate-B_Cu.gbr, d00_hil_faceplate-B_Mask.gbr, d00_hil_faceplate-B_Paste.gbr, d00_hil_faceplate-B_Silkscreen.gbr, d00_hil_faceplate-Edge_Cuts.gbr, d00_hil_faceplate-F_Cu.gbr, d00_hil_faceplate-F_Mask.gbr, d00_hil_faceplate-F_Paste.gbr]
2026-05-15 d00_hil_faceplate: add panel Gerber outputs
    Add gerber/panel exports (copper, mask, paste, silkscreen, edge cuts, drills, and d00-hil-faceplate-panel.zip) for panelized PCB fabrication.
    [-B_Cu.gbr, -B_Mask.gbr, -B_Paste.gbr, -B_Silkscreen.gbr, -Edge_Cuts.gbr, -F_Cu.gbr, -F_Mask.gbr, -F_Paste.gbr]
2026-05-16 B06: add single-board Gerber outputs
    Export gerber/single (copper, mask, paste, silkscreen, edge cuts, drills, and b06-single.zip) for one-up fabrication; refresh PCB, schematic, and project layout; rotate KiCad automatic backups.
    [b06-B_Cu.gbr, b06-B_Mask.gbr, b06-B_Paste.gbr, b06-B_Silkscreen.gbr, b06-Edge_Cuts.gbr, b06-F_Cu.gbr, b06-F_Mask.gbr, b06-F_Paste.gbr]
2026-05-16 B06: add panel Gerber outputs
    Add gerber/panel exports (copper, mask, paste, silkscreen, edge cuts, drills, and b06-panel.zip) for panelized PCB fabrication; rotate KiCad automatic backup.
    [-B_Cu.gbr, -B_Mask.gbr, -B_Paste.gbr, -B_Silkscreen.gbr, -Edge_Cuts.gbr, -F_Cu.gbr, -F_Mask.gbr, -F_Paste.gbr]
2026-05-22 B03: add tri-state buffer and re-route PCB
    Add 74HCT541 tri-state buffer to the schematic and re-route b03.kicad_pcb
    to integrate the new device. Update project settings, replace FreeRouting
    exchange files (b03.dsn, b03.rules, b03.ses; remove legacy b02.*), and
    rotate KiCad automatic backup archives.
    [b03.dsn, b03.kicad_pcb, b03.kicad_sch]
2026-05-22 B03: add single-board Gerber outputs
    Export gerber/single (copper, mask, paste, silkscreen, edge cuts, drills, and b03-single.zip) for one-up fabrication; refresh PCB and rotate KiCad automatic backup.
    [b03-B_Cu.gbr, b03-B_Mask.gbr, b03-B_Paste.gbr, b03-B_Silkscreen.gbr, b03-Edge_Cuts.gbr, b03-F_Cu.gbr, b03-F_Mask.gbr, b03-F_Paste.gbr]
2026-05-22 B03: add panel Gerber outputs
    Add gerber/panel exports (copper, mask, paste, silkscreen, edge cuts, drills, and b03-panel.zip) for panelized PCB fabrication.
    [-B_Cu.gbr, -B_Mask.gbr, -B_Paste.gbr, -B_Silkscreen.gbr, -Edge_Cuts.gbr, -F_Cu.gbr, -F_Mask.gbr, -F_Paste.gbr]
2026-05-25 B02: add tri-state buffer and re-route PCB
    Add 74HCT541 tri-state buffer to the schematic and re-route b02.kicad_pcb
    to integrate the new device. Update project layout, refresh FreeRouting
    exchange files (b02.dsn, b02.rules, b02.ses), and rotate KiCad automatic
    backup archives.
    [b02.dsn, b02.kicad_pcb, b02.kicad_sch]
2026-05-25 B02: add single-board Gerber outputs
    Export gerber/single (copper, mask, paste, silkscreen, edge cuts, drills, and b02-single.zip) for one-up fabrication; refresh PCB and rotate KiCad automatic backup.
    [b02-B_Cu.gbr, b02-B_Mask.gbr, b02-B_Paste.gbr, b02-B_Silkscreen.gbr, b02-Edge_Cuts.gbr, b02-F_Cu.gbr, b02-F_Mask.gbr, b02-F_Paste.gbr]
2026-05-25 B02: add panel Gerber outputs
    Add gerber/panel exports (copper, mask, paste, silkscreen, edge cuts, drills, and b02-panel.zip) for panelized PCB fabrication; rotate KiCad automatic backup.
    [-B_Cu.gbr, -B_Mask.gbr, -B_Paste.gbr, -B_Silkscreen.gbr, -Edge_Cuts.gbr, -F_Cu.gbr, -F_Mask.gbr, -F_Paste.gbr]
2026-06-20 refactor(b06): move KiCad project into pcb/ subdirectory
    [-B_Cu.gbr, -B_Mask.gbr, -B_Paste.gbr, -B_Silkscreen.gbr, -Edge_Cuts.gbr, -F_Cu.gbr, -F_Mask.gbr, -F_Paste.gbr]
2026-06-20 chore: update KiCad backups across boards and faceplates
    Replace outdated backup archives with current snapshots for b02, b03, b04, b05, and d00.
2026-06-20 Record b06_hil firmware architecture milestone and I2C foundation.
    Document ESP32-C3 board connections, portable shared I2C bus design, phased
    concurrency, agent role boundaries, and validation criteria. Add ESP-IDF
    firmware with display stack, i2c_bus phases 1-2, and architect/implementer/
    tester handoffs for this checkpoint.
2026-06-22 docs(firmware): define QR encoder spec and sporadic display layouts.
    Document http://IPv4 QR encoding with Nayuki qrcodegen, shared setup_url
    validation, and architect handoffs; clarify that QR is occasional content on
    fully dynamic text layouts, not a permanently reserved screen region.
2026-06-22 docs(firmware): define v1 printable ASCII-only display text policy.
    Document that product strings use ASCII only with no accents or other scripts;
    unsupported characters sanitize to ? at render time.
2026-06-22 docs(firmware): define read-only informational display with no menu in v1.
    Document that the OLED is one-way status output only; menus, navigation, and
    on-display data entry are out of scope for the current product architecture.
2026-06-22 docs(firmware): exclude display power management for occasional-use v1.
    Document that OLED sleep, dimming, and panel power-off are out of scope because
    the product is not intended for continuous 24/7 operation.
2026-06-22 docs(firmware): decouple display from network and pin callback transport.
    Treat QR and text as the same display instruction path through app_core;
    remove WiFi/network coupling from display architecture and select callback
    (not esp_event) as the v1 notification mechanism.
2026-06-22 docs(firmware): add implementer tasks and confirm SSD1306 for v1.
    Record five ordered implementation tasks (setup_url, app_core delivery, QR fix,
    Nayuki encoder, build handoff) and close the OLED controller open question.
2026-06-23 docs(firmware): align display architecture with implementation snapshot.
    Pin the implemented app_core display facade, QR setup path, setup_url and Nayuki
    component layout, static QR encoder behavior, and visual demo contract so future
    LLM implementers reproduce the same v1 structure.
2026-06-24 feat(b06_hil): add WiFi provisioning and OLED setup UX architecture
    Introduce the WiFi provisioning stack (credentials, captive portal, QR
    encoder, setup_url) with app_core_wifi orchestration and dynamic HIL AP
    SSID. Implement the provisioning OLED guide (QR left, split AP SSID and
    numbered join/scan instructions on the right).
    Document repeatable handoffs for OLED_PROVISIONING_SETUP_UX and
    OLED_WIFI_CONNECTED_STATUS, including the four-line connected screen
    (WIFI OK, STA IPv4, split STA MAC). Retire boot display demos and record
    implementer/tester validation notes across agent workspaces.
2026-06-24 docs(firmware): add as-built WiFi connect cycle v2 reference
    Capture operator-validated connect cycle and LED behavior in an
    implementation-ready reference, align architecture specs and handoffs,
    and mark boot lock/HOLD RESET paths as obsolete for faithful replay.
2026-06-24 feat(b06_hil): implement unified WiFi connect cycle and error LED v2
    Add infinite boot/runtime reconnect rounds with alert-phase LED feedback,
    remove saved boot lock and HOLD RESET paths, and wire GPIO8 error_led
    through app_core link_status mapping validated by operator testing.
    [app_core.c, app_core.h, app_core_wifi.c, error_led.c]
2026-06-24 feat(b06_hil): add runtime WiFi factory reset and as-built docs
    Implement GPIO7 10s credential erase via wifi_fr_mon with connect-cycle
    abort to portal, and record Run 021-validated behavior in architecture
    specs and an implementation reference for faithful replay.
    [app_core_wifi.c]
2026-06-29 feat(b06_hil): add mDNS discovery, provisioning failure UX, and WiFi docs
    Document and ship recent WiFi milestones: first-connect failure flow and UX
    (3s FAILED flash then QR restore), LAN mDNS hostname discovery matching the
    HIL-<board>-<MAC4> product identity, plus architect/tester handoffs and validation
    records through Run 017.
    Firmware: device_identity and device_discovery components, app_core_wifi
    orchestration, shared SSID identity in wifi_provisioning, espressif/mdns lockfile.
    [app_core_wifi.c]
2026-07-30 d02_hil_faceplate: add initial KiCad project and Gerbers
    Create the new d-faceplates/d02_hil_faceplate tree with schematic, PCB,
    project files, local mounting-hole library, single and panel Gerber
    exports, and KiCad automatic backups. Also rotate backup zips for
    d00_hil_faceplate, d01_hil_faceplate, and B03.
    [-B_Cu.gbr, -B_Mask.gbr, -B_Paste.gbr, -B_Silkscreen.gbr, -Edge_Cuts.gbr, -F_Cu.gbr, -F_Mask.gbr, -F_Paste.gbr]
2026-08-01 d03_hil_faceplate: add initial KiCad project and Gerbers
    Create the new d-faceplates/d03_hil_faceplate tree with schematic, PCB,
    project files, mounting-hole and panel-mount connector libraries, assets,
    single and panel Gerber exports, and KiCad automatic backups. Also add the
    latest d02_hil_faceplate backup zip.
    [-B_Cu.gbr, -B_Mask.gbr, -B_Paste.gbr, -B_Silkscreen.gbr, -Edge_Cuts.gbr, -F_Cu.gbr, -F_Mask.gbr, -F_Paste.gbr]
2026-09-10 feat(b06_hil): add external power-off switch and always-on solder jumper
    [b06.kicad_pcb, b06.kicad_sch]
2026-09-10 chore(b06_hil): sync KiCad backups and PSWI jumper schematic wiring
    [b06.kicad_sch]
2026-09-12 feat(b06_hil): update silkscreen with POWER INPUT label and ref tweaks
    [b06.kicad_pcb]
2026-09-12 feat(b06_hil): export single-board PCB Gerbers
    [b06-B_Cu.gbr, b06-B_Mask.gbr, b06-B_Paste.gbr, b06-B_Silkscreen.gbr, b06-Edge_Cuts.gbr, b06-F_Cu.gbr, b06-F_Mask.gbr, b06-F_Paste.gbr]
2026-09-12 feat(b06_hil): export panel PCB Gerbers
    [-B_Cu.gbr, -B_Mask.gbr, -B_Paste.gbr, -B_Silkscreen.gbr, -Edge_Cuts.gbr, -F_Cu.gbr, -F_Mask.gbr, -F_Paste.gbr]
2026-09-25 d04_hil_faceplate: add initial KiCad project with early components
    Create the new d-faceplates/d04_hil_faceplate tree with schematic, PCB,
    project files, local footprint libraries (mounting holes, 48x29 display,
    pluggable terminal blocks, DS-402 switch, USB-C panel mount), reference
    assets, single-board SVG/drill exports, and KiCad automatic backups.
    [d04_hil_faceplate.kicad_pcb, d04_hil_faceplate.kicad_sch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]
2026-09-29 d04_hil_faceplate: finalize components and complete PCB routing
    Place the remaining faceplate components and finish the definitive routing
    on the d04_hil_faceplate PCB. Remove the outdated single-board SVG/drill
    exports generated from the early layout and rotate KiCad automatic backups.
    [d04_hil_faceplate.kicad_pcb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]
2026-09-29 d04_hil_faceplate: export single-board PCB Gerbers
    Generate Gerber layers, PTH/NPTH drill files, and the packaged zip for the
    single-board d04_hil_faceplate from the final routing. Switch the plot
    output format to Gerber and add the latest KiCad automatic backup.
    [d04_hil_faceplate-B_Cu.gbr, d04_hil_faceplate-B_Mask.gbr, d04_hil_faceplate-B_Paste.gbr, d04_hil_faceplate-B_Silkscreen.gbr, d04_hil_faceplate-Edge_Cuts.gbr, d04_hil_faceplate-F_Cu.gbr, d04_hil_faceplate-F_Mask.gbr, d04_hil_faceplate-F_Paste.gbr]
2026-09-29 d05_hil_faceplate: finalize component placement and complete PCB routing
    [d05_hil_faceplate.kicad_pcb, d05_hil_faceplate.kicad_sch]
2026-11-03 Establish b00_basehil as the shared HIL family firmware base.
    Promote the proven b06 firmware into a contracts-first reference tree so sibling boards can reuse WiFi onboarding, discovery, and host-API docs without submodules, while keeping board-specific function and hardware descriptions separate.
2026-11-03 Mark b00_basehil firmware as stable enough to start per-board HIL development.
    Consolidate WiFi provisioning, host API, display, and reuse contracts so individual bNN boards can build on this shared base.
2026-11-03 Enlarge the factory partition on 4MB flash to give the app more space.
    Switch to a custom partitions.csv with a ~4032K single factory app so the growing WiFi/HTTP/host API image no longer fills the old 1MB slot.
2026-11-03 feat(b06_hil): add firmware for passive USB 5V 1→3 splitter metering
    Board now runs the HIL base (WiFi provisioning, mDNS HIL-06, host API) plus per-output INA219 V/I on OLED and meter_read / meter_read_all.
2026-11-04 feat(b03_hil): add six-channel relay HIL firmware with boot-safe drive and host API
    Bring up ESP-IDF firmware for board 03: family WiFi/mDNS/OLED provisioning plus relay_ctrl (74HCT541 OE sequencing) and host commands relay_set/get for six DPDT channels.
2026-11-04 feat(b03_hil): add relay scheduler, OLED view tokens, and host API v2
    Capture the current six-channel relay board stack: timed pulse/hold and encoder step/train via relay_sched, STA OLED N:[0|1|P|T|E] status, and LLM-oriented host commands on top of boot-safe drive and basic relay_set/get.
2026-11-05 fix(b03_hil): align relay OLED pairs with hardware column order
    Show channels as 1|4, 2|5, 3|6 on the STA main screen so the layout matches the physical left/right silk columns; docs and tester validation updated.
